dfdtc/KU5P_Core/KU5P_Core.kicad_pcb

## KiCad design KU5P_Core.kicad_pcb (2026-09-22)

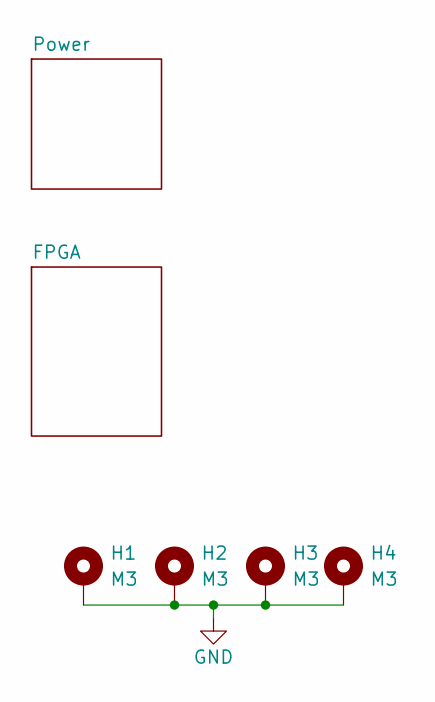
[picture p1: schematic KU5P_Core.kicad_sch]

Parts:
H1, H2, H3, H4: M3; MountingHole_3mm_Pad_TopBottom

Connections:
GND: H1.1 (1_1), H2.1 (1_1), H3.1 (1_1), H4.1 (1_1); also elsewhere on the board

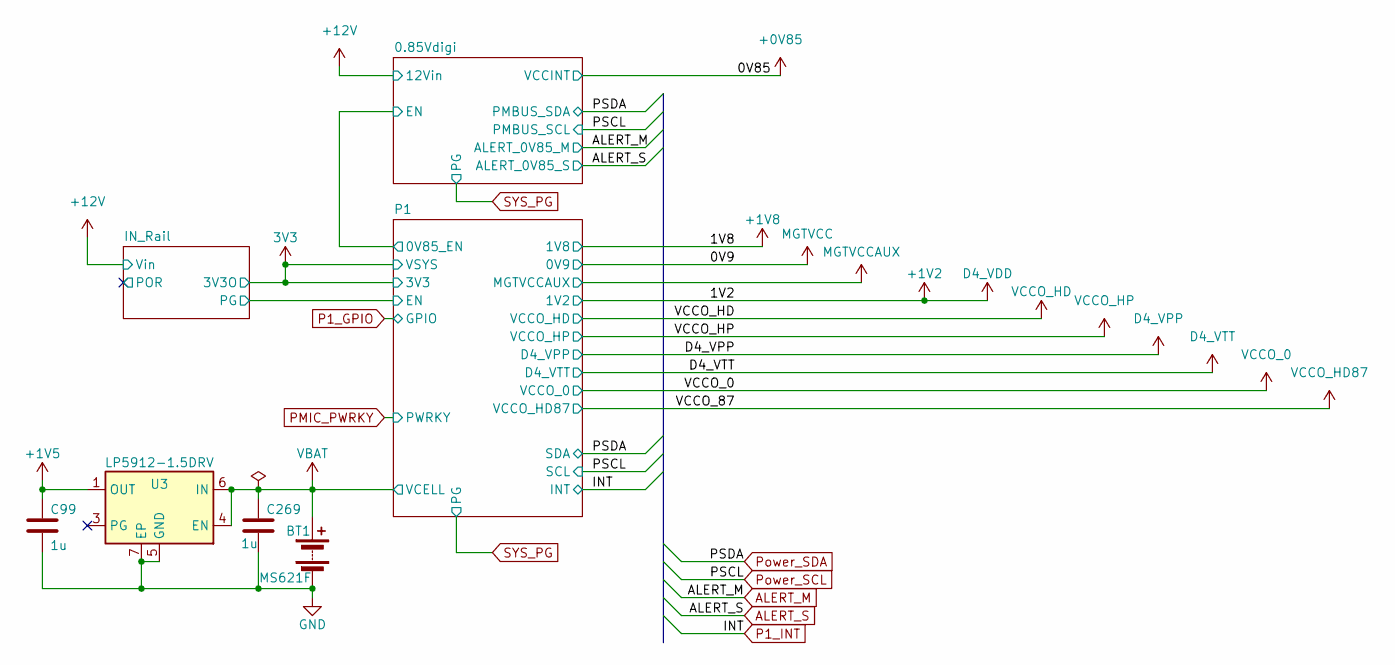
[picture p2: schematic Power.kicad_sch]

Parts:
BT1: MS621F; BatteryHolder_Seiko_MS621F
C99, C269: 1u; C_0402_1005Metric
U3: LP5912-1.5DRV; WSON-6-1EP_2x2mm_P0.65mm_EP1x1.6mm

Connections:
+1V5: C99.1, U3.1 (OUT); also elsewhere on the board
GND: BT1.2 (-), C99.2, C269.2, U3.5 (GND), U3.7 (EP); also elsewhere on the board
VBAT: BT1.1 (+), C269.1, U3.4 (EN), U3.6 (IN); also elsewhere on the board

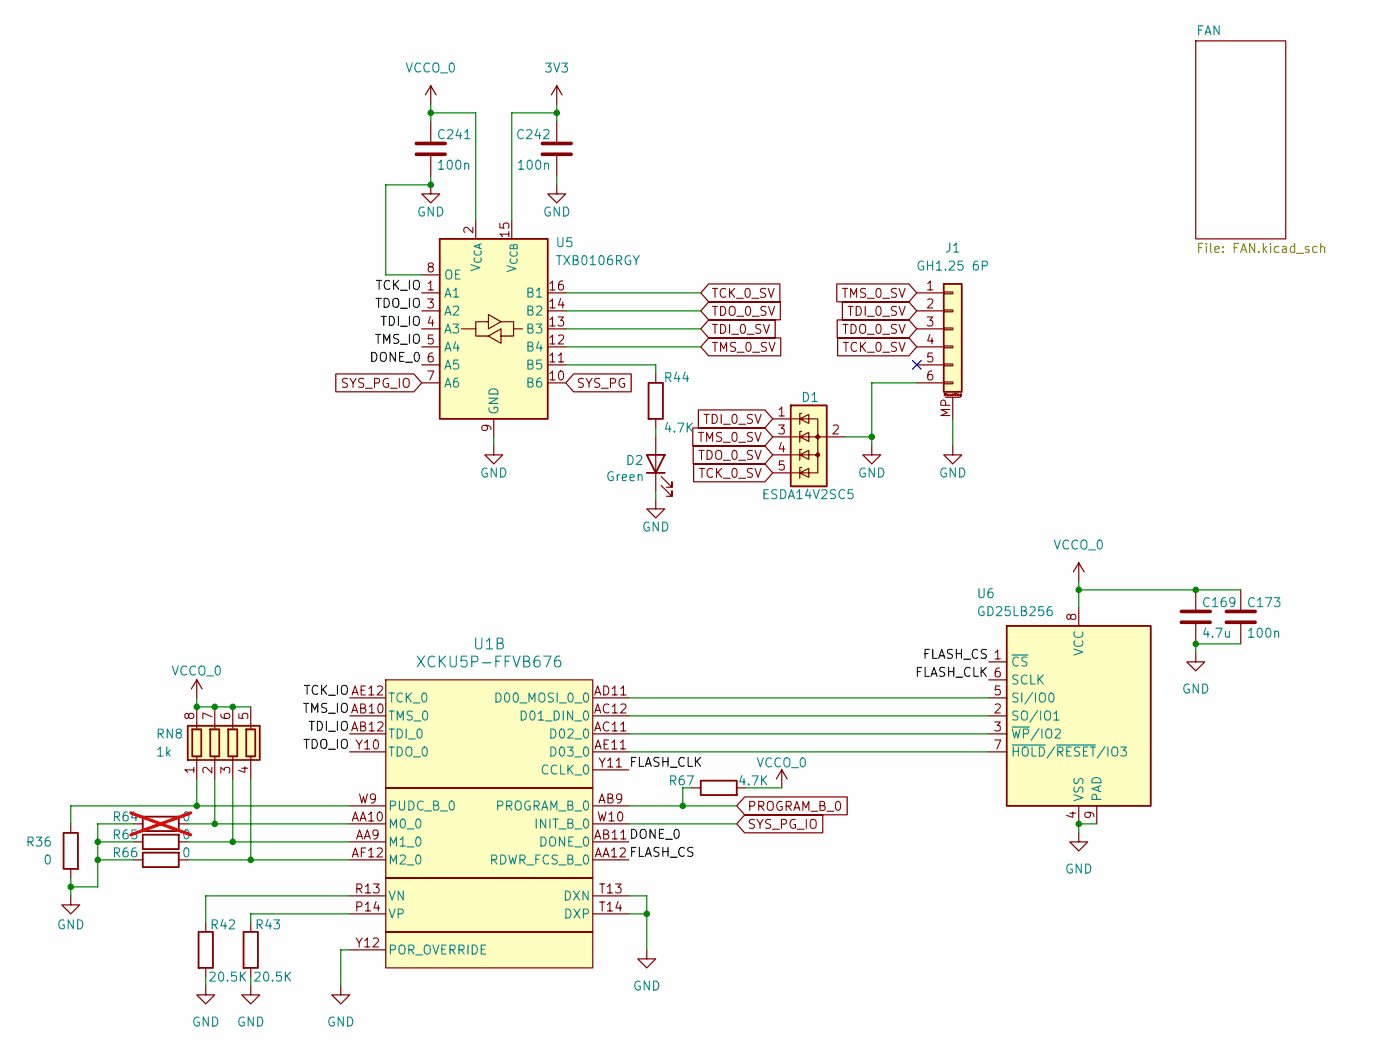
[picture p3: schematic FPGA_SYS.kicad_sch]

Parts:
C169: 4.7u; C_0201_0603Metric
C173, C241, C242: 100n; C_0201_0603Metric
D1: ESDA14V2SC5; SOT-23-5
D2: Green; LED_0603_1608Metric
J1: GH1.25 6P; JST_GH_SM06B-GHS-TB_1x06-1MP_P1.25mm_Horizontal
R36, R65, R66: 0; R_0402_1005Metric
R42, R43: 20.5K; R_0201_0603Metric
R44, R67: 4.7K; R_0201_0603Metric
R64: 0; R_0402_1005Metric; not fitted
RN8: 1k; R_Array_Concave_4x0402
U1: XCKU5P-FFVB676; Xilinx_FFG676
U5: TXB0106RGY; Texas_RGY_R-PVQFN-N16_EP2.05x2.55mm
U6: GD25LB256; WSON-8-1EP_8x6mm_P1.27mm_EP3.4x4.3mm

Connections:
3V3: C242.1, U5.15 (V_{CCB}); also elsewhere on the board
/FPGA/FPGA_SYS/DONE_0: U1.AB11 (DONE_0), U5.6 (A5)
/FPGA/FPGA_SYS/FLASH_CLK: U1.Y11 (CCLK_0), U6.6 (SCLK)
/FPGA/FPGA_SYS/FLASH_CS: U1.AA12 (RDWR_FCS_B_0), U6.1 (~CS)
/FPGA/FPGA_SYS/TCK_IO: U1.AE12 (TCK_0), U5.1 (A1)
/FPGA/FPGA_SYS/TDI_IO: U1.AB12 (TDI_0), U5.4 (A3)
/FPGA/FPGA_SYS/TDO_IO: U1.Y10 (TDO_0), U5.3 (A2)
/FPGA/FPGA_SYS/TMS_IO: U1.AB10 (TMS_0), U5.5 (A4)
GND: C169.2, C173.2, C241.2, C242.2, D1.2 (A), D2.1 (K), J1.6, J1.MP (MountPin), R36.2, R42.2, R43.2, R64.1, R65.1, R66.1, U1.T13 (DXN), U1.T14 (DXP), U1.Y12 (POR_OVERRIDE), U5.8 (OE), U5.9 (GND), U5.17 (GND), U6.4 (VSS), U6.9 (PAD); also elsewhere on the board
unnamed: D2.2 (A), R44.2
unnamed: R36.1, RN8.1 (R1.1), U1.W9 (PUDC_B_0)
unnamed: R64.2, RN8.2 (R2.1), U1.AA10 (M0_0)
unnamed: R65.2, RN8.3 (R3.1), U1.AA9 (M1_0)
unnamed: R66.2, RN8.4 (R4.1), U1.AF12 (M2_0)
unnamed: U1.AD11 (D00_MOSI_0_0), U6.5 (SI/IO0)
unnamed: U1.AC12 (D01_DIN_0), U6.2 (SO/IO1)
unnamed: U1.AC11 (D02_0), U6.3 (~WP/IO2)
unnamed: U1.AE11 (D03_0), U6.7 (~HOLD/~RESET/IO3)
unnamed: R42.1, U1.R13 (VN)
unnamed: R43.1, U1.P14 (VP)
unnamed: R44.1, U5.11 (B5)
PROGRAM_B_0: R67.1, U1.AB9 (PROGRAM_B_0); also elsewhere on the board
SYS_PG: U5.10 (B6); also elsewhere on the board
SYS_PG_IO: U1.W10 (INIT_B_0), U5.7 (A6)
TCK_0_SV: D1.5 (K), J1.4, U5.16 (B1)
TDI_0_SV: D1.1 (K), J1.2, U5.13 (B3)
TDO_0_SV: D1.4 (K), J1.3, U5.14 (B2)
TMS_0_SV: D1.3 (K), J1.1, U5.12 (B4)
VCCO_0: C169.1, C173.1, C241.1, R67.2, RN8.5 (R4.2), RN8.6 (R3.2), RN8.7 (R2.2), RN8.8 (R1.2), U5.2 (V_{CCA}), U6.8 (VCC); also elsewhere on the board

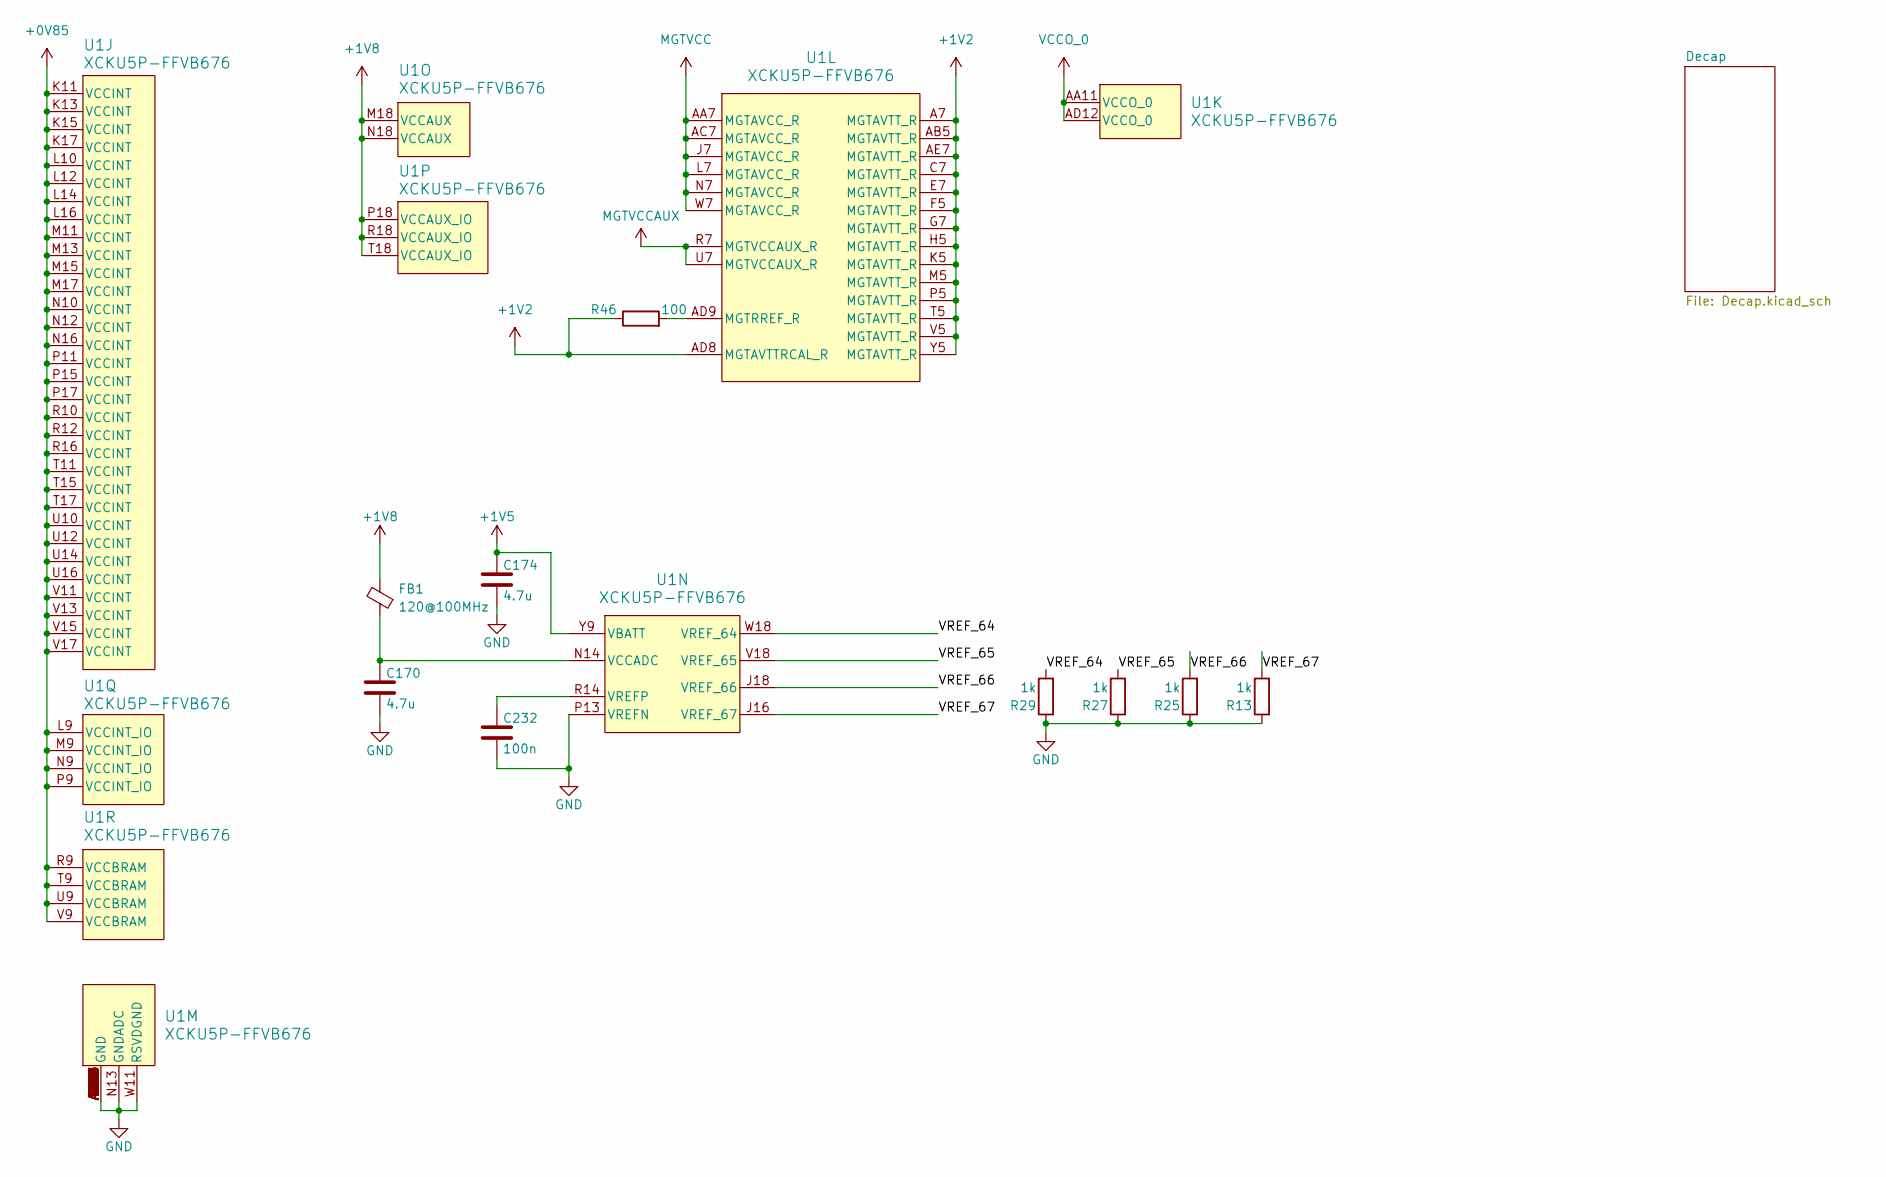
[picture p4: schematic FPGA_Power.kicad_sch]

Parts:
C170, C174: 4.7u; C_0201_0603Metric
C232: 100n; C_0201_0603Metric
FB1: 120@100MHz; C_0402_1005Metric
R13, R25, R27, R29: 1k; R_0201_0603Metric
R46: 100; C_0201_0603Metric
U1: XCKU5P-FFVB676; Xilinx_FFG676

Connections:
+0V85: U1.K11 (VCCINT), U1.K13 (VCCINT), U1.K15 (VCCINT), U1.K17 (VCCINT), U1.L9 (VCCINT_IO), U1.L10 (VCCINT), U1.L12 (VCCINT), U1.L14 (VCCINT), U1.L16 (VCCINT), U1.M9 (VCCINT_IO), U1.M11 (VCCINT), U1.M13 (VCCINT), U1.M15 (VCCINT), U1.M17 (VCCINT), U1.N9 (VCCINT_IO), U1.N10 (VCCINT), U1.N12 (VCCINT), U1.N16 (VCCINT), U1.P9 (VCCINT_IO), U1.P11 (VCCINT), U1.P15 (VCCINT), U1.P17 (VCCINT), U1.R9 (VCCBRAM), U1.R10 (VCCINT), U1.R12 (VCCINT), U1.R16 (VCCINT), U1.T9 (VCCBRAM), U1.T11 (VCCINT), U1.T15 (VCCINT), U1.T17 (VCCINT), U1.U9 (VCCBRAM), U1.U10 (VCCINT), U1.U12 (VCCINT), U1.U14 (VCCINT), U1.U16 (VCCINT), U1.V9 (VCCBRAM), U1.V11 (VCCINT), U1.V13 (VCCINT), U1.V15 (VCCINT), U1.V17 (VCCINT); also elsewhere on the board
+1V5: C174.1, U1.Y9 (VBATT); also elsewhere on the board
+1V8: FB1.2, U1.M18 (VCCAUX), U1.N18 (VCCAUX), U1.P18 (VCCAUX_IO), U1.R18 (VCCAUX_IO), U1.T18 (VCCAUX_IO); also elsewhere on the board
/FPGA/FPGA_Power/VREF_64: R29.2, U1.W18 (VREF_64)
/FPGA/FPGA_Power/VREF_65: R27.2, U1.V18 (VREF_65)
/FPGA/FPGA_Power/VREF_66: R25.2, U1.J18 (VREF_66)
/FPGA/FPGA_Power/VREF_67: R13.2, U1.J16 (VREF_67)
GND: C170.2, C174.2, C232.2, R13.1, R25.1, R27.1, R29.1, U1.A1 (GND), U1.A2 (GND), U1.A5 (GND), U1.A6 (GND), U1.A8 (GND), U1.A11 (GND), U1.A16 (GND), U1.A21 (GND), U1.A26 (GND), U1.AA1 (GND), U1.AA2 (GND), U1.AA3 (GND), U1.AA6 (GND), U1.AA8 (GND), U1.AA16 (GND), U1.AA26 (GND), U1.AB3 (GND), U1.AB4 (GND), U1.AB8 (GND), U1.AB13 (GND), U1.AB23 (GND), U1.AC1 (GND), U1.AC2 (GND), U1.AC3 (GND), U1.AC6 (GND), U1.AC8 (GND), U1.AC9 (GND), U1.AC10 (GND), U1.AC20 (GND), U1.AC25 (GND), U1.AD3 (GND), U1.AD4 (GND), U1.AD5 (GND), U1.AD10 (GND), U1.AD17 (GND), U1.AE1 (GND), U1.AE2 (GND), U1.AE5 (GND), U1.AE6 (GND), U1.AE10 (GND), U1.AE14 (GND), U1.AE19 (GND), U1.AE24 (GND), U1.AF3 (GND), U1.AF4 (GND), U1.AF5 (GND), U1.AF8 (GND), U1.AF9 (GND), U1.AF10 (GND), U1.AF11 (GND), U1.AF16 (GND), U1.AF21 (GND), U1.AF26 (GND), U1.B3 (GND), U1.B4 (GND), U1.B5 (GND), U1.B8 (GND), U1.B13 (GND), U1.B18 (GND), U1.B23 (GND), U1.C1 (GND), U1.C2 (GND), U1.C5 (GND), U1.C6 (GND), U1.C8 (GND), U1.C10 (GND), U1.C15 (GND), U1.C25 (GND), U1.D3 (GND), U1.D4 (GND), U1.D5 (GND), U1.D8 (GND), U1.D12 (GND), U1.D22 (GND), U1.E1 (GND), U1.E2 (GND), U1.E3 (GND), U1.E6 (GND), U1.E8 (GND), U1.E19 (GND), U1.F3 (GND), U1.F4 (GND), U1.F8 (GND), U1.F11 (GND), U1.F16 (GND), U1.F21 (GND), U1.F26 (GND), U1.G1 (GND), U1.G2 (GND), U1.G3 (GND), U1.G6 (GND), U1.G8 (GND), U1.G13 (GND), U1.G23 (GND), U1.H3 (GND), U1.H4 (GND), U1.H8 (GND), U1.H20 (GND), U1.J1 (GND), U1.J2 (GND), U1.J3 (GND), U1.J6 (GND), U1.J8 (GND), U1.J17 (GND), U1.K3 (GND), U1.K4 (GND), U1.K8 (GND), U1.K12 (GND), U1.K14 (GND), U1.K16 (GND), U1.K19 (GND), U1.K24 (GND), U1.L1 (GND), U1.L2 (GND), U1.L3 (GND), U1.L6 (GND), U1.L8 (GND), U1.L11 (GND), U1.L13 (GND), U1.L15 (GND), U1.L17 (GND), U1.L21 (GND), U1.L26 (GND), U1.M3 (GND), U1.M4 (GND), U1.M8 (GND), U1.M10 (GND), U1.M12 (GND), U1.M14 (GND), U1.M16 (GND), U1.M23 (GND), U1.N1 (GND), U1.N2 (GND), U1.N3 (GND), U1.N6 (GND), U1.N8 (GND), U1.N11 (GND), U1.N13 (GNDADC), U1.N15 (GND), U1.N17 (GND), U1.N20 (GND), U1.N25 (GND), U1.P3 (GND), U1.P4 (GND), U1.P8 (GND), U1.P10 (GND), U1.P12 (GND), U1.P13 (VREFN), U1.P16 (GND), U1.R1 (GND), U1.R2 (GND), U1.R3 (GND), U1.R6 (GND), U1.R8 (GND), U1.R11 (GND), U1.R15 (GND), U1.R17 (GND), U1.R19 (GND), U1.R24 (GND), U1.T3 (GND), U1.T4 (GND), U1.T8 (GND), U1.T10 (GND), U1.T12 (GND), U1.T16 (GND), U1.T21 (GND), U1.T26 (GND), U1.U1 (GND), U1.U2 (GND), U1.U3 (GND), U1.U6 (GND), U1.U8 (GND), U1.U11 (GND), U1.U13 (GND), U1.U15 (GND), U1.U17 (GND), U1.U18 (GND), U1.V3 (GND), U1.V4 (GND), U1.V8 (GND), U1.V10 (GND), U1.V12 (GND), U1.V14 (GND), U1.V16 (GND), U1.V20 (GND), U1.V25 (GND), U1.W1 (GND), U1.W2 (GND), U1.W3 (GND), U1.W6 (GND), U1.W8 (GND), U1.W11 (RSVDGND), U1.W17 (GND), U1.W22 (GND), U1.Y3 (GND), U1.Y4 (GND), U1.Y8 (GND), U1.Y19 (GND); also elsewhere on the board
MGTVCC: U1.AA7 (MGTAVCC_R), U1.AC7 (MGTAVCC_R), U1.J7 (MGTAVCC_R), U1.L7 (MGTAVCC_R), U1.N7 (MGTAVCC_R), U1.W7 (MGTAVCC_R); also elsewhere on the board
MGTVCCAUX: U1.R7 (MGTVCCAUX_R), U1.U7 (MGTVCCAUX_R); also elsewhere on the board
unnamed: R46.2, U1.AD9 (MGTRREF_R)
unnamed: C170.1, FB1.1, U1.N14 (VCCADC)
unnamed: C232.1, U1.R14 (VREFP)
VCCO_0: U1.AA11 (VCCO_0), U1.AD12 (VCCO_0); also elsewhere on the board

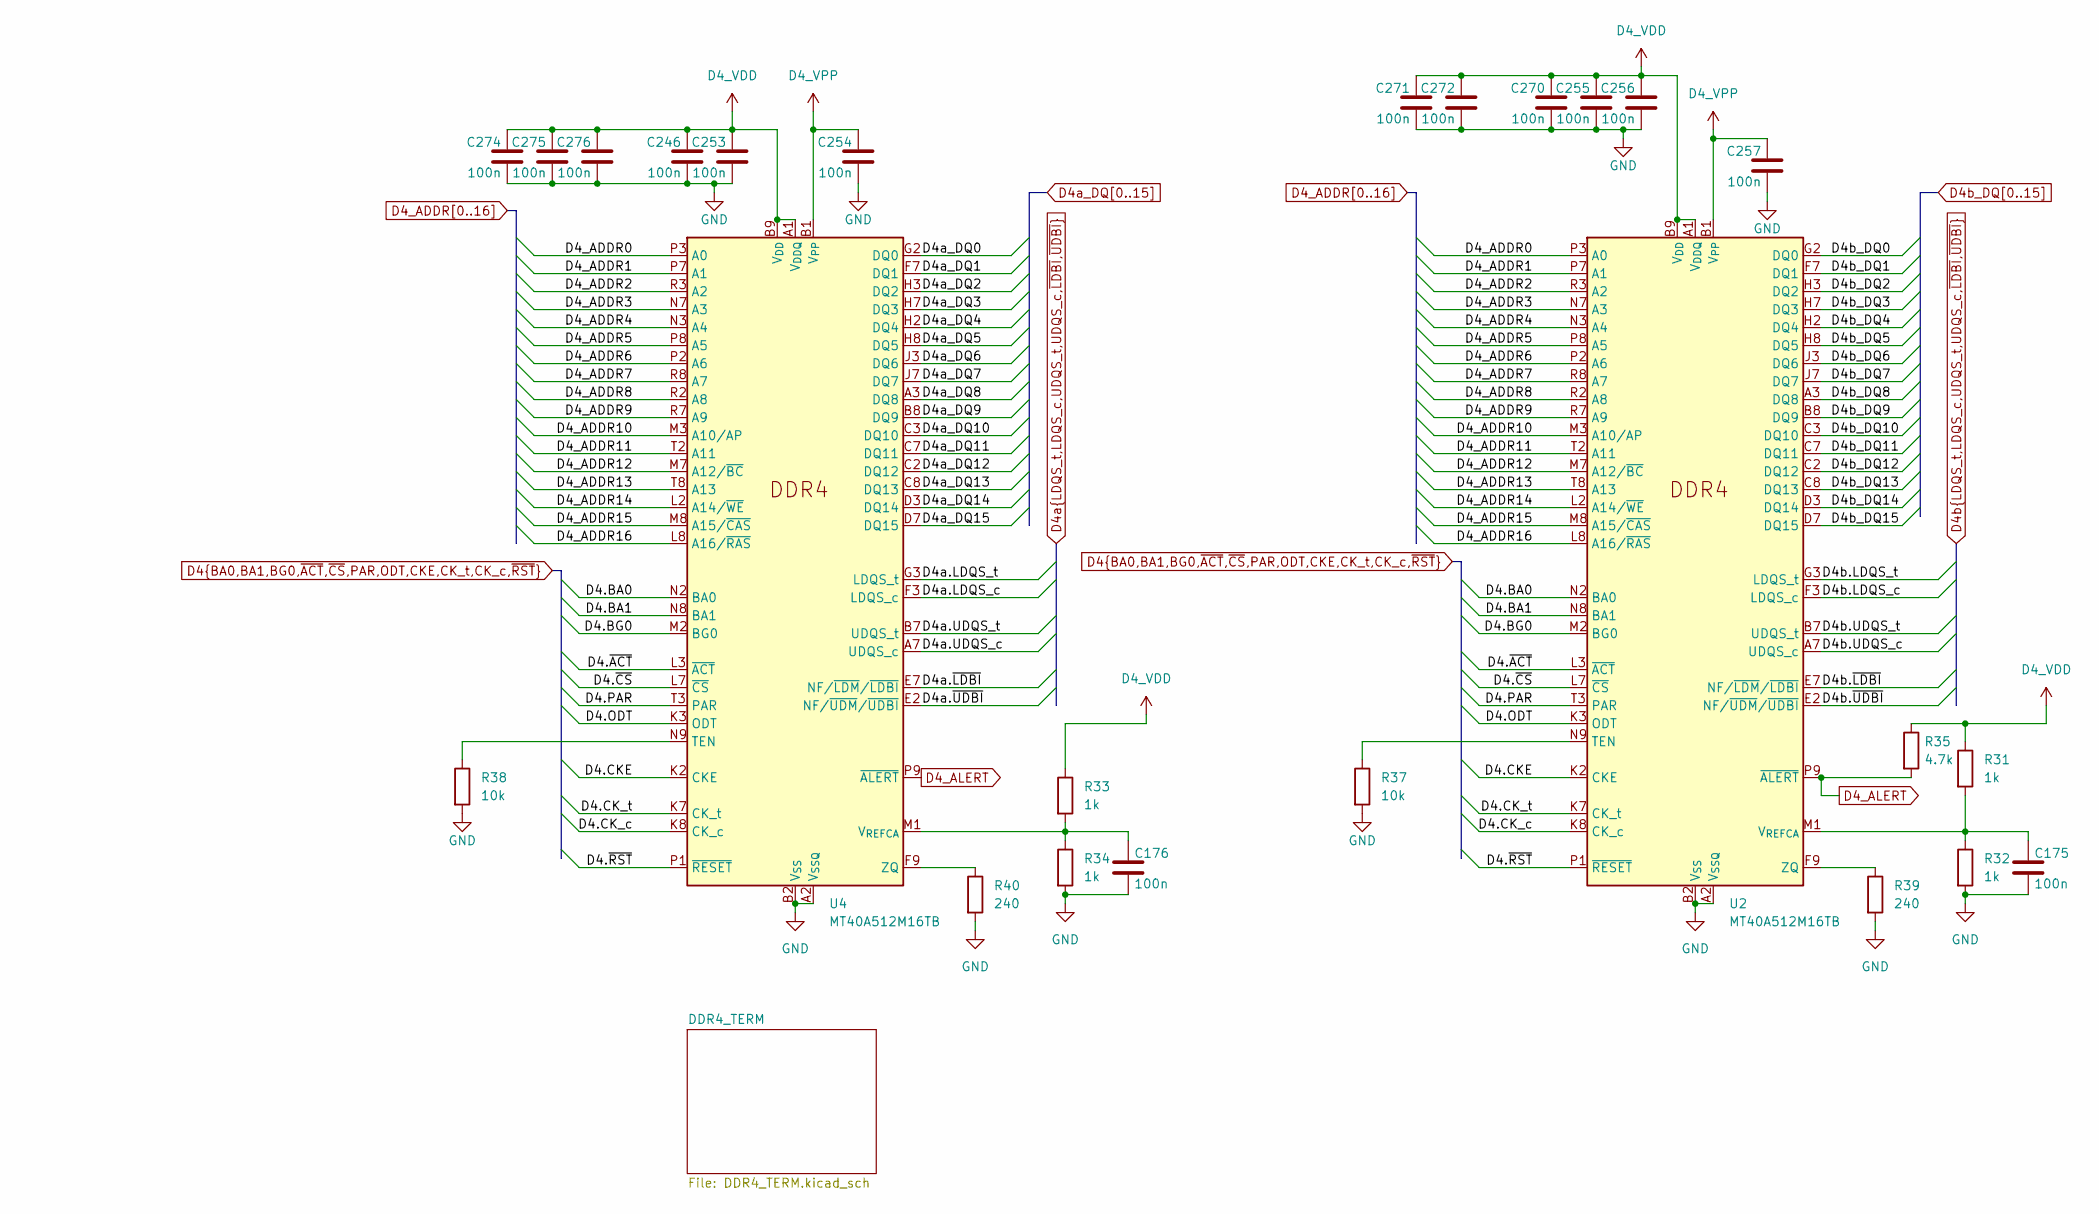
[picture p5: schematic DDR4.kicad_sch]

Parts:
C175, C176, C246, C253, C254, C255, C256, C257, C270, C271, C272, C274, C275, C276: 100n; C_0201_0603Metric
R31, R32, R33, R34: 1k; R_0201_0603Metric
R35: 4.7k; R_0201_0603Metric
R37, R38: 10k; R_0201_0603Metric
R39, R40: 240; R_0201_0603Metric
U2, U4: MT40A512M16TB; FBGA-96_7.5x13mm_Layout9x16_P0.8mm

Connections:
D4.BA0: U2.N2 (BA0), U4.N2 (BA0); also elsewhere on the board
D4.BA1: U2.N8 (BA1), U4.N8 (BA1); also elsewhere on the board
D4.BG0: U2.M2 (BG0), U4.M2 (BG0); also elsewhere on the board
D4.CKE: U2.K2 (CKE), U4.K2 (CKE); also elsewhere on the board
D4.CK_c: U2.K8 (CK_c), U4.K8 (CK_c); also elsewhere on the board
D4.CK_t: U2.K7 (CK_t), U4.K7 (CK_t); also elsewhere on the board
D4.ODT: U2.K3 (ODT), U4.K3 (ODT); also elsewhere on the board
D4.PAR: U2.T3 (PAR), U4.T3 (PAR); also elsewhere on the board
D4.~ACT: U2.L3 (~ACT), U4.L3 (~ACT); also elsewhere on the board
D4.~CS: U2.L7 (~CS), U4.L7 (~CS); also elsewhere on the board
D4.~RST: U2.P1 (~RESET), U4.P1 (~RESET); also elsewhere on the board
D4_ADDR0: U2.P3 (A0), U4.P3 (A0); also elsewhere on the board
D4_ADDR1: U2.P7 (A1), U4.P7 (A1); also elsewhere on the board
D4_ADDR2: U2.R3 (A2), U4.R3 (A2); also elsewhere on the board
D4_ADDR3: U2.N7 (A3), U4.N7 (A3); also elsewhere on the board
D4_ADDR4: U2.N3 (A4), U4.N3 (A4); also elsewhere on the board
D4_ADDR5: U2.P8 (A5), U4.P8 (A5); also elsewhere on the board
D4_ADDR6: U2.P2 (A6), U4.P2 (A6); also elsewhere on the board
D4_ADDR7: U2.R8 (A7), U4.R8 (A7); also elsewhere on the board
D4_ADDR8: U2.R2 (A8), U4.R2 (A8); also elsewhere on the board
D4_ADDR9: U2.R7 (A9), U4.R7 (A9); also elsewhere on the board
D4_ADDR10: U2.M3 (A10/AP), U4.M3 (A10/AP); also elsewhere on the board
D4_ADDR11: U2.T2 (A11), U4.T2 (A11); also elsewhere on the board
D4_ADDR12: U2.M7 (A12/~BC), U4.M7 (A12/~BC); also elsewhere on the board
D4_ADDR13: U2.T8 (A13), U4.T8 (A13); also elsewhere on the board
D4_ADDR14: U2.L2 (A14/~WE), U4.L2 (A14/~WE); also elsewhere on the board
D4_ADDR15: U2.M8 (A15/~CAS), U4.M8 (A15/~CAS); also elsewhere on the board
D4_ADDR16: U2.L8 (A16/~RAS), U4.L8 (A16/~RAS); also elsewhere on the board
D4_ALERT: R35.2, U2.P9 (~ALERT), U4.P9 (~ALERT)
D4_VPP: C254.1, C257.1, U2.B1 (V_{PP}), U2.R9 (V_{PP}), U4.B1 (V_{PP}), U4.R9 (V_{PP}); also elsewhere on the board
D4a.LDQS_c: U4.F3 (LDQS_c); also elsewhere on the board
D4a.LDQS_t: U4.G3 (LDQS_t); also elsewhere on the board
D4a.UDQS_c: U4.A7 (UDQS_c); also elsewhere on the board
D4a.UDQS_t: U4.B7 (UDQS_t); also elsewhere on the board
D4a.~LDBI: U4.E7 (NF/~LDM/~LDBI); also elsewhere on the board
D4a.~UDBI: U4.E2 (NF/~UDM/~UDBI); also elsewhere on the board
D4a_DQ0: U4.G2 (DQ0); also elsewhere on the board
D4a_DQ1: U4.F7 (DQ1); also elsewhere on the board
D4a_DQ2: U4.H3 (DQ2); also elsewhere on the board
D4a_DQ3: U4.H7 (DQ3); also elsewhere on the board
D4a_DQ4: U4.H2 (DQ4); also elsewhere on the board
D4a_DQ5: U4.H8 (DQ5); also elsewhere on the board
D4a_DQ6: U4.J3 (DQ6); also elsewhere on the board
D4a_DQ7: U4.J7 (DQ7); also elsewhere on the board
D4a_DQ8: U4.A3 (DQ8); also elsewhere on the board
D4a_DQ9: U4.B8 (DQ9); also elsewhere on the board
D4a_DQ10: U4.C3 (DQ10); also elsewhere on the board
D4a_DQ11: U4.C7 (DQ11); also elsewhere on the board
D4a_DQ12: U4.C2 (DQ12); also elsewhere on the board
D4a_DQ13: U4.C8 (DQ13); also elsewhere on the board
D4a_DQ14: U4.D3 (DQ14); also elsewhere on the board
D4a_DQ15: U4.D7 (DQ15); also elsewhere on the board
D4b.LDQS_c: U2.F3 (LDQS_c); also elsewhere on the board
D4b.LDQS_t: U2.G3 (LDQS_t); also elsewhere on the board
D4b.UDQS_c: U2.A7 (UDQS_c); also elsewhere on the board
D4b.UDQS_t: U2.B7 (UDQS_t); also elsewhere on the board
D4b.~LDBI: U2.E7 (NF/~LDM/~LDBI); also elsewhere on the board
D4b.~UDBI: U2.E2 (NF/~UDM/~UDBI); also elsewhere on the board
D4b_DQ0: U2.G2 (DQ0); also elsewhere on the board
D4b_DQ1: U2.F7 (DQ1); also elsewhere on the board
D4b_DQ2: U2.H3 (DQ2); also elsewhere on the board
D4b_DQ3: U2.H7 (DQ3); also elsewhere on the board
D4b_DQ4: U2.H2 (DQ4); also elsewhere on the board
D4b_DQ5: U2.H8 (DQ5); also elsewhere on the board
D4b_DQ6: U2.J3 (DQ6); also elsewhere on the board
D4b_DQ7: U2.J7 (DQ7); also elsewhere on the board
D4b_DQ8: U2.A3 (DQ8); also elsewhere on the board
D4b_DQ9: U2.B8 (DQ9); also elsewhere on the board
D4b_DQ10: U2.C3 (DQ10); also elsewhere on the board
D4b_DQ11: U2.C7 (DQ11); also elsewhere on the board
D4b_DQ12: U2.C2 (DQ12); also elsewhere on the board
D4b_DQ13: U2.C8 (DQ13); also elsewhere on the board
D4b_DQ14: U2.D3 (DQ14); also elsewhere on the board
D4b_DQ15: U2.D7 (DQ15); also elsewhere on the board
GND: C175.2, C176.2, C246.2, C253.2, C254.2, C255.2, C256.2, C257.2, C270.2, C271.2, C272.2, C274.2, C275.2, C276.2, R32.2, R34.2, R37.2, R38.2, R39.2, R40.2, U2.A2 (V_{SSQ}), U2.A8 (V_{SSQ}), U2.B2 (V_{SS}), U2.C9 (V_{SSQ}), U2.D2 (V_{SSQ}), U2.D8 (V_{SSQ}), U2.E1 (V_{SS}), U2.E3 (V_{SSQ}), U2.E8 (V_{SSQ}), U2.E9 (V_{SS}), U2.F1 (V_{SSQ}), U2.G8 (V_{SS}), U2.H1 (V_{SSQ}), U2.H9 (V_{SSQ}), U2.K1 (V_{SS}), U2.K9 (V_{SS}), U2.M9 (V_{SS}), U2.N1 (V_{SS}), U2.T1 (V_{SS}), U4.A2 (V_{SSQ}), U4.A8 (V_{SSQ}), U4.B2 (V_{SS}), U4.C9 (V_{SSQ}), U4.D2 (V_{SSQ}), U4.D8 (V_{SSQ}), U4.E1 (V_{SS}), U4.E3 (V_{SSQ}), U4.E8 (V_{SSQ}), U4.E9 (V_{SS}), U4.F1 (V_{SSQ}), U4.G8 (V_{SS}), U4.H1 (V_{SSQ}), U4.H9 (V_{SSQ}), U4.K1 (V_{SS}), U4.K9 (V_{SS}), U4.M9 (V_{SS}), U4.N1 (V_{SS}), U4.T1 (V_{SS}); also elsewhere on the board
unnamed: R37.1, U2.N9 (TEN)
unnamed: C175.1, R31.2, R32.1, U2.M1 (V_{REFCA})
unnamed: R39.1, U2.F9 (ZQ)
unnamed: R38.1, U4.N9 (TEN)
unnamed: C176.1, R33.2, R34.1, U4.M1 (V_{REFCA})
unnamed: R40.1, U4.F9 (ZQ)

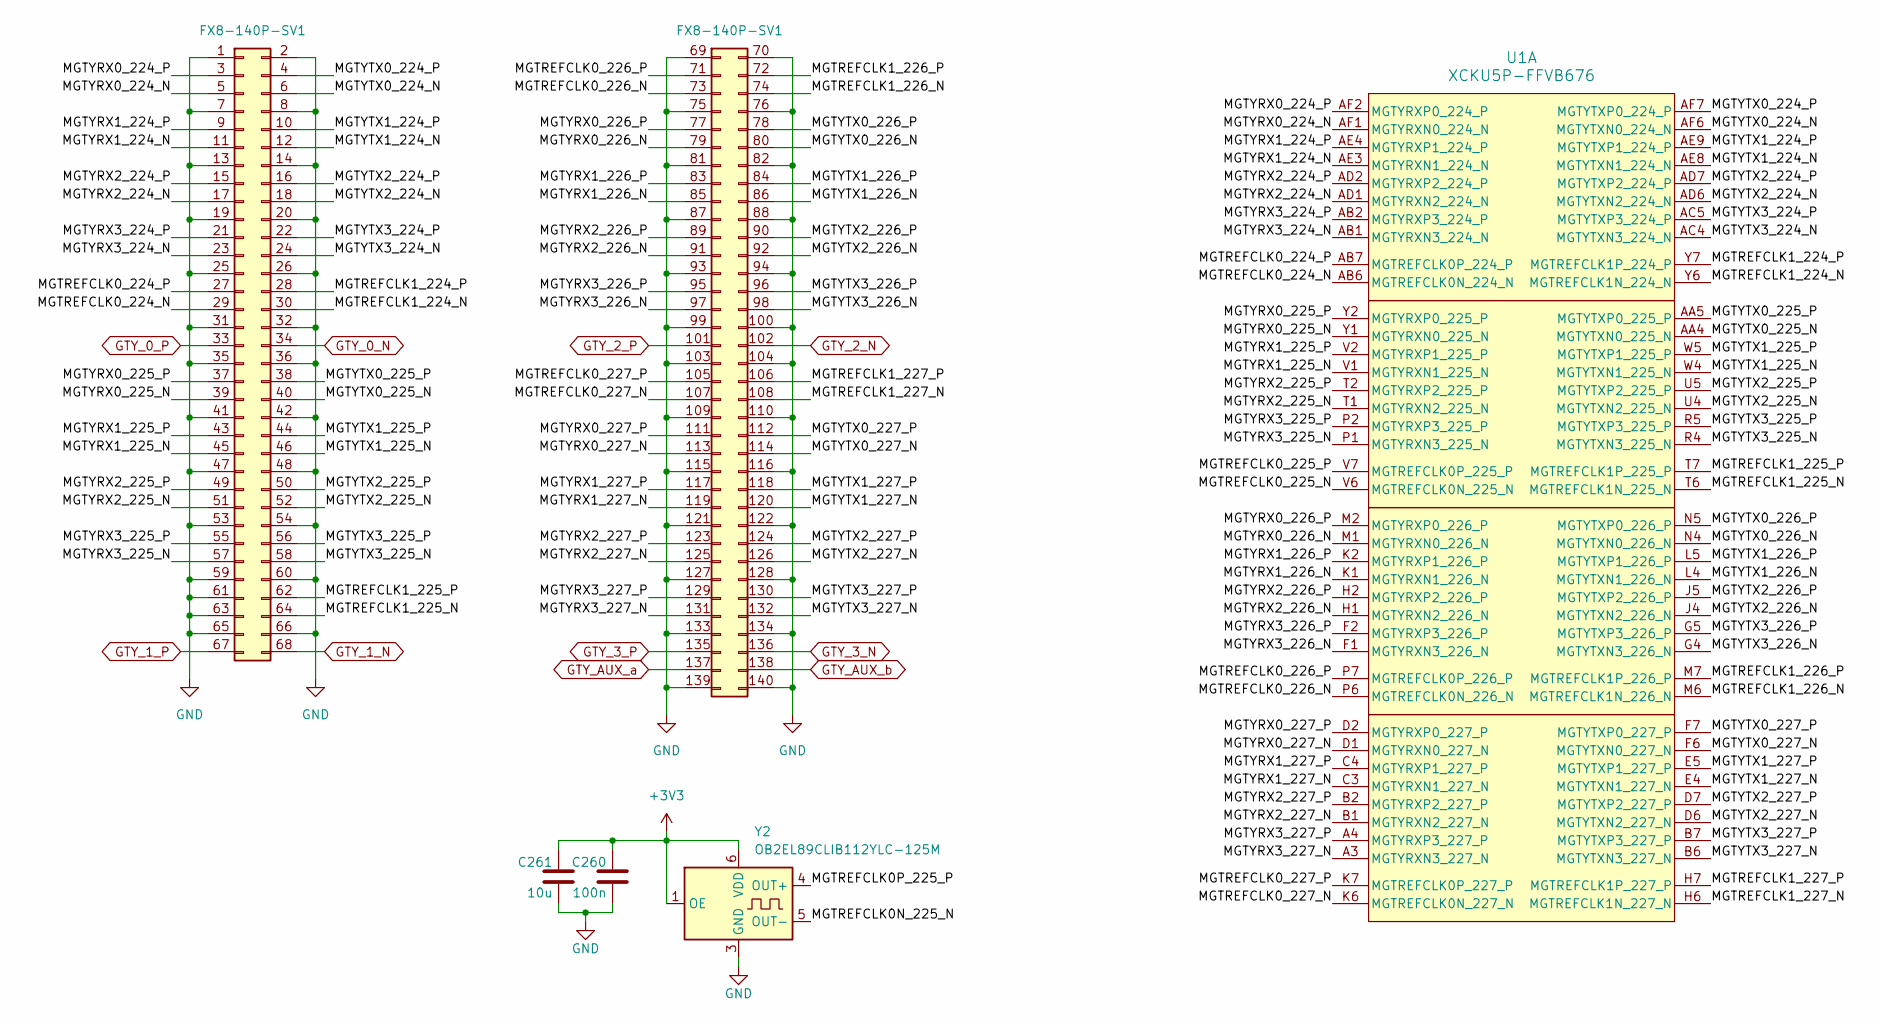
[picture p6: schematic GTY.kicad_sch]

Parts:
C260: 100n; C_0201_0603Metric
C261: 10u; C_0603_1608Metric
J5: FX8-140P-SV1; Hirose_FX8-140P-SV_2x70_P0.6mm
U1: XCKU5P-FFVB676; Xilinx_FFG676
Y2: OB2EL89CLIB112YLC-125M; Oscillator_SMD_SiTime_PQFD-6L_3.2x2.5mm

Connections:
+3V3: C260.1, C261.1, Y2.1 (OE), Y2.6 (VDD); also elsewhere on the board
/FPGA/GTY/MGTREFCLK0N_225_N: Y2.5 (OUT-)
/FPGA/GTY/MGTREFCLK0P_225_P: Y2.4 (OUT+)
/FPGA/GTY/MGTREFCLK0_224_N: J5.29, U1.AB6 (MGTREFCLK0N_224_N)
/FPGA/GTY/MGTREFCLK0_224_P: J5.27, U1.AB7 (MGTREFCLK0P_224_P)
/FPGA/GTY/MGTREFCLK0_225_N: U1.V6 (MGTREFCLK0N_225_N)
/FPGA/GTY/MGTREFCLK0_225_P: U1.V7 (MGTREFCLK0P_225_P)
/FPGA/GTY/MGTREFCLK0_226_N: J5.73, U1.P6 (MGTREFCLK0N_226_N)
/FPGA/GTY/MGTREFCLK0_226_P: J5.71, U1.P7 (MGTREFCLK0P_226_P)
/FPGA/GTY/MGTREFCLK0_227_N: J5.107, U1.K6 (MGTREFCLK0N_227_N)
/FPGA/GTY/MGTREFCLK0_227_P: J5.105, U1.K7 (MGTREFCLK0P_227_P)
/FPGA/GTY/MGTREFCLK1_224_N: J5.30, U1.Y6 (MGTREFCLK1N_224_N)
/FPGA/GTY/MGTREFCLK1_224_P: J5.28, U1.Y7 (MGTREFCLK1P_224_P)
/FPGA/GTY/MGTREFCLK1_225_N: J5.64, U1.T6 (MGTREFCLK1N_225_N)
/FPGA/GTY/MGTREFCLK1_225_P: J5.62, U1.T7 (MGTREFCLK1P_225_P)
/FPGA/GTY/MGTREFCLK1_226_N: J5.74, U1.M6 (MGTREFCLK1N_226_N)
/FPGA/GTY/MGTREFCLK1_226_P: J5.72, U1.M7 (MGTREFCLK1P_226_P)
/FPGA/GTY/MGTREFCLK1_227_N: J5.108, U1.H6 (MGTREFCLK1N_227_N)
/FPGA/GTY/MGTREFCLK1_227_P: J5.106, U1.H7 (MGTREFCLK1P_227_P)
/FPGA/GTY/MGTYRX0_224_N: J5.5, U1.AF1 (MGTYRXN0_224_N)
/FPGA/GTY/MGTYRX0_224_P: J5.3, U1.AF2 (MGTYRXP0_224_P)
/FPGA/GTY/MGTYRX0_225_N: J5.39, U1.Y1 (MGTYRXN0_225_N)
/FPGA/GTY/MGTYRX0_225_P: J5.37, U1.Y2 (MGTYRXP0_225_P)
/FPGA/GTY/MGTYRX0_226_N: J5.79, U1.M1 (MGTYRXN0_226_N)
/FPGA/GTY/MGTYRX0_226_P: J5.77, U1.M2 (MGTYRXP0_226_P)
/FPGA/GTY/MGTYRX0_227_N: J5.113, U1.D1 (MGTYRXN0_227_N)
/FPGA/GTY/MGTYRX0_227_P: J5.111, U1.D2 (MGTYRXP0_227_P)
/FPGA/GTY/MGTYRX1_224_N: J5.11, U1.AE3 (MGTYRXN1_224_N)
/FPGA/GTY/MGTYRX1_224_P: J5.9, U1.AE4 (MGTYRXP1_224_P)
/FPGA/GTY/MGTYRX1_225_N: J5.45, U1.V1 (MGTYRXN1_225_N)
/FPGA/GTY/MGTYRX1_225_P: J5.43, U1.V2 (MGTYRXP1_225_P)
/FPGA/GTY/MGTYRX1_226_N: J5.85, U1.K1 (MGTYRXN1_226_N)
/FPGA/GTY/MGTYRX1_226_P: J5.83, U1.K2 (MGTYRXP1_226_P)
/FPGA/GTY/MGTYRX1_227_N: J5.119, U1.C3 (MGTYRXN1_227_N)
/FPGA/GTY/MGTYRX1_227_P: J5.117, U1.C4 (MGTYRXP1_227_P)
/FPGA/GTY/MGTYRX2_224_N: J5.17, U1.AD1 (MGTYRXN2_224_N)
/FPGA/GTY/MGTYRX2_224_P: J5.15, U1.AD2 (MGTYRXP2_224_P)
/FPGA/GTY/MGTYRX2_225_N: J5.51, U1.T1 (MGTYRXN2_225_N)
/FPGA/GTY/MGTYRX2_225_P: J5.49, U1.T2 (MGTYRXP2_225_P)
/FPGA/GTY/MGTYRX2_226_N: J5.91, U1.H1 (MGTYRXN2_226_N)
/FPGA/GTY/MGTYRX2_226_P: J5.89, U1.H2 (MGTYRXP2_226_P)
/FPGA/GTY/MGTYRX2_227_N: J5.125, U1.B1 (MGTYRXN2_227_N)
/FPGA/GTY/MGTYRX2_227_P: J5.123, U1.B2 (MGTYRXP2_227_P)
/FPGA/GTY/MGTYRX3_224_N: J5.23, U1.AB1 (MGTYRXN3_224_N)
/FPGA/GTY/MGTYRX3_224_P: J5.21, U1.AB2 (MGTYRXP3_224_P)
/FPGA/GTY/MGTYRX3_225_N: J5.57, U1.P1 (MGTYRXN3_225_N)
/FPGA/GTY/MGTYRX3_225_P: J5.55, U1.P2 (MGTYRXP3_225_P)
/FPGA/GTY/MGTYRX3_226_N: J5.97, U1.F1 (MGTYRXN3_226_N)
/FPGA/GTY/MGTYRX3_226_P: J5.95, U1.F2 (MGTYRXP3_226_P)
/FPGA/GTY/MGTYRX3_227_N: J5.131, U1.A3 (MGTYRXN3_227_N)
/FPGA/GTY/MGTYRX3_227_P: J5.129, U1.A4 (MGTYRXP3_227_P)
/FPGA/GTY/MGTYTX0_224_N: J5.6, U1.AF6 (MGTYTXN0_224_N)
/FPGA/GTY/MGTYTX0_224_P: J5.4, U1.AF7 (MGTYTXP0_224_P)
/FPGA/GTY/MGTYTX0_225_N: J5.40, U1.AA4 (MGTYTXN0_225_N)
/FPGA/GTY/MGTYTX0_225_P: J5.38, U1.AA5 (MGTYTXP0_225_P)
/FPGA/GTY/MGTYTX0_226_N: J5.80, U1.N4 (MGTYTXN0_226_N)
/FPGA/GTY/MGTYTX0_226_P: J5.78, U1.N5 (MGTYTXP0_226_P)
/FPGA/GTY/MGTYTX0_227_N: J5.114, U1.F6 (MGTYTXN0_227_N)
/FPGA/GTY/MGTYTX0_227_P: J5.112, U1.F7 (MGTYTXP0_227_P)
/FPGA/GTY/MGTYTX1_224_N: J5.12, U1.AE8 (MGTYTXN1_224_N)
/FPGA/GTY/MGTYTX1_224_P: J5.10, U1.AE9 (MGTYTXP1_224_P)
/FPGA/GTY/MGTYTX1_225_N: J5.46, U1.W4 (MGTYTXN1_225_N)
/FPGA/GTY/MGTYTX1_225_P: J5.44, U1.W5 (MGTYTXP1_225_P)
/FPGA/GTY/MGTYTX1_226_N: J5.86, U1.L4 (MGTYTXN1_226_N)
/FPGA/GTY/MGTYTX1_226_P: J5.84, U1.L5 (MGTYTXP1_226_P)
/FPGA/GTY/MGTYTX1_227_N: J5.120, U1.E4 (MGTYTXN1_227_N)
/FPGA/GTY/MGTYTX1_227_P: J5.118, U1.E5 (MGTYTXP1_227_P)
/FPGA/GTY/MGTYTX2_224_N: J5.18, U1.AD6 (MGTYTXN2_224_N)
/FPGA/GTY/MGTYTX2_224_P: J5.16, U1.AD7 (MGTYTXP2_224_P)
/FPGA/GTY/MGTYTX2_225_N: J5.52, U1.U4 (MGTYTXN2_225_N)
/FPGA/GTY/MGTYTX2_225_P: J5.50, U1.U5 (MGTYTXP2_225_P)
/FPGA/GTY/MGTYTX2_226_N: J5.92, U1.J4 (MGTYTXN2_226_N)
/FPGA/GTY/MGTYTX2_226_P: J5.90, U1.J5 (MGTYTXP2_226_P)
/FPGA/GTY/MGTYTX2_227_N: J5.126, U1.D6 (MGTYTXN2_227_N)
/FPGA/GTY/MGTYTX2_227_P: J5.124, U1.D7 (MGTYTXP2_227_P)
/FPGA/GTY/MGTYTX3_224_N: J5.24, U1.AC4 (MGTYTXN3_224_N)
/FPGA/GTY/MGTYTX3_224_P: J5.22, U1.AC5 (MGTYTXP3_224_P)
/FPGA/GTY/MGTYTX3_225_N: J5.58, U1.R4 (MGTYTXN3_225_N)
/FPGA/GTY/MGTYTX3_225_P: J5.56, U1.R5 (MGTYTXP3_225_P)
/FPGA/GTY/MGTYTX3_226_N: J5.98, U1.G4 (MGTYTXN3_226_N)
/FPGA/GTY/MGTYTX3_226_P: J5.96, U1.G5 (MGTYTXP3_226_P)
/FPGA/GTY/MGTYTX3_227_N: J5.132, U1.B6 (MGTYTXN3_227_N)
/FPGA/GTY/MGTYTX3_227_P: J5.130, U1.B7 (MGTYTXP3_227_P)
GND: C260.2, C261.2, J5.1, J5.2, J5.7, J5.8, J5.13, J5.14, J5.19, J5.20, J5.25, J5.26, J5.31, J5.32, J5.35, J5.36, J5.41, J5.42, J5.47, J5.48, J5.53, J5.54, J5.59, J5.60, J5.61, J5.63, J5.65, J5.66, J5.69, J5.70, J5.75, J5.76, J5.81, J5.82, J5.87, J5.88, J5.93, J5.94, J5.99, J5.100, J5.103, J5.104, J5.109, J5.110, J5.115, J5.116, J5.121, J5.122, J5.127, J5.128, J5.133, J5.134, J5.139, J5.140, Y2.3 (GND); also elsewhere on the board
GTY_0_N: J5.34; also elsewhere on the board
GTY_0_P: J5.33; also elsewhere on the board
GTY_1_N: J5.68; also elsewhere on the board
GTY_1_P: J5.67; also elsewhere on the board
GTY_2_N: J5.102; also elsewhere on the board
GTY_2_P: J5.101; also elsewhere on the board
GTY_3_N: J5.136; also elsewhere on the board
GTY_3_P: J5.135; also elsewhere on the board
GTY_AUX_a: J5.137; also elsewhere on the board
GTY_AUX_b: J5.138; also elsewhere on the board
