dfdtc/KU5P_Core/KU5P_Core.kicad_pcb

## KiCad design KU5P_Core.kicad_pcb (continued)

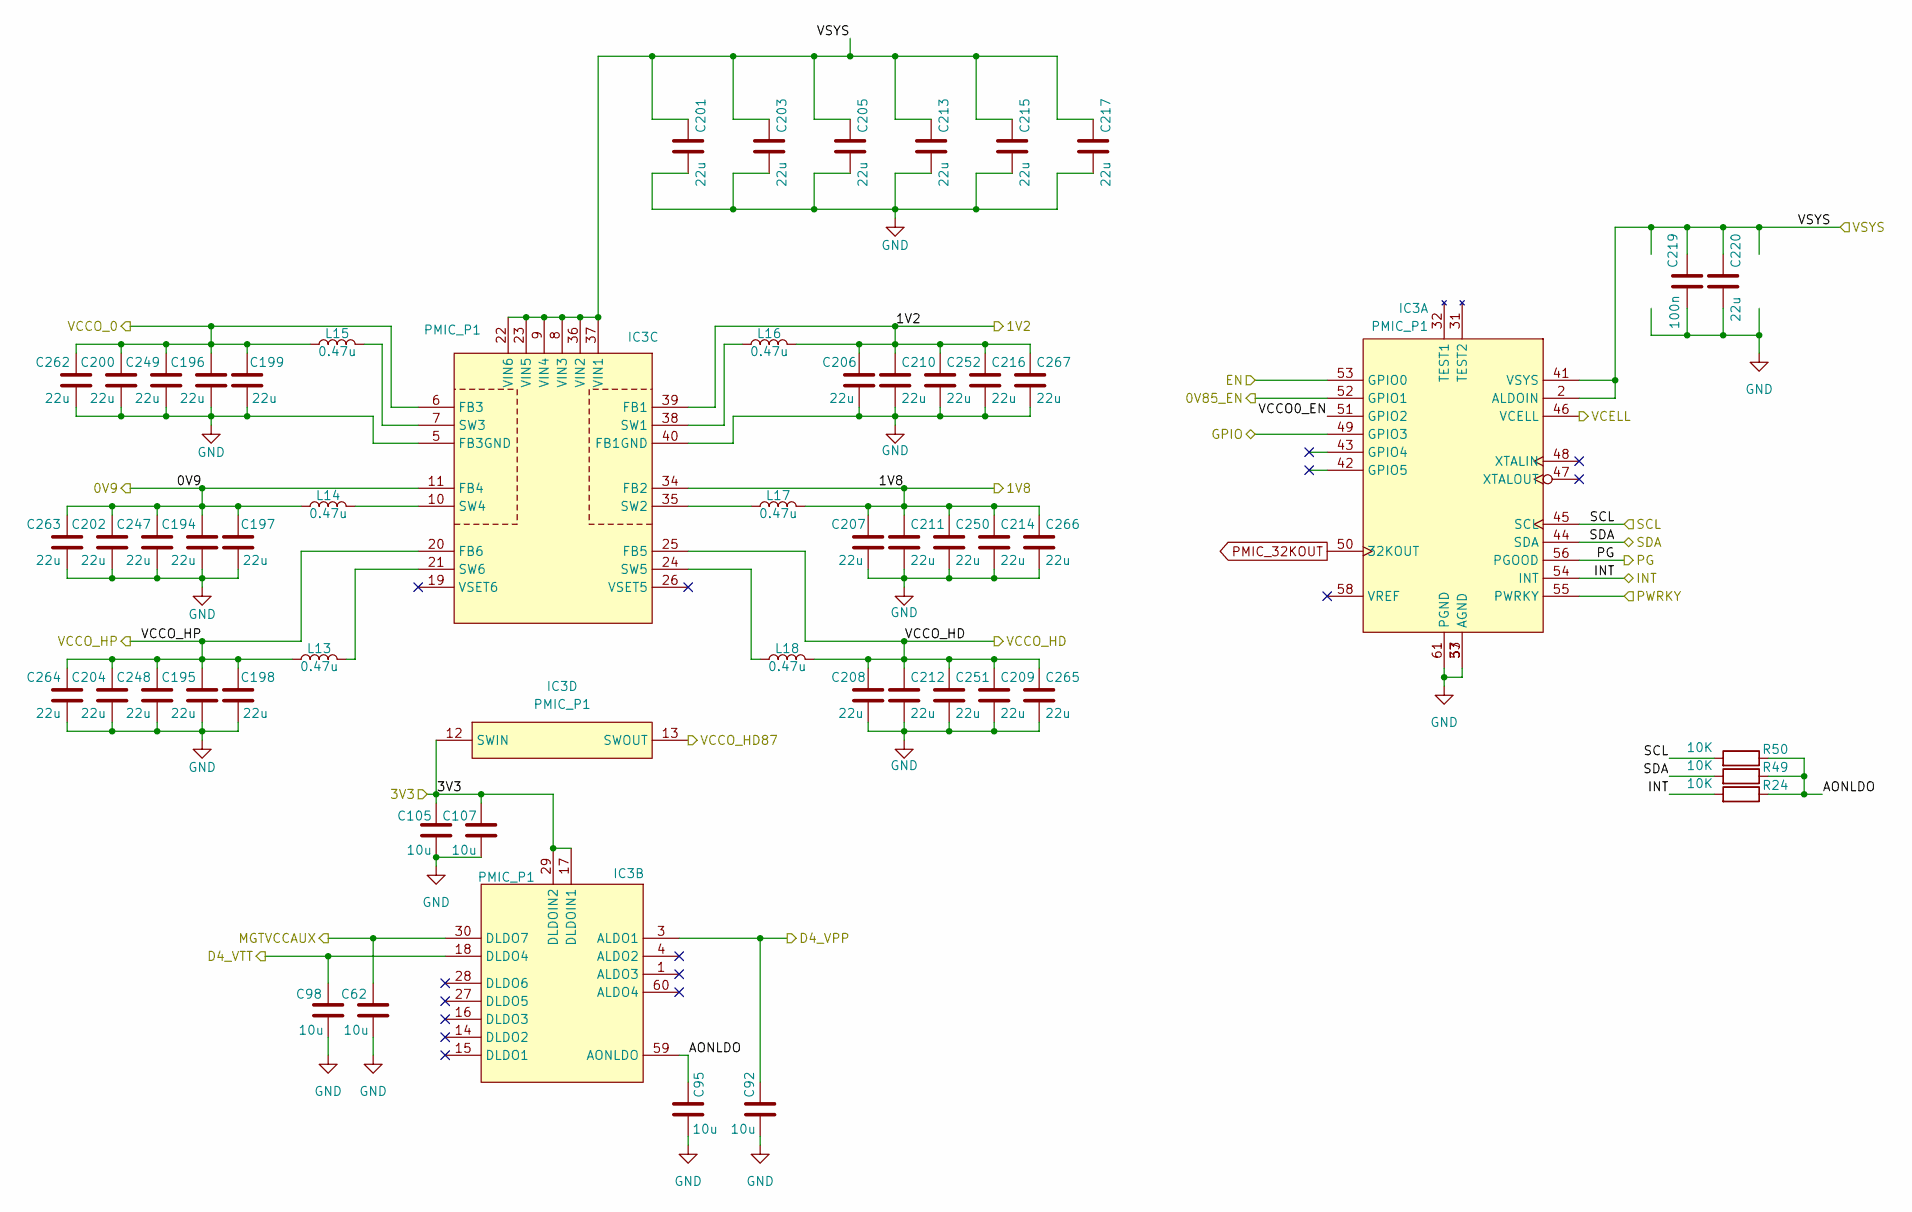
[picture p7: schematic P1.kicad_sch]

Parts:
C62, C92, C95, C98, C105, C107: 10u; C_0402_1005Metric
C194, C195, C196, C197, C198, C199, C200, C202, C204, C206, C207, C208, C209, C210, C211, C212, C214, C216, C247, C248, C249, C250, C251, C252, C262, C263, C264, C265, C266, C267: 22u; C_0402_1005Metric
C201, C203, C205, C213, C215, C217, C220: 22u; C_0603_1608Metric
C219: 100n; C_0402_1005Metric
IC3: PMIC_P1; QFN-60-1EP_7x7mm_P0.4mm_EP5.4x5.4mm
L13, L14, L15, L16, L17, L18: 0.47u; L_Changjiang_FTC252012S
R24, R49, R50: 10K; R_0201_0603Metric

Connections:
3V3: C105.1, C107.1, C201.1, C203.1, C205.1, C213.1, C215.1, C217.1, C219.1, C220.1, IC3.2 (ALDOIN), IC3.8 (VIN3), IC3.9 (VIN4), IC3.12 (SWIN), IC3.17 (DLDOIN1), IC3.22 (VIN6), IC3.23 (VIN5), IC3.29 (DLDOIN2), IC3.36 (VIN2), IC3.37 (VIN1), IC3.41 (VSYS); also elsewhere on the board
+1V8: C207.1, C211.1, C214.1, C250.1, C266.1, IC3.34 (FB2), L17.1; also elsewhere on the board
/Power/0.85Vdigi/EN: IC3.52 (GPIO1); also elsewhere on the board
/Power/IN_Rail/PG: IC3.53 (GPIO0); also elsewhere on the board
/Power/P1/AONLDO: C95.1, IC3.59 (AONLDO), R24.1, R49.1, R50.1
/Power/P1/VCCO0_EN: IC3.51 (GPIO2)
D4_VPP: C92.1, IC3.3 (ALDO1); also elsewhere on the board
D4_VTT: C98.1, IC3.18 (DLDO4); also elsewhere on the board
GND: C62.2, C92.2, C95.2, C98.2, C105.2, C107.2, C194.2, C195.2, C196.2, C197.2, C198.2, C199.2, C200.2, C201.2, C202.2, C203.2, C204.2, C205.2, C206.2, C207.2, C208.2, C209.2, C210.2, C211.2, C212.2, C213.2, C214.2, C215.2, C216.2, C217.2, C219.2, C220.2, C247.2, C248.2, C249.2, C250.2, C251.2, C252.2, C262.2, C263.2, C264.2, C265.2, C266.2, C267.2, IC3.5 (FB3GND), IC3.33 (AGND), IC3.40 (FB1GND), IC3.57 (AGND), IC3.61 (PGND); also elsewhere on the board
MGTVCC: C194.1, C197.1, C202.1, C247.1, C263.1, IC3.11 (FB4), L14.1; also elsewhere on the board
MGTVCCAUX: C62.1, IC3.30 (DLDO7); also elsewhere on the board
unnamed: IC3.38 (SW1), L16.2
unnamed: IC3.35 (SW2), L17.2
unnamed: IC3.7 (SW3), L15.2
unnamed: IC3.10 (SW4), L14.2
unnamed: IC3.24 (SW5), L18.2
unnamed: IC3.21 (SW6), L13.2
P1_GPIO: IC3.49 (GPIO3); also elsewhere on the board
P1_INT: IC3.54 (INT), R24.2; also elsewhere on the board
PMIC_32KOUT: IC3.50 (32KOUT); also elsewhere on the board
PMIC_PWRKY: IC3.55 (PWRKY); also elsewhere on the board
Power_SCL: IC3.45 (SCL), R50.2; also elsewhere on the board
Power_SDA: IC3.44 (SDA), R49.2; also elsewhere on the board
SYS_PG: IC3.56 (PGOOD); also elsewhere on the board
VBAT: IC3.46 (VCELL); also elsewhere on the board
VCCO_0: C196.1, C199.1, C200.1, C249.1, C262.1, IC3.6 (FB3), L15.1; also elsewhere on the board
VCCO_HD: C208.1, C209.1, C212.1, C251.1, C265.1, IC3.25 (FB5), L18.1; also elsewhere on the board
VCCO_HD87: IC3.13 (SWOUT); also elsewhere on the board
VCCO_HP: C195.1, C198.1, C204.1, C248.1, C264.1, IC3.20 (FB6), L13.1; also elsewhere on the board

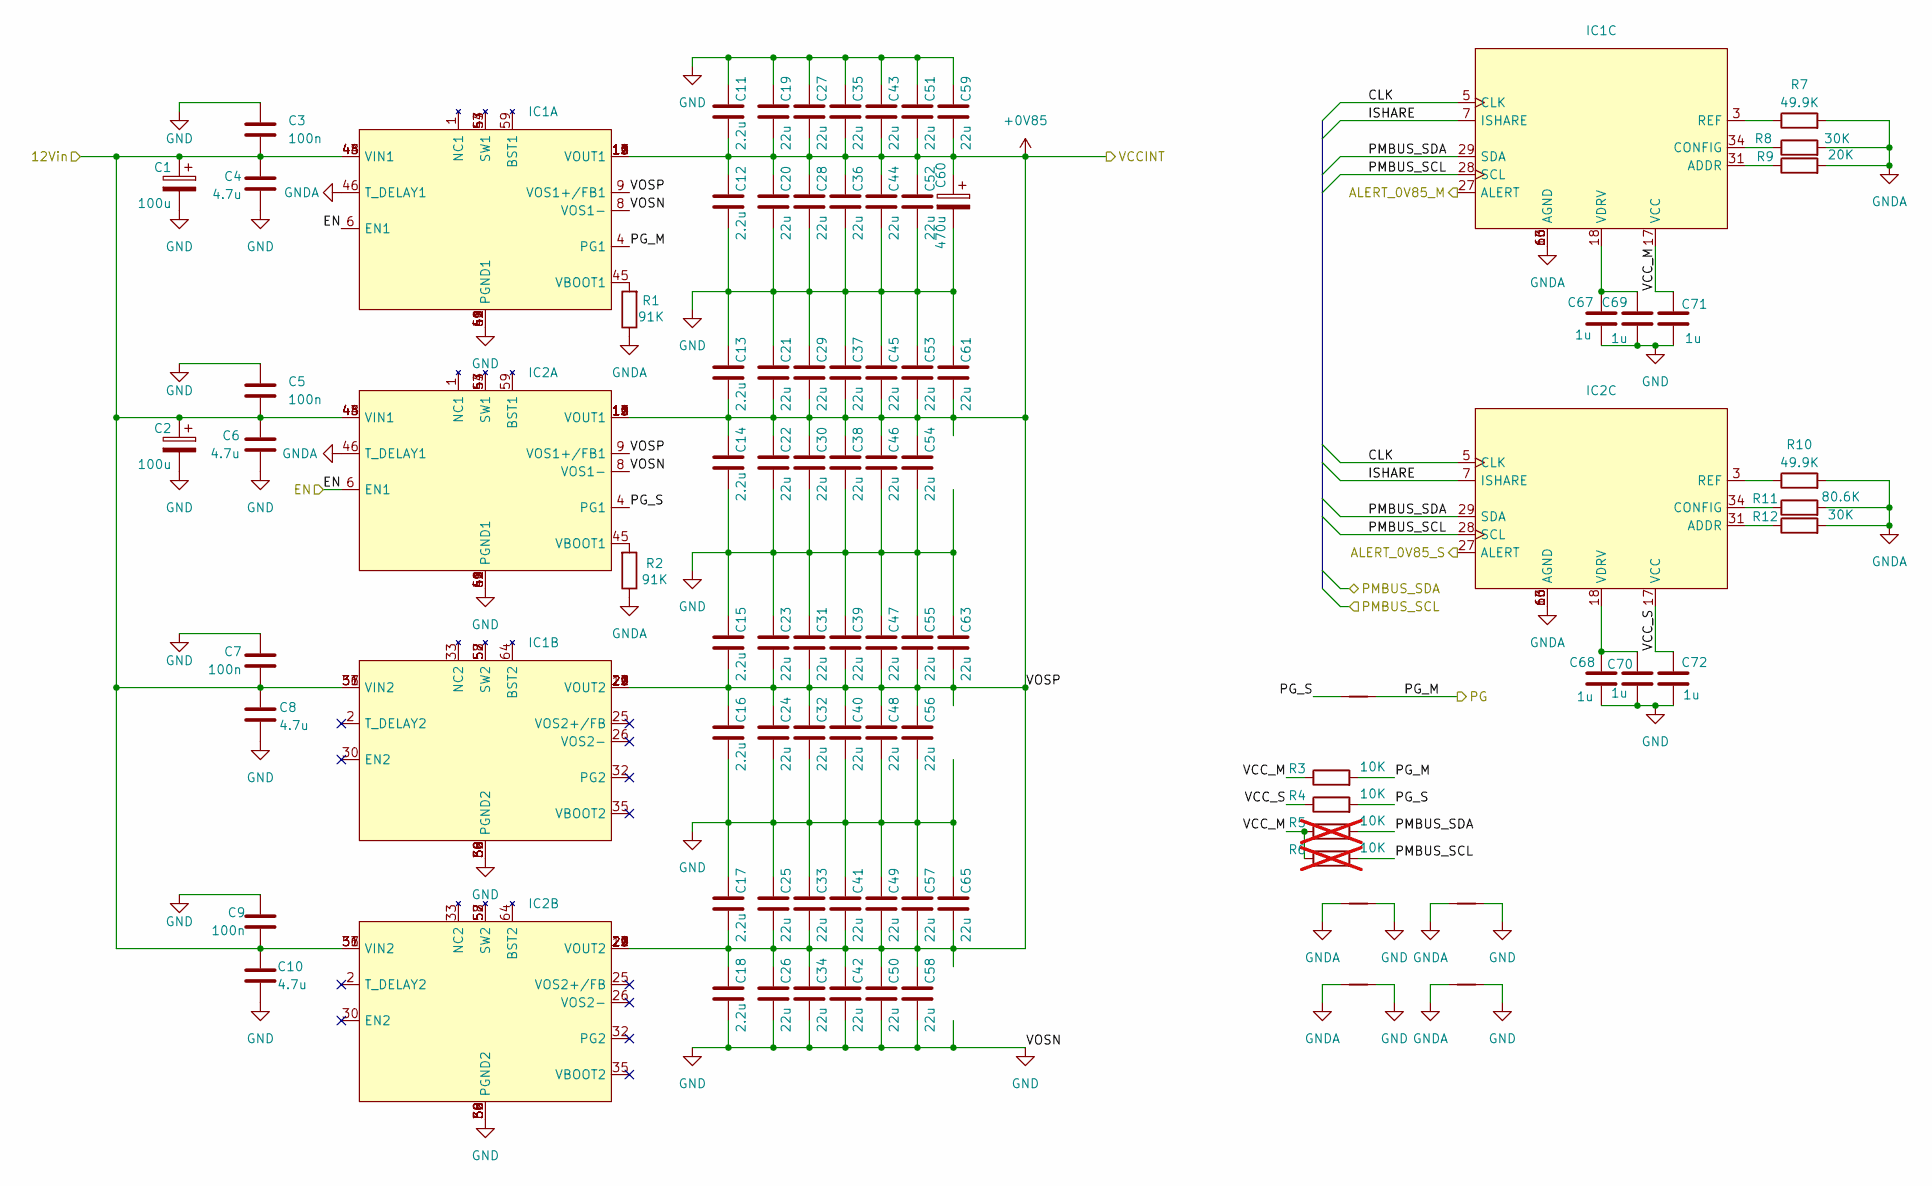
[picture p8: schematic VCCINT.kicad_sch]

Parts:
C1, C2: 100u; CP_EIA-7343-20_Kemet-V
C3, C5, C7, C9: 100n; C_0603_1608Metric
C4, C6, C8, C10: 4.7u; C_0603_1608Metric
C11, C12, C13, C14, C15, C16, C17, C18: 2.2u; C_0805_2012Metric
C19, C20, C21, C23, C27, C28, C36, C37, C45, C47, C55, C56, C58, C61: 22u; C_0603_1608Metric
C22, C24, C25, C26, C29, C30, C31, C32, C33, C34, C35, C38, C39, C40, C41, C42, C43, C44, C46, C48, C49, C50, C51, C52, C53, C54, C57, C59, C63, C65: 22u; C_0805_2012Metric
C60: 470u; CP_EIA-7343-20_Kemet-V
C67, C68, C69, C70, C71, C72: 1u; C_0402_1005Metric
IC1, IC2: NDE12D15R-S
NT1, NT2, NT12, NT13, NT14: NetTie_2; NetTie-2_SMD_Pad0.5mm
R1, R2: 91K; R_0201_0603Metric
R3, R4: 10K; R_0201_0603Metric
R5, R6: 10K; R_0201_0603Metric; not fitted
R7, R10: 49.9K; R_0201_0603Metric
R8, R12: 30K; R_0201_0603Metric
R9: 20K; R_0201_0603Metric
R11: 80.6K; R_0201_0603Metric

Connections:
+0V85: C11.2, C12.1, C13.2, C14.1, C15.2, C16.1, C17.2, C18.1, C19.2, C20.1, C21.2, C22.1, C23.2, C24.1, C25.2, C26.1, C27.2, C28.1, C29.2, C30.1, C31.2, C32.1, C33.2, C34.1, C35.2, C36.1, C37.2, C38.1, C39.2, C40.1, C41.2, C42.1, C43.2, C44.1, C45.2, C46.1, C47.2, C48.1, C49.2, C50.1, C51.2, C52.1, C53.2, C54.1, C55.2, C56.1, C57.2, C58.1, C59.2, C60.1, C61.2, C63.2, C65.2, IC1.9 (VOS1+/FB1), IC1.10 (VOUT1), IC1.11 (VOUT1), IC1.12 (VOUT1), IC1.13 (VOUT1), IC1.14 (VOUT1), IC1.15 (VOUT1), IC1.19 (VOUT2), IC1.20 (VOUT2), IC1.21 (VOUT2), IC1.22 (VOUT2), IC1.23 (VOUT2), IC1.24 (VOUT2), IC2.9 (VOS1+/FB1), IC2.10 (VOUT1), IC2.11 (VOUT1), IC2.12 (VOUT1), IC2.13 (VOUT1), IC2.14 (VOUT1), IC2.15 (VOUT1), IC2.19 (VOUT2), IC2.20 (VOUT2), IC2.21 (VOUT2), IC2.22 (VOUT2), IC2.23 (VOUT2), IC2.24 (VOUT2); also elsewhere on the board
+12V: C1.1, C2.1, C3.2, C4.1, C5.2, C6.1, C7.2, C8.1, C9.2, C10.1, IC1.36 (VIN2), IC1.37 (VIN2), IC1.43 (VIN1), IC1.44 (VIN1), IC1.48 (VIN1), IC1.51 (VIN2), IC2.36 (VIN2), IC2.37 (VIN2), IC2.43 (VIN1), IC2.44 (VIN1), IC2.48 (VIN1), IC2.51 (VIN2); also elsewhere on the board
/Power/0.85Vdigi/CLK: IC1.5 (CLK), IC2.5 (CLK)
/Power/0.85Vdigi/EN: IC1.6 (EN1), IC2.6 (EN1); also elsewhere on the board
/Power/0.85Vdigi/ISHARE: IC1.7 (ISHARE), IC2.7 (ISHARE)
/Power/0.85Vdigi/PG_S: IC2.4 (PG1), NT1.1, R4.2
/Power/0.85Vdigi/VCC_M: C71.1, IC1.17 (VCC), R3.1, R5.1, R6.1
/Power/0.85Vdigi/VCC_S: C72.1, IC2.17 (VCC), R4.1
ALERT_M: IC1.27 (ALERT); also elsewhere on the board
ALERT_S: IC2.27 (ALERT); also elsewhere on the board
GND: C1.2, C2.2, C3.1, C4.2, C5.1, C6.2, C7.1, C8.2, C9.1, C10.2, C11.1, C12.2, C13.1, C14.2, C15.1, C16.2, C17.1, C18.2, C19.1, C20.2, C21.1, C22.2, C23.1, C24.2, C25.1, C26.2, C27.1, C28.2, C29.1, C30.2, C31.1, C32.2, C33.1, C34.2, C35.1, C36.2, C37.1, C38.2, C39.1, C40.2, C41.1, C42.2, C43.1, C44.2, C45.1, C46.2, C47.1, C48.2, C49.1, C50.2, C51.1, C52.2, C53.1, C54.2, C55.1, C56.2, C57.1, C58.2, C59.1, C60.2, C61.1, C63.1, C65.1, C67.1, C68.2, C69.2, C70.2, C71.2, C72.2, IC1.8 (VOS1-), IC1.38 (PGND2), IC1.39 (PGND2), IC1.40 (PGND1), IC1.41 (PGND1), IC1.42 (PGND1), IC1.49 (PGND1), IC1.50 (PGND2), IC1.55 (PGND1), IC1.56 (PGND2), IC1.61 (PGND1), IC1.62 (PGND2), IC2.8 (VOS1-), IC2.38 (PGND2), IC2.39 (PGND2), IC2.40 (PGND1), IC2.41 (PGND1), IC2.42 (PGND1), IC2.49 (PGND1), IC2.50 (PGND2), IC2.55 (PGND1), IC2.56 (PGND2), IC2.61 (PGND1), IC2.62 (PGND2), NT2.2, NT12.2, NT13.2, NT14.2; also elsewhere on the board
GNDA: IC1.16 (AGND), IC1.46 (T_DELAY1), IC1.60 (AGND), IC1.63 (AGND), IC2.16 (AGND), IC2.46 (T_DELAY1), IC2.60 (AGND), IC2.63 (AGND), NT2.1, NT12.1, NT13.1, NT14.1, R1.1, R2.1, R7.2, R8.2, R9.2, R10.2, R11.2, R12.2
unnamed: IC1.31 (ADDR), R9.1
unnamed: IC1.34 (CONFIG), R8.1
unnamed: IC1.3 (REF), R7.1
unnamed: C67.2, C69.1, IC1.18 (VDRV)
unnamed: IC1.45 (VBOOT1), R1.2
unnamed: IC2.31 (ADDR), R12.1
unnamed: IC2.34 (CONFIG), R11.1
unnamed: IC2.3 (REF), R10.1
unnamed: C68.1, C70.1, IC2.18 (VDRV)
unnamed: IC2.45 (VBOOT1), R2.2
Power_SCL: IC1.28 (SCL), IC2.28 (SCL), R6.2; also elsewhere on the board
Power_SDA: IC1.29 (SDA), IC2.29 (SDA), R5.2; also elsewhere on the board
SYS_PG: IC1.4 (PG1), NT1.2, R3.2; also elsewhere on the board

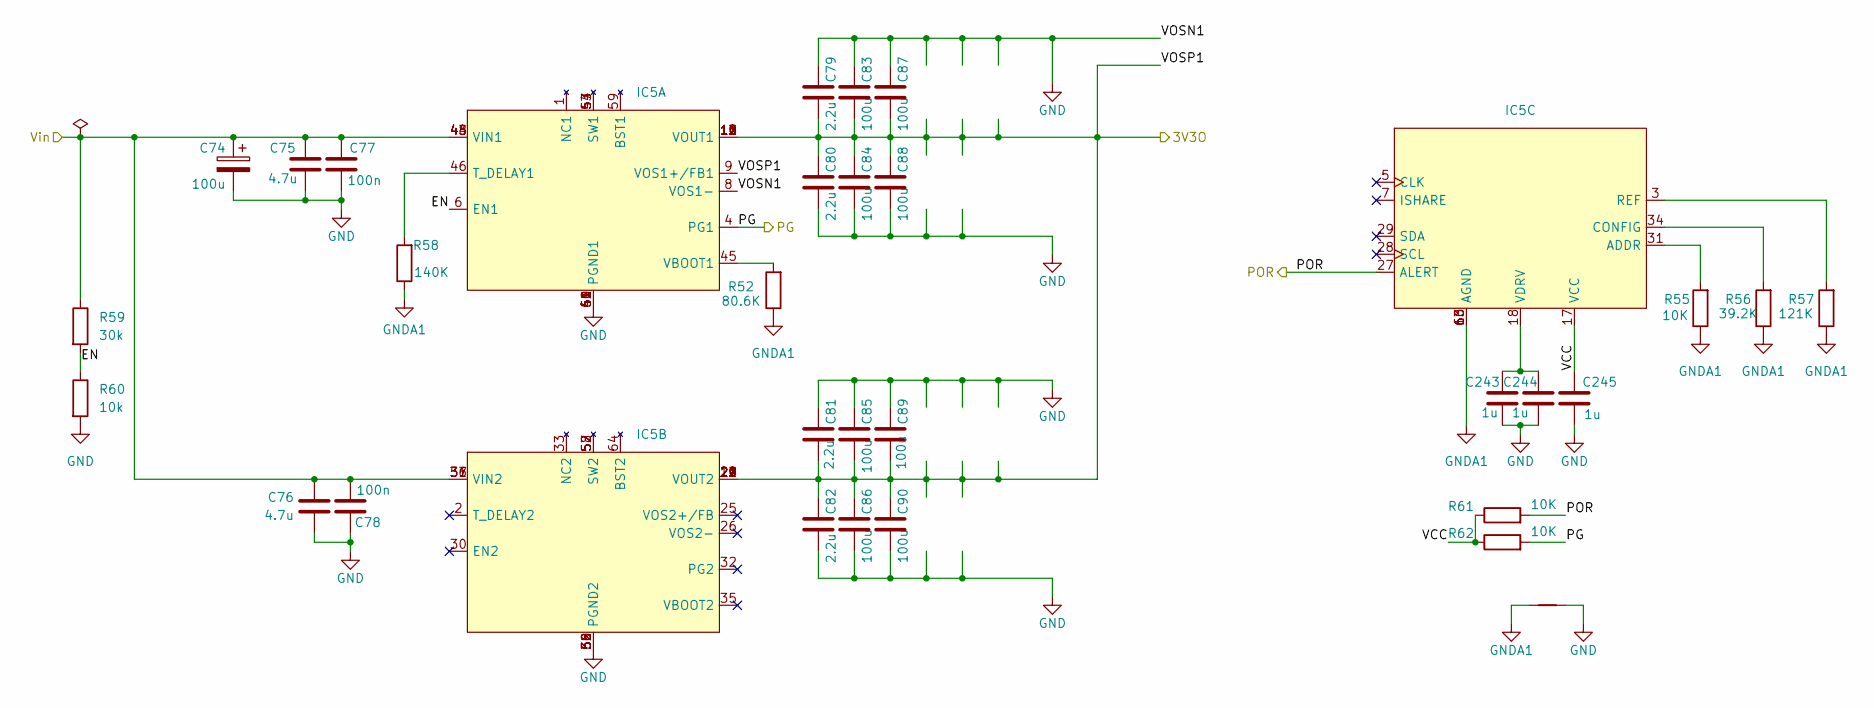
[picture p9: schematic 5V_Rail.kicad_sch]

Parts:
C74: 100u; CP_EIA-7343-20_Kemet-V
C75, C76: 4.7u; C_0603_1608Metric
C77, C78: 100n; C_0603_1608Metric
C79, C80, C81, C82: 2.2u; C_0805_2012Metric
C83, C84, C85, C86, C87, C88, C89, C90: 100u; C_1206_3216Metric
C243, C244, C245: 1u; C_0402_1005Metric
IC5: NDE12D15R-S
NT21: NetTie_2; NetTie-2_SMD_Pad0.5mm
R52: 80.6K; R_0201_0603Metric
R55, R61, R62: 10K; R_0201_0603Metric
R56: 39.2K; R_0201_0603Metric
R57: 121K; R_0201_0603Metric
R58: 140K; R_0201_0603Metric
R59: 30k; R_0201_0603Metric
R60: 10k; R_0201_0603Metric

Connections:
3V3: C79.2, C80.1, C81.2, C82.1, C83.2, C84.1, C85.2, C86.1, C87.2, C88.1, C89.2, C90.1, IC5.9 (VOS1+/FB1), IC5.10 (VOUT1), IC5.11 (VOUT1), IC5.12 (VOUT1), IC5.13 (VOUT1), IC5.14 (VOUT1), IC5.15 (VOUT1), IC5.19 (VOUT2), IC5.20 (VOUT2), IC5.21 (VOUT2), IC5.22 (VOUT2), IC5.23 (VOUT2), IC5.24 (VOUT2); also elsewhere on the board
+12V: C74.1, C75.1, C76.1, C77.1, C78.2, IC5.36 (VIN2), IC5.37 (VIN2), IC5.43 (VIN1), IC5.44 (VIN1), IC5.48 (VIN1), IC5.51 (VIN2), R59.1; also elsewhere on the board
/Power/IN_Rail/EN: IC5.6 (EN1), R59.2, R60.1
/Power/IN_Rail/PG: IC5.4 (PG1), R62.2; also elsewhere on the board
/Power/IN_Rail/POR: IC5.27 (ALERT), R61.2
/Power/IN_Rail/VCC: C245.1, IC5.17 (VCC), R61.1, R62.1
GND: C74.2, C75.2, C76.2, C77.2, C78.1, C79.1, C80.2, C81.1, C82.2, C83.1, C84.2, C85.1, C86.2, C87.1, C88.2, C89.1, C90.2, C243.2, C244.2, C245.2, IC5.8 (VOS1-), IC5.38 (PGND2), IC5.39 (PGND2), IC5.40 (PGND1), IC5.41 (PGND1), IC5.42 (PGND1), IC5.49 (PGND1), IC5.50 (PGND2), IC5.55 (PGND1), IC5.56 (PGND2), IC5.61 (PGND1), IC5.62 (PGND2), NT21.2, R60.2; also elsewhere on the board
GNDA1: IC5.16 (AGND), IC5.60 (AGND), IC5.63 (AGND), NT21.1, R52.1, R55.1, R56.1, R57.1, R58.1
unnamed: IC5.31 (ADDR), R55.2
unnamed: IC5.34 (CONFIG), R56.2
unnamed: IC5.3 (REF), R57.2
unnamed: C243.1, C244.1, IC5.18 (VDRV)
unnamed: IC5.46 (T_DELAY1), R58.2
unnamed: IC5.45 (VBOOT1), R52.2

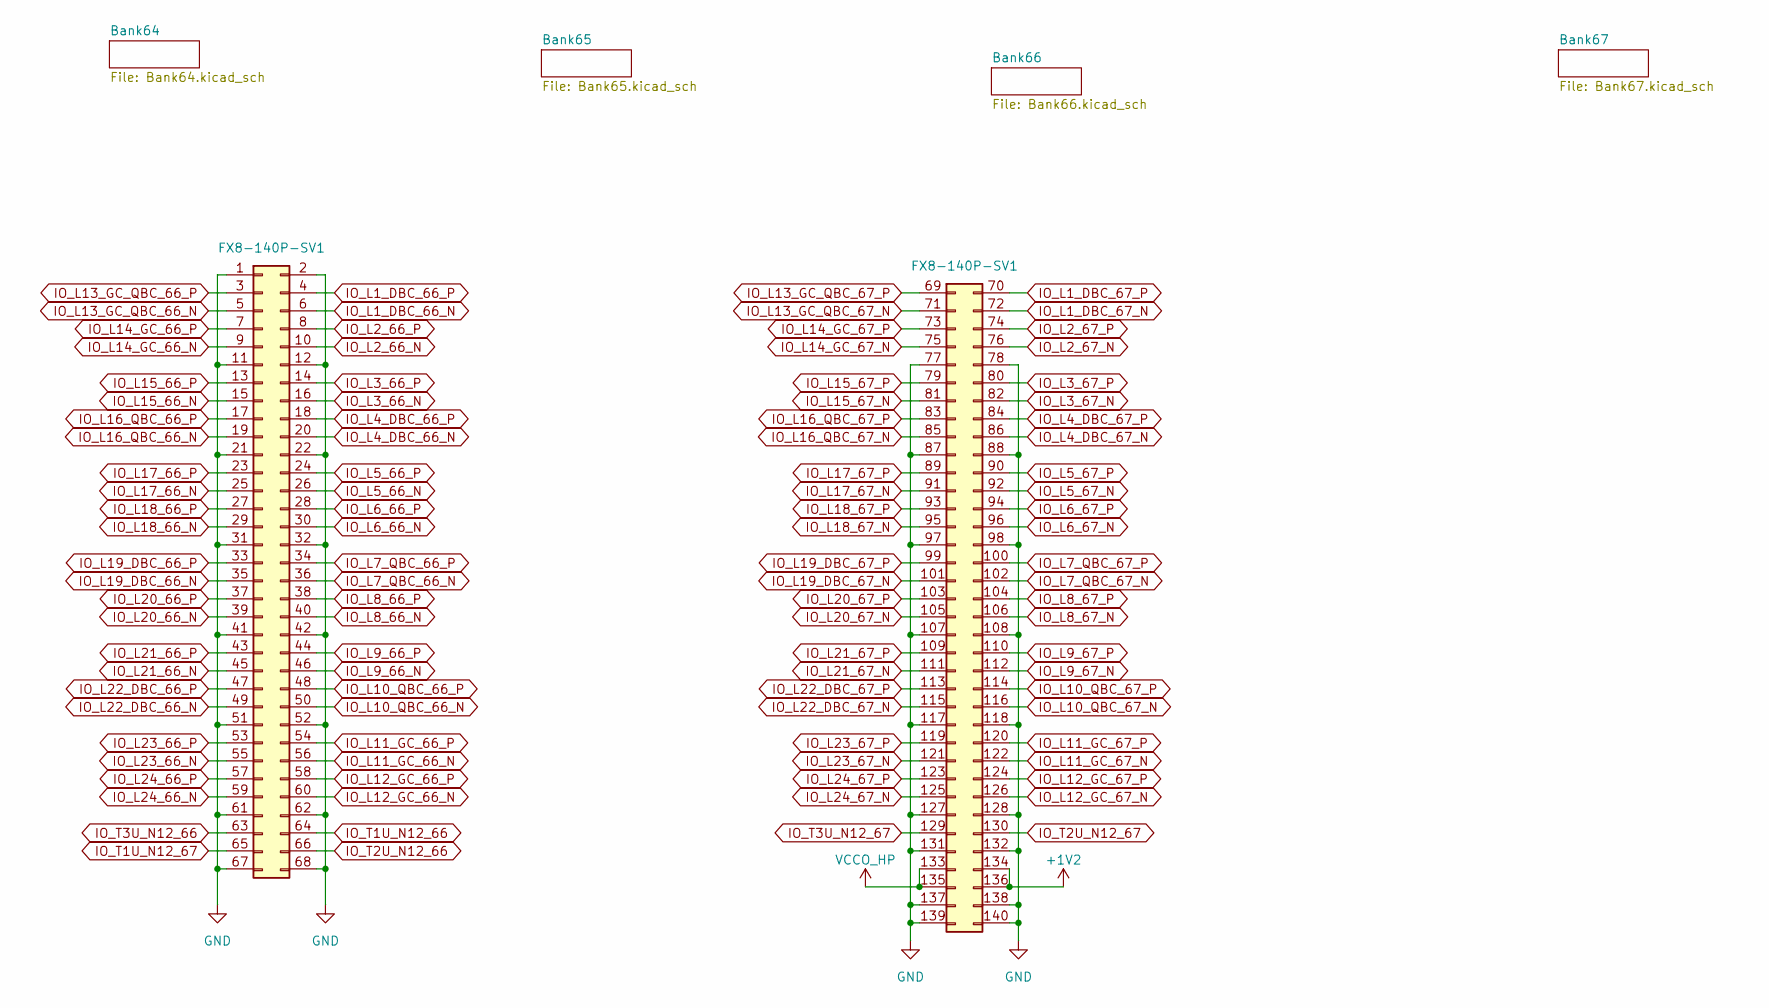
[picture p10: schematic HP_BANK.kicad_sch]

Parts:
J7: FX8-140P-SV1; Hirose_FX8-140P-SV_2x70_P0.6mm

Connections:
GND: J7.1, J7.2, J7.11, J7.12, J7.21, J7.22, J7.31, J7.32, J7.41, J7.42, J7.51, J7.52, J7.61, J7.62, J7.67, J7.68, J7.77, J7.78, J7.87, J7.88, J7.97, J7.98, J7.107, J7.108, J7.117, J7.118, J7.127, J7.128, J7.131, J7.132, J7.137, J7.138, J7.139, J7.140; also elsewhere on the board
IO_L1N_T0L_N1_DBC_66_N: J7.6; also elsewhere on the board
IO_L1N_T0L_N1_DBC_67_N: J7.72; also elsewhere on the board
IO_L1P_T0L_N0_DBC_66_P: J7.4; also elsewhere on the board
IO_L1P_T0L_N0_DBC_67_P: J7.70; also elsewhere on the board
IO_L2N_T0L_N3_66_N: J7.10; also elsewhere on the board
IO_L2N_T0L_N3_67_N: J7.76; also elsewhere on the board
IO_L2P_T0L_N2_66_P: J7.8; also elsewhere on the board
IO_L2P_T0L_N2_67_P: J7.74; also elsewhere on the board
IO_L3N_T0L_N5_AD15N_66_N: J7.16; also elsewhere on the board
IO_L3N_T0L_N5_AD15N_67_N: J7.82; also elsewhere on the board
IO_L3P_T0L_N4_AD15P_66_P: J7.14; also elsewhere on the board
IO_L3P_T0L_N4_AD15P_67_P: J7.80; also elsewhere on the board
IO_L4N_T0U_N7_DBC_AD7N_66_N: J7.20; also elsewhere on the board
IO_L4N_T0U_N7_DBC_AD7N_67_N: J7.86; also elsewhere on the board
IO_L4P_T0U_N6_DBC_AD7P_66_P: J7.18; also elsewhere on the board
IO_L4P_T0U_N6_DBC_AD7P_67_P: J7.84; also elsewhere on the board
IO_L5N_T0U_N9_AD14N_66_N: J7.26; also elsewhere on the board
IO_L5N_T0U_N9_AD14N_67_N: J7.92; also elsewhere on the board
IO_L5P_T0U_N8_AD14P_66_P: J7.24; also elsewhere on the board
IO_L5P_T0U_N8_AD14P_67_P: J7.90; also elsewhere on the board
IO_L6N_T0U_N11_AD6N_66_N: J7.30; also elsewhere on the board
IO_L6N_T0U_N11_AD6N_67_N: J7.96; also elsewhere on the board
IO_L6P_T0U_N10_AD6P_66_P: J7.28; also elsewhere on the board
IO_L6P_T0U_N10_AD6P_67_P: J7.94; also elsewhere on the board
IO_L7N_T1L_N1_QBC_AD13N_66_N: J7.36; also elsewhere on the board
IO_L7N_T1L_N1_QBC_AD13N_67_N: J7.102; also elsewhere on the board
IO_L7P_T1L_N0_QBC_AD13P_66_P: J7.34; also elsewhere on the board
IO_L7P_T1L_N0_QBC_AD13P_67_P: J7.100; also elsewhere on the board
IO_L8N_T1L_N3_AD5N_66_N: J7.40; also elsewhere on the board
IO_L8N_T1L_N3_AD5N_67_N: J7.106; also elsewhere on the board
IO_L8P_T1L_N2_AD5P_66_P: J7.38; also elsewhere on the board
IO_L8P_T1L_N2_AD5P_67_P: J7.104; also elsewhere on the board
IO_L9N_T1L_N5_AD12N_66_N: J7.46; also elsewhere on the board
IO_L9N_T1L_N5_AD12N_67_N: J7.112; also elsewhere on the board
IO_L9P_T1L_N4_AD12P_66_P: J7.44; also elsewhere on the board
IO_L9P_T1L_N4_AD12P_67_P: J7.110; also elsewhere on the board
IO_L10N_T1U_N7_QBC_AD4N_66_N: J7.50; also elsewhere on the board
IO_L10N_T1U_N7_QBC_AD4N_67_N: J7.116; also elsewhere on the board
IO_L10P_T1U_N6_QBC_AD4P_66_P: J7.48; also elsewhere on the board
IO_L10P_T1U_N6_QBC_AD4P_67_P: J7.114; also elsewhere on the board
IO_L11N_T1U_N9_GC_66_N: J7.56; also elsewhere on the board
IO_L11N_T1U_N9_GC_67_N: J7.122; also elsewhere on the board
IO_L11P_T1U_N8_GC_66_P: J7.54; also elsewhere on the board
IO_L11P_T1U_N8_GC_67_P: J7.120; also elsewhere on the board
IO_L12N_T1U_N11_GC_66_N: J7.60; also elsewhere on the board
IO_L12N_T1U_N11_GC_67_N: J7.126; also elsewhere on the board
IO_L12P_T1U_N10_GC_66_P: J7.58; also elsewhere on the board
IO_L12P_T1U_N10_GC_67_P: J7.124; also elsewhere on the board
IO_L13N_T2L_N1_GC_QBC_66_N: J7.5; also elsewhere on the board
IO_L13N_T2L_N1_GC_QBC_67_N: J7.71; also elsewhere on the board
IO_L13P_T2L_N0_GC_QBC_66_P: J7.3; also elsewhere on the board
IO_L13P_T2L_N0_GC_QBC_67_P: J7.69; also elsewhere on the board
IO_L14N_T2L_N3_GC_66_N: J7.9; also elsewhere on the board
IO_L14N_T2L_N3_GC_67_N: J7.75; also elsewhere on the board
IO_L14P_T2L_N2_GC_66_P: J7.7; also elsewhere on the board
IO_L14P_T2L_N2_GC_67_P: J7.73; also elsewhere on the board
IO_L15N_T2L_N5_AD11N_66_N: J7.15; also elsewhere on the board
IO_L15N_T2L_N5_AD11N_67_N: J7.81; also elsewhere on the board
IO_L15P_T2L_N4_AD11P_66_P: J7.13; also elsewhere on the board
IO_L15P_T2L_N4_AD11P_67_P: J7.79; also elsewhere on the board
IO_L16N_T2U_N7_QBC_AD3N_66_N: J7.19; also elsewhere on the board
IO_L16N_T2U_N7_QBC_AD3N_67_N: J7.85; also elsewhere on the board
IO_L16P_T2U_N6_QBC_AD3P_66_P: J7.17; also elsewhere on the board
IO_L16P_T2U_N6_QBC_AD3P_67_P: J7.83; also elsewhere on the board
IO_L17N_T2U_N9_AD10N_66_N: J7.25; also elsewhere on the board
IO_L17N_T2U_N9_AD10N_67_N: J7.91; also elsewhere on the board
IO_L17P_T2U_N8_AD10P_66_P: J7.23; also elsewhere on the board
IO_L17P_T2U_N8_AD10P_67_P: J7.89; also elsewhere on the board
IO_L18N_T2U_N11_AD2N_66_N: J7.29; also elsewhere on the board
IO_L18N_T2U_N11_AD2N_67_N: J7.95; also elsewhere on the board
IO_L18P_T2U_N10_AD2P_66_P: J7.27; also elsewhere on the board
IO_L18P_T2U_N10_AD2P_67_P: J7.93; also elsewhere on the board
IO_L19N_T3L_N1_DBC_AD9N_66_N: J7.35; also elsewhere on the board
IO_L19N_T3L_N1_DBC_AD9N_67_N: J7.101; also elsewhere on the board
IO_L19P_T3L_N0_DBC_AD9P_66_P: J7.33; also elsewhere on the board
IO_L19P_T3L_N0_DBC_AD9P_67_P: J7.99; also elsewhere on the board
IO_L20N_T3L_N3_AD1N_66_N: J7.39; also elsewhere on the board
IO_L20N_T3L_N3_AD1N_67_N: J7.105; also elsewhere on the board
IO_L20P_T3L_N2_AD1P_66_P: J7.37; also elsewhere on the board
IO_L20P_T3L_N2_AD1P_67_P: J7.103; also elsewhere on the board
IO_L21N_T3L_N5_AD8N_66_N: J7.45; also elsewhere on the board
IO_L21N_T3L_N5_AD8N_67_N: J7.111; also elsewhere on the board
IO_L21P_T3L_N4_AD8P_66_P: J7.43; also elsewhere on the board
IO_L21P_T3L_N4_AD8P_67_P: J7.109; also elsewhere on the board
IO_L22N_T3U_N7_DBC_AD0N_66_N: J7.49; also elsewhere on the board
IO_L22N_T3U_N7_DBC_AD0N_67_N: J7.115; also elsewhere on the board
IO_L22P_T3U_N6_DBC_AD0P_66_P: J7.47; also elsewhere on the board
IO_L22P_T3U_N6_DBC_AD0P_67_P: J7.113; also elsewhere on the board
IO_L23N_T3U_N9_66_N: J7.55; also elsewhere on the board
IO_L23N_T3U_N9_67_N: J7.121; also elsewhere on the board
IO_L23P_T3U_N8_66_P: J7.53; also elsewhere on the board
IO_L23P_T3U_N8_67_P: J7.119; also elsewhere on the board
IO_L24N_T3U_N11_66_N: J7.59; also elsewhere on the board
IO_L24N_T3U_N11_67_N: J7.125; also elsewhere on the board
IO_L24P_T3U_N10_66_P: J7.57; also elsewhere on the board
IO_L24P_T3U_N10_67_P: J7.123; also elsewhere on the board
IO_T1U_N12_66: J7.64; also elsewhere on the board
IO_T1U_N12_67: J7.65; also elsewhere on the board
IO_T2U_N12_66: J7.66; also elsewhere on the board
IO_T2U_N12_67: J7.130; also elsewhere on the board
IO_T3U_N12_66: J7.63; also elsewhere on the board
IO_T3U_N12_67: J7.129; also elsewhere on the board
VCCO_HP: J7.133, J7.135; also elsewhere on the board

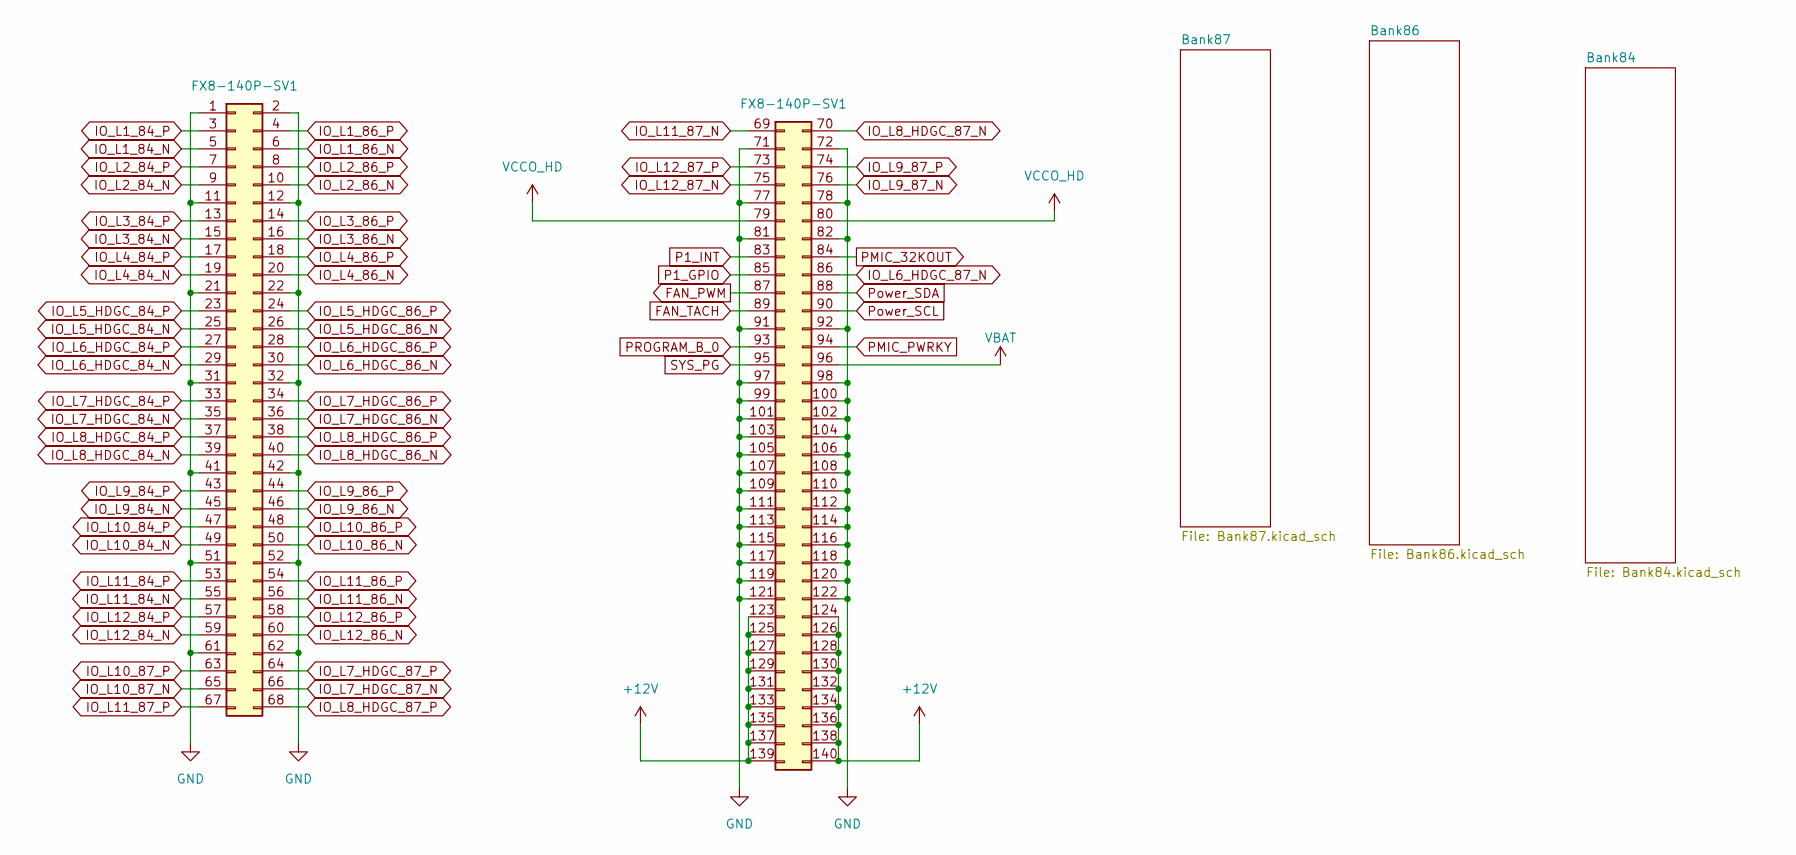
[picture p11: schematic HD_BANK.kicad_sch]

Parts:
J6: FX8-140P-SV1; Hirose_FX8-140P-SV_2x70_P0.6mm

Connections:
+12V: J6.123, J6.124, J6.125, J6.126, J6.127, J6.128, J6.129, J6.130, J6.131, J6.132, J6.133, J6.134, J6.135, J6.136, J6.137, J6.138, J6.139, J6.140; also elsewhere on the board
FAN_PWM: J6.87; also elsewhere on the board
FAN_TACH: J6.89; also elsewhere on the board
GND: J6.1, J6.2, J6.11, J6.12, J6.21, J6.22, J6.31, J6.32, J6.41, J6.42, J6.51, J6.52, J6.61, J6.62, J6.71, J6.72, J6.77, J6.78, J6.81, J6.82, J6.91, J6.92, J6.97, J6.98, J6.99, J6.100, J6.101, J6.102, J6.103, J6.104, J6.105, J6.106, J6.107, J6.108, J6.109, J6.110, J6.111, J6.112, J6.113, J6.114, J6.115, J6.116, J6.117, J6.118, J6.119, J6.120, J6.121, J6.122; also elsewhere on the board
IO_L1N_AD11N_84_N: J6.5; also elsewhere on the board
IO_L1N_AD11N_86_N: J6.6; also elsewhere on the board
IO_L1P_AD11P_84_P: J6.3; also elsewhere on the board
IO_L1P_AD11P_86_P: J6.4; also elsewhere on the board
IO_L2N_AD10N_84_N: J6.9; also elsewhere on the board
IO_L2N_AD10N_86_N: J6.10; also elsewhere on the board
IO_L2P_AD10P_84_P: J6.7; also elsewhere on the board
IO_L2P_AD10P_86_P: J6.8; also elsewhere on the board
IO_L3N_AD9N_84_N: J6.15; also elsewhere on the board
IO_L3N_AD9N_86_N: J6.16; also elsewhere on the board
IO_L3P_AD9P_84_P: J6.13; also elsewhere on the board
IO_L3P_AD9P_86_P: J6.14; also elsewhere on the board
IO_L4N_AD8N_84_N: J6.19; also elsewhere on the board
IO_L4N_AD8N_86_N: J6.20; also elsewhere on the board
IO_L4P_AD8P_84_P: J6.17; also elsewhere on the board
IO_L4P_AD8P_86_P: J6.18; also elsewhere on the board
IO_L5N_HDGC_AD7N_84_N: J6.25; also elsewhere on the board
IO_L5N_HDGC_AD7N_86_N: J6.26; also elsewhere on the board
IO_L5P_HDGC_AD7P_84_P: J6.23; also elsewhere on the board
IO_L5P_HDGC_AD7P_86_P: J6.24; also elsewhere on the board
IO_L6N_HDGC_87_N: J6.86; also elsewhere on the board
IO_L6N_HDGC_AD6N_84_N: J6.29; also elsewhere on the board
IO_L6N_HDGC_AD6N_86_N: J6.30; also elsewhere on the board
IO_L6P_HDGC_AD6P_84_P: J6.27; also elsewhere on the board
IO_L6P_HDGC_AD6P_86_P: J6.28; also elsewhere on the board
IO_L7N_HDGC_87_N: J6.66; also elsewhere on the board
IO_L7N_HDGC_AD5N_84_N: J6.35; also elsewhere on the board
IO_L7N_HDGC_AD5N_86_N: J6.36; also elsewhere on the board
IO_L7P_HDGC_87_P: J6.64; also elsewhere on the board
IO_L7P_HDGC_AD5P_84_P: J6.33; also elsewhere on the board
IO_L7P_HDGC_AD5P_86_P: J6.34; also elsewhere on the board
IO_L8N_HDGC_87_N: J6.70; also elsewhere on the board
IO_L8N_HDGC_AD4N_84_N: J6.39; also elsewhere on the board
IO_L8N_HDGC_AD4N_86_N: J6.40; also elsewhere on the board
IO_L8P_HDGC_87_P: J6.68; also elsewhere on the board
IO_L8P_HDGC_AD4P_84_P: J6.37; also elsewhere on the board
IO_L8P_HDGC_AD4P_86_P: J6.38; also elsewhere on the board
IO_L9N_AD3N_84_N: J6.45; also elsewhere on the board
IO_L9N_AD3N_86_N: J6.46; also elsewhere on the board
IO_L9N_AD11N_87_N: J6.76; also elsewhere on the board
IO_L9P_AD3P_84_P: J6.43; also elsewhere on the board
IO_L9P_AD3P_86_P: J6.44; also elsewhere on the board
IO_L9P_AD11P_87_P: J6.74; also elsewhere on the board
IO_L10N_AD2N_84_N: J6.49; also elsewhere on the board
IO_L10N_AD2N_86_N: J6.50; also elsewhere on the board
IO_L10N_AD10N_87_N: J6.65; also elsewhere on the board
IO_L10P_AD2P_84_P: J6.47; also elsewhere on the board
IO_L10P_AD2P_86_P: J6.48; also elsewhere on the board
IO_L10P_AD10P_87_P: J6.63; also elsewhere on the board
IO_L11N_AD1N_84_N: J6.55; also elsewhere on the board
IO_L11N_AD1N_86_N: J6.56; also elsewhere on the board
IO_L11N_AD9N_87_N: J6.69; also elsewhere on the board
IO_L11P_AD1P_84_P: J6.53; also elsewhere on the board
IO_L11P_AD1P_86_P: J6.54; also elsewhere on the board
IO_L11P_AD9P_87_P: J6.67; also elsewhere on the board
IO_L12N_AD0N_84_N: J6.59; also elsewhere on the board
IO_L12N_AD0N_86_N: J6.60; also elsewhere on the board
IO_L12N_AD8N_87_N: J6.75; also elsewhere on the board
IO_L12P_AD0P_84_P: J6.57; also elsewhere on the board
IO_L12P_AD0P_86_P: J6.58; also elsewhere on the board
IO_L12P_AD8P_87_P: J6.73; also elsewhere on the board
P1_GPIO: J6.85; also elsewhere on the board
P1_INT: J6.83; also elsewhere on the board
PMIC_32KOUT: J6.84; also elsewhere on the board
PMIC_PWRKY: J6.94; also elsewhere on the board
PROGRAM_B_0: J6.93; also elsewhere on the board
Power_SCL: J6.90; also elsewhere on the board
Power_SDA: J6.88; also elsewhere on the board
SYS_PG: J6.95; also elsewhere on the board
VBAT: J6.96; also elsewhere on the board
VCCO_HD: J6.79, J6.80; also elsewhere on the board

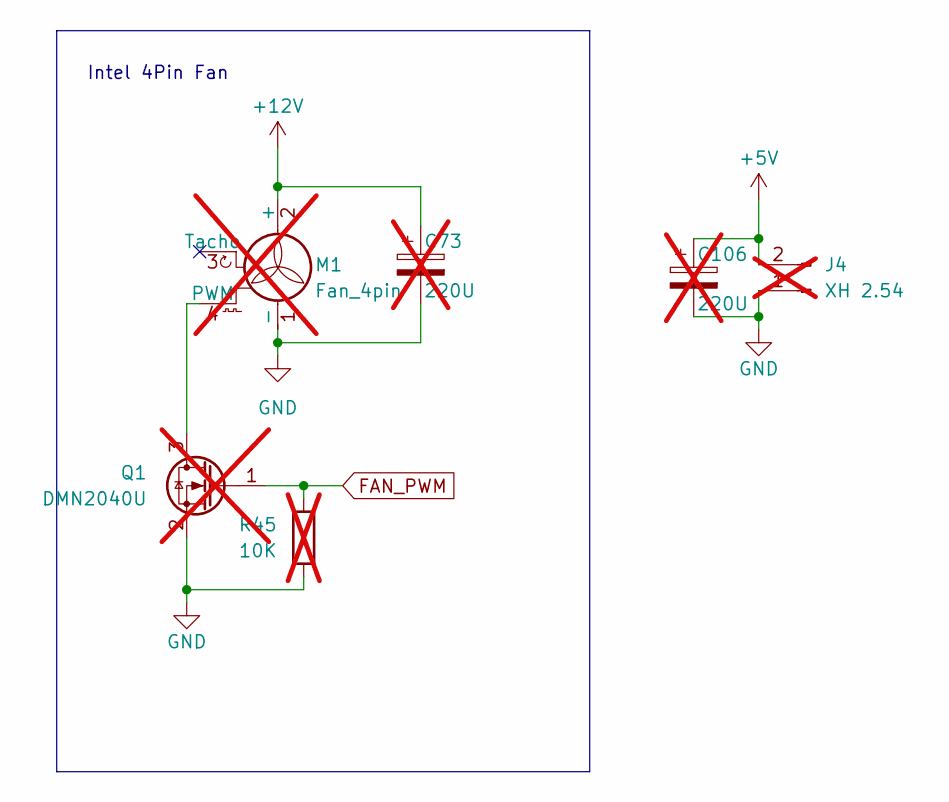
[picture p12: schematic FAN.kicad_sch]

Parts:
C73, C106: 220U; CP_EIA-7343-31_Kemet-D; not fitted
J4: XH 2.54; JST_XA_B02B-XASK-1_1x02_P2.50mm_Vertical; not fitted
M1: Fan_4pin; FanPinHeader_1x04_P2.54mm_Vertical; not fitted
Q1: DMN2040U; SOT-23; not fitted
R45: 10K; R_0201_0603Metric; not fitted

Connections:
unnamed: C73.1, M1.2 (+)
unnamed: C106.1, J4.2
unnamed: C73.2, C106.2, J4.1, M1.1 (-), Q1.2 (S), R45.2
unnamed: M1.4 (PWM), Q1.3 (D)
unnamed: Q1.1 (G), R45.1

Notes on the sheet:
Intel 4Pin Fan
