dfdtc/KU5P_Core/KU5P_Core.kicad_pcb

## KiCad design KU5P_Core.kicad_pcb (continued)

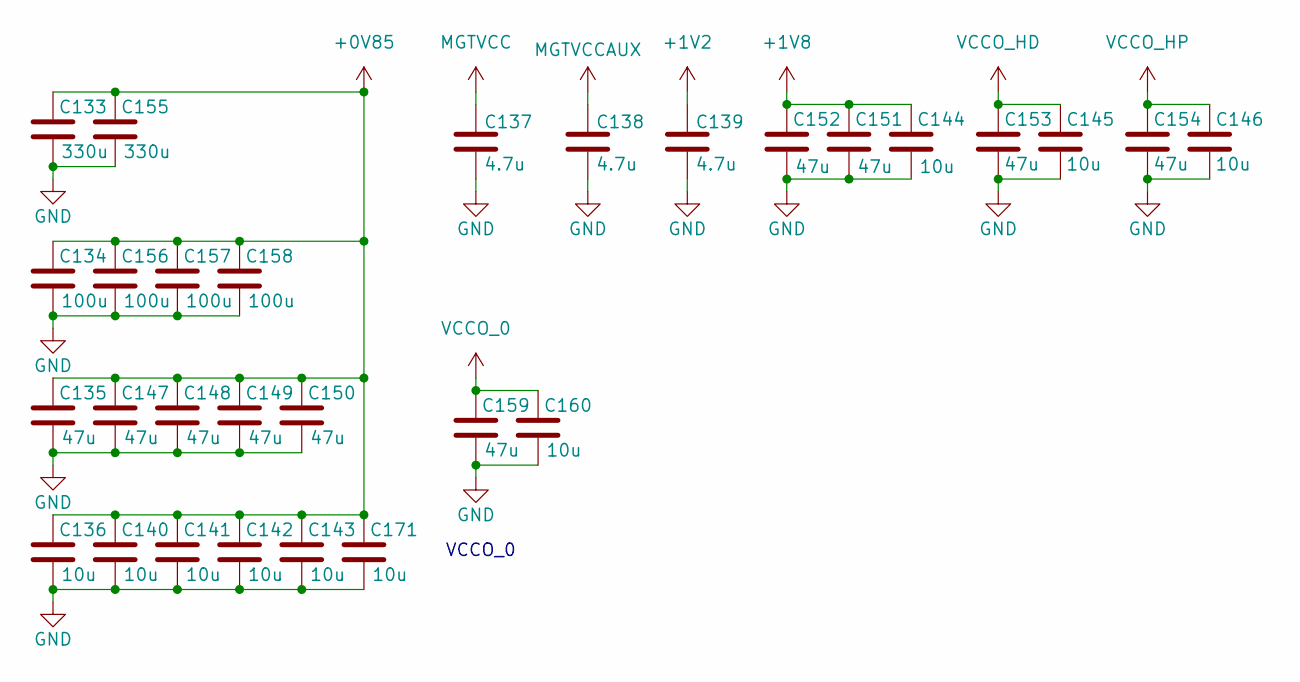
[picture p13: schematic Decap.kicad_sch]

Parts:
C133, C155: 330u; C_1210_3225Metric
C134, C156, C157, C158: 100u; C_0805_2012Metric
C135, C147, C148, C149, C150, C151, C152, C153, C154, C159: 47u; C_0603_1608Metric
C136, C140, C141, C142, C143, C144, C145, C146, C160, C171: 10u; C_0402_1005Metric
C137, C138, C139: 4.7u; C_0201_0603Metric

Connections:
+0V85: C133.1, C134.1, C135.1, C136.1, C140.1, C141.1, C142.1, C143.1, C147.1, C148.1, C149.1, C150.1, C155.1, C156.1, C157.1, C158.1, C171.1; also elsewhere on the board
+1V8: C144.1, C151.1, C152.1; also elsewhere on the board
GND: C133.2, C134.2, C135.2, C136.2, C137.2, C138.2, C139.2, C140.2, C141.2, C142.2, C143.2, C144.2, C145.2, C146.2, C147.2, C148.2, C149.2, C150.2, C151.2, C152.2, C153.2, C154.2, C155.2, C156.2, C157.2, C158.2, C159.2, C160.2, C171.2; also elsewhere on the board
MGTVCC: C137.1; also elsewhere on the board
MGTVCCAUX: C138.1; also elsewhere on the board
VCCO_0: C159.1, C160.1; also elsewhere on the board
VCCO_HD: C145.1, C153.1; also elsewhere on the board
VCCO_HP: C146.1, C154.1; also elsewhere on the board

Notes on the sheet:
VCCO_0

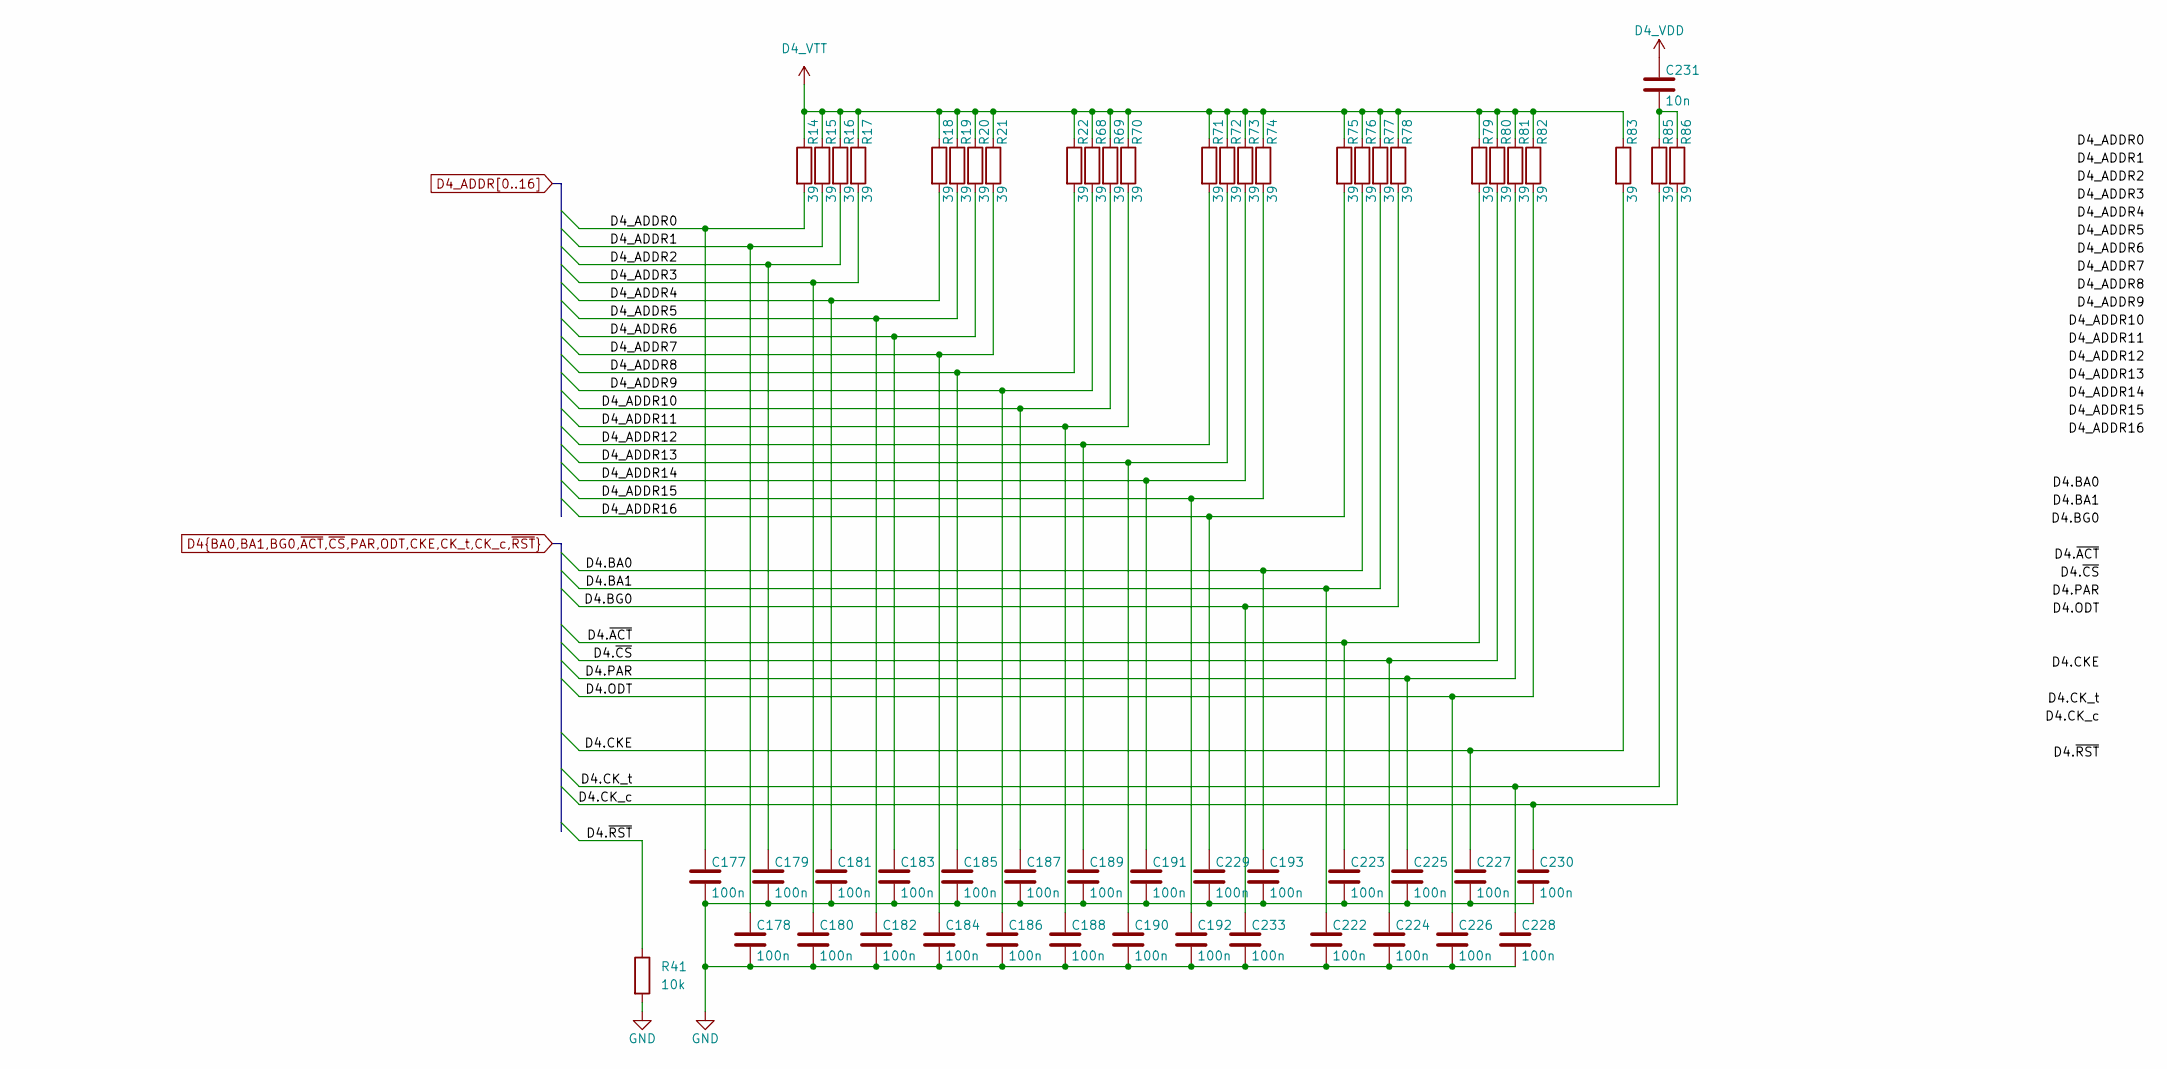
[picture p14: schematic DDR4_TERM.kicad_sch]

Parts:
C177, C178, C179, C180, C181, C182, C183, C184, C185, C186, C187, C188, C189, C190, C191, C192, C193, C222, C223, C224, C225, C226, C227, C228, C229, C230, C233: 100n; C_0201_0603Metric
C231: 10n; C_0201_0603Metric
R14, R15, R16, R17, R18, R19, R20, R21, R22, R68, R69, R70, R71, R72, R73, R74, R75, R76, R77, R78, R79, R80, R81, R82, R83, R85, R86: 39; R_0201_0603Metric
R41: 10k; R_0201_0603Metric

Connections:
D4.BA0: C193.1, R76.2; also elsewhere on the board
D4.BA1: C222.1, R77.2; also elsewhere on the board
D4.BG0: C233.1, R78.2; also elsewhere on the board
D4.CKE: C227.1, R83.2; also elsewhere on the board
D4.CK_c: C230.1, R86.2; also elsewhere on the board
D4.CK_t: C228.1, R85.2; also elsewhere on the board
D4.ODT: C226.1, R82.2; also elsewhere on the board
D4.PAR: C225.1, R81.2; also elsewhere on the board
D4.~ACT: C223.1, R79.2; also elsewhere on the board
D4.~CS: C224.1, R80.2; also elsewhere on the board
D4.~RST: R41.1; also elsewhere on the board
D4_ADDR0: C177.1, R14.2; also elsewhere on the board
D4_ADDR1: C178.1, R15.2; also elsewhere on the board
D4_ADDR2: C179.1, R16.2; also elsewhere on the board
D4_ADDR3: C180.1, R17.2; also elsewhere on the board
D4_ADDR4: C181.1, R18.2; also elsewhere on the board
D4_ADDR5: C182.1, R19.2; also elsewhere on the board
D4_ADDR6: C183.1, R20.2; also elsewhere on the board
D4_ADDR7: C184.1, R21.2; also elsewhere on the board
D4_ADDR8: C185.1, R22.2; also elsewhere on the board
D4_ADDR9: C186.1, R68.2; also elsewhere on the board
D4_ADDR10: C187.1, R69.2; also elsewhere on the board
D4_ADDR11: C188.1, R70.2; also elsewhere on the board
D4_ADDR12: C189.1, R71.2; also elsewhere on the board
D4_ADDR13: C190.1, R72.2; also elsewhere on the board
D4_ADDR14: C191.1, R73.2; also elsewhere on the board
D4_ADDR15: C192.1, R74.2; also elsewhere on the board
D4_ADDR16: C229.1, R75.2; also elsewhere on the board
D4_VTT: R14.1, R15.1, R16.1, R17.1, R18.1, R19.1, R20.1, R21.1, R22.1, R68.1, R69.1, R70.1, R71.1, R72.1, R73.1, R74.1, R75.1, R76.1, R77.1, R78.1, R79.1, R80.1, R81.1, R82.1, R83.1; also elsewhere on the board
GND: C177.2, C178.2, C179.2, C180.2, C181.2, C182.2, C183.2, C184.2, C185.2, C186.2, C187.2, C188.2, C189.2, C190.2, C191.2, C192.2, C193.2, C222.2, C223.2, C224.2, C225.2, C226.2, C227.2, C228.2, C229.2, C230.2, C233.2, R41.2; also elsewhere on the board
unnamed: C231.2, R85.1, R86.1

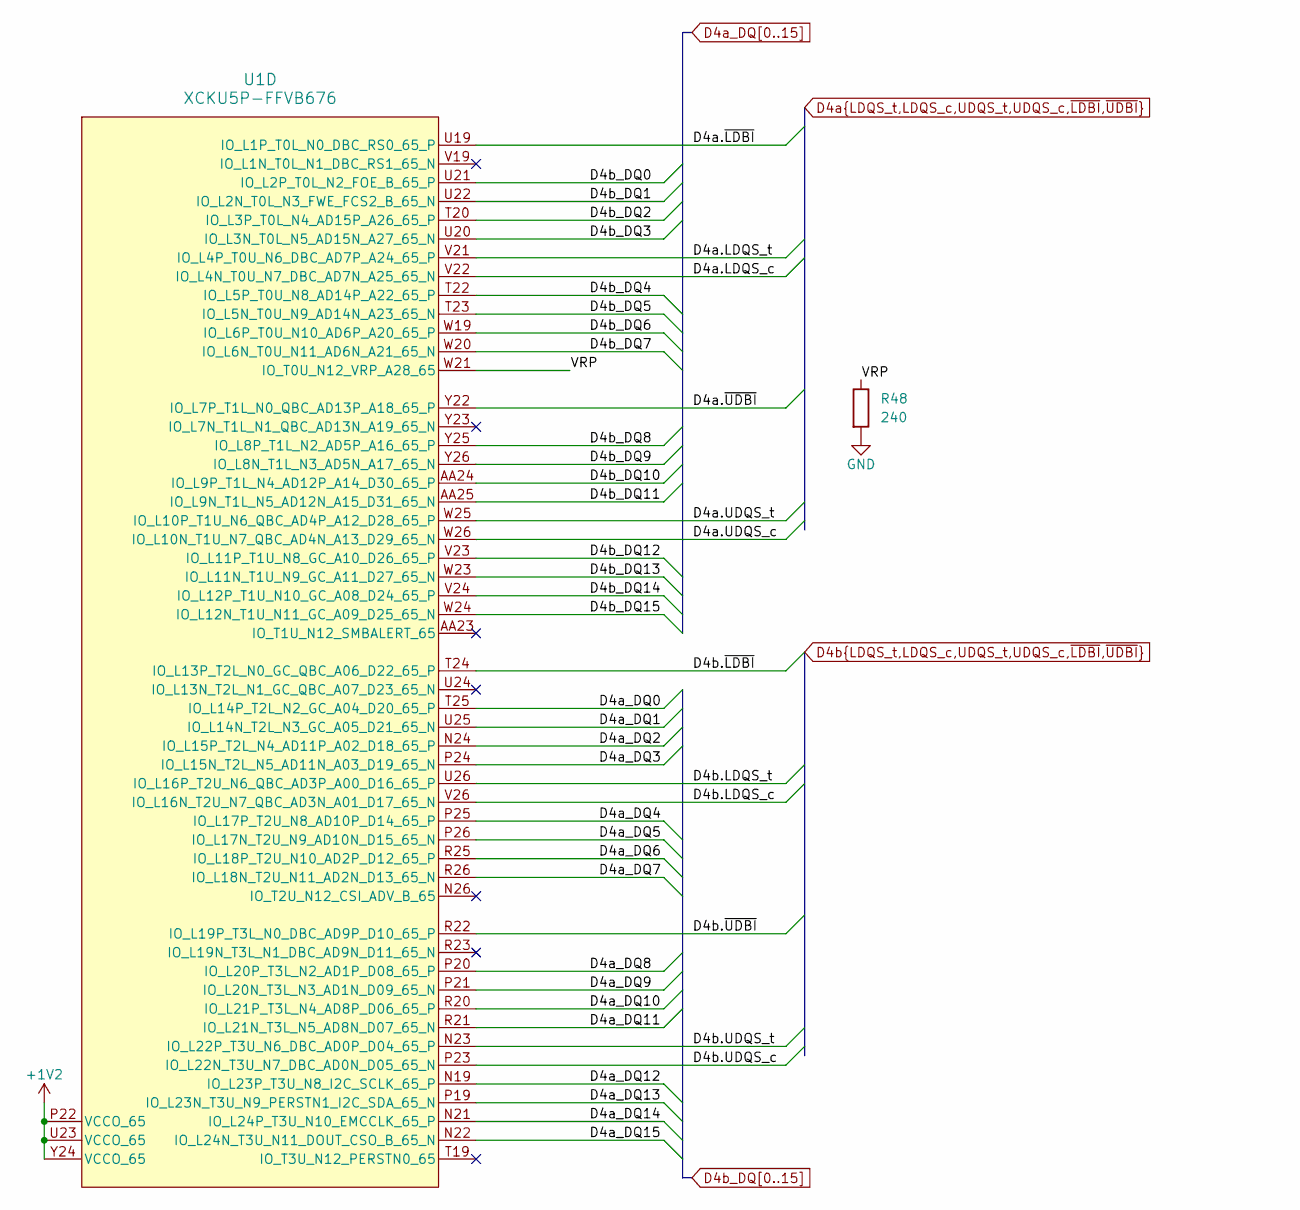
[picture p15: schematic Bank65.kicad_sch]

Parts:
R48: 240; R_0201_0603Metric
U1: XCKU5P-FFVB676; Xilinx_FFG676

Connections:
/FPGA/IO/HP_BANK/Bank65/VRP: R48.1, U1.W21 (IO_T0U_N12_VRP_A28_65)
D4a.LDQS_c: U1.V22 (IO_L4N_T0U_N7_DBC_AD7N_A25_65_N); also elsewhere on the board
D4a.LDQS_t: U1.V21 (IO_L4P_T0U_N6_DBC_AD7P_A24_65_P); also elsewhere on the board
D4a.UDQS_c: U1.W26 (IO_L10N_T1U_N7_QBC_AD4N_A13_D29_65_N); also elsewhere on the board
D4a.UDQS_t: U1.W25 (IO_L10P_T1U_N6_QBC_AD4P_A12_D28_65_P); also elsewhere on the board
D4a.~LDBI: U1.U19 (IO_L1P_T0L_N0_DBC_RS0_65_P); also elsewhere on the board
D4a.~UDBI: U1.Y22 (IO_L7P_T1L_N0_QBC_AD13P_A18_65_P); also elsewhere on the board
D4a_DQ0: U1.T25 (IO_L14P_T2L_N2_GC_A04_D20_65_P); also elsewhere on the board
D4a_DQ1: U1.U25 (IO_L14N_T2L_N3_GC_A05_D21_65_N); also elsewhere on the board
D4a_DQ2: U1.N24 (IO_L15P_T2L_N4_AD11P_A02_D18_65_P); also elsewhere on the board
D4a_DQ3: U1.P24 (IO_L15N_T2L_N5_AD11N_A03_D19_65_N); also elsewhere on the board
D4a_DQ4: U1.P25 (IO_L17P_T2U_N8_AD10P_D14_65_P); also elsewhere on the board
D4a_DQ5: U1.P26 (IO_L17N_T2U_N9_AD10N_D15_65_N); also elsewhere on the board
D4a_DQ6: U1.R25 (IO_L18P_T2U_N10_AD2P_D12_65_P); also elsewhere on the board
D4a_DQ7: U1.R26 (IO_L18N_T2U_N11_AD2N_D13_65_N); also elsewhere on the board
D4a_DQ8: U1.P20 (IO_L20P_T3L_N2_AD1P_D08_65_P); also elsewhere on the board
D4a_DQ9: U1.P21 (IO_L20N_T3L_N3_AD1N_D09_65_N); also elsewhere on the board
D4a_DQ10: U1.R20 (IO_L21P_T3L_N4_AD8P_D06_65_P); also elsewhere on the board
D4a_DQ11: U1.R21 (IO_L21N_T3L_N5_AD8N_D07_65_N); also elsewhere on the board
D4a_DQ12: U1.N19 (IO_L23P_T3U_N8_I2C_SCLK_65_P); also elsewhere on the board
D4a_DQ13: U1.P19 (IO_L23N_T3U_N9_PERSTN1_I2C_SDA_65_N); also elsewhere on the board
D4a_DQ14: U1.N21 (IO_L24P_T3U_N10_EMCCLK_65_P); also elsewhere on the board
D4a_DQ15: U1.N22 (IO_L24N_T3U_N11_DOUT_CSO_B_65_N); also elsewhere on the board
D4b.LDQS_c: U1.V26 (IO_L16N_T2U_N7_QBC_AD3N_A01_D17_65_N); also elsewhere on the board
D4b.LDQS_t: U1.U26 (IO_L16P_T2U_N6_QBC_AD3P_A00_D16_65_P); also elsewhere on the board
D4b.UDQS_c: U1.P23 (IO_L22N_T3U_N7_DBC_AD0N_D05_65_N); also elsewhere on the board
D4b.UDQS_t: U1.N23 (IO_L22P_T3U_N6_DBC_AD0P_D04_65_P); also elsewhere on the board
D4b.~LDBI: U1.T24 (IO_L13P_T2L_N0_GC_QBC_A06_D22_65_P); also elsewhere on the board
D4b.~UDBI: U1.R22 (IO_L19P_T3L_N0_DBC_AD9P_D10_65_P); also elsewhere on the board
D4b_DQ0: U1.U21 (IO_L2P_T0L_N2_FOE_B_65_P); also elsewhere on the board
D4b_DQ1: U1.U22 (IO_L2N_T0L_N3_FWE_FCS2_B_65_N); also elsewhere on the board
D4b_DQ2: U1.T20 (IO_L3P_T0L_N4_AD15P_A26_65_P); also elsewhere on the board
D4b_DQ3: U1.U20 (IO_L3N_T0L_N5_AD15N_A27_65_N); also elsewhere on the board
D4b_DQ4: U1.T22 (IO_L5P_T0U_N8_AD14P_A22_65_P); also elsewhere on the board
D4b_DQ5: U1.T23 (IO_L5N_T0U_N9_AD14N_A23_65_N); also elsewhere on the board
D4b_DQ6: U1.W19 (IO_L6P_T0U_N10_AD6P_A20_65_P); also elsewhere on the board
D4b_DQ7: U1.W20 (IO_L6N_T0U_N11_AD6N_A21_65_N); also elsewhere on the board
D4b_DQ8: U1.Y25 (IO_L8P_T1L_N2_AD5P_A16_65_P); also elsewhere on the board
D4b_DQ9: U1.Y26 (IO_L8N_T1L_N3_AD5N_A17_65_N); also elsewhere on the board
D4b_DQ10: U1.AA24 (IO_L9P_T1L_N4_AD12P_A14_D30_65_P); also elsewhere on the board
D4b_DQ11: U1.AA25 (IO_L9N_T1L_N5_AD12N_A15_D31_65_N); also elsewhere on the board
D4b_DQ12: U1.V23 (IO_L11P_T1U_N8_GC_A10_D26_65_P); also elsewhere on the board
D4b_DQ13: U1.W23 (IO_L11N_T1U_N9_GC_A11_D27_65_N); also elsewhere on the board
D4b_DQ14: U1.V24 (IO_L12P_T1U_N10_GC_A08_D24_65_P); also elsewhere on the board
D4b_DQ15: U1.W24 (IO_L12N_T1U_N11_GC_A09_D25_65_N); also elsewhere on the board
GND: R48.2; also elsewhere on the board

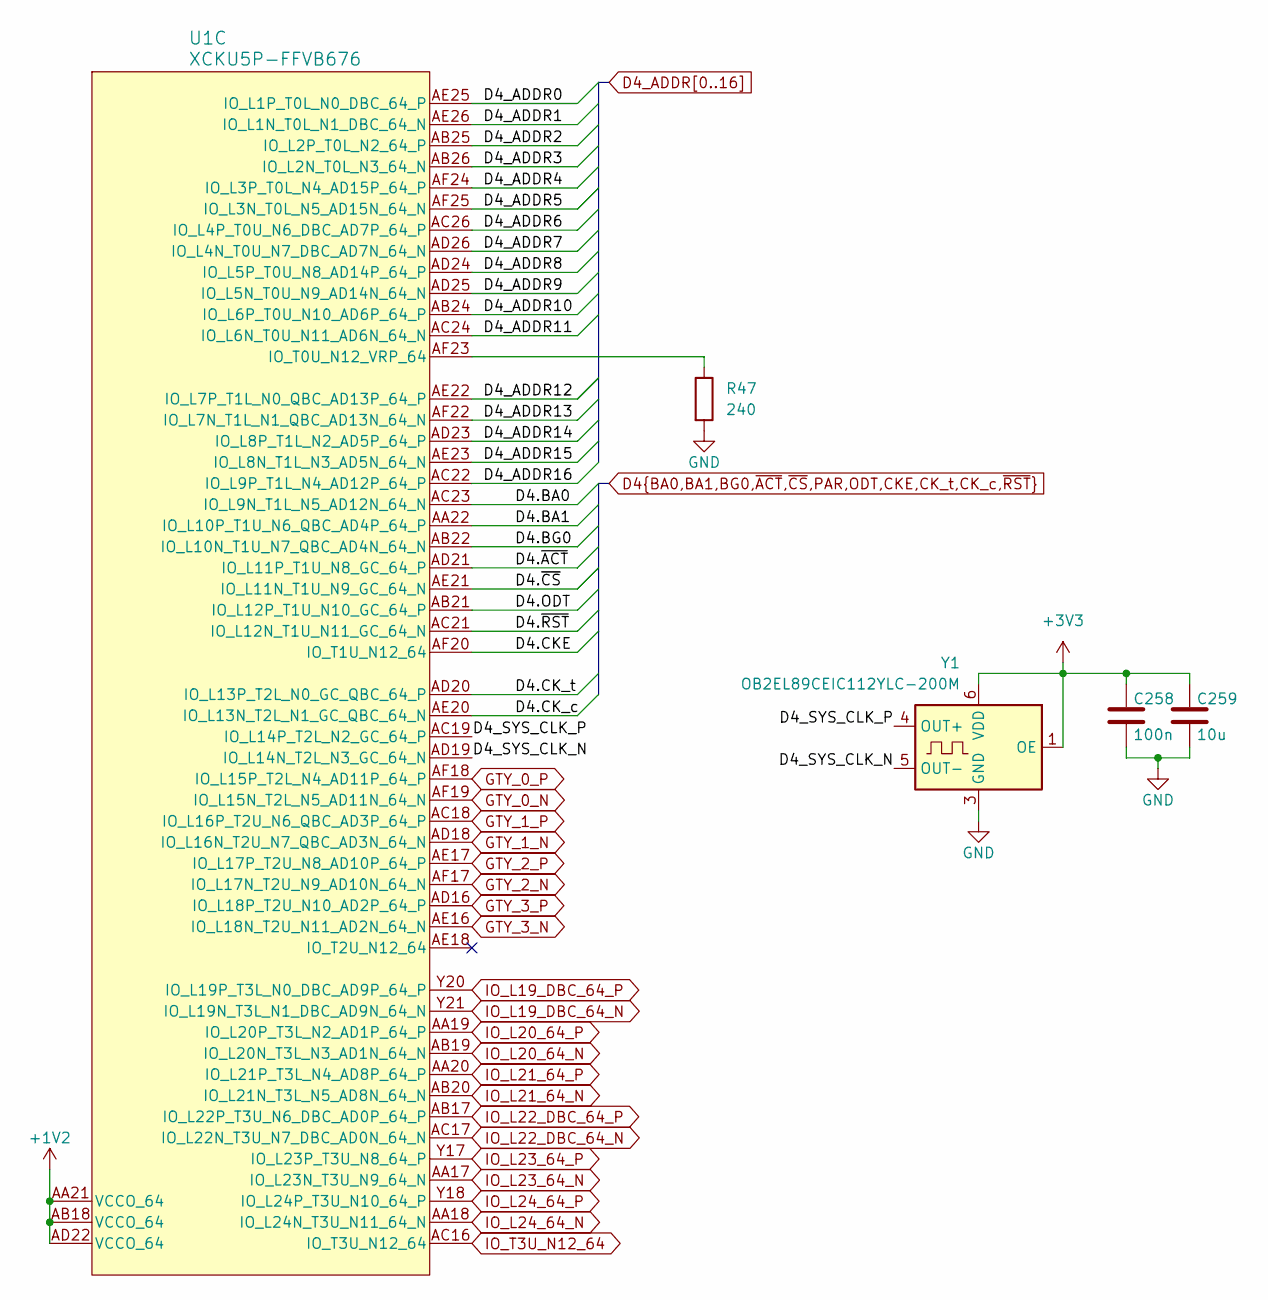
[picture p16: schematic Bank64.kicad_sch]

Parts:
C258: 100n; C_0201_0603Metric
C259: 10u; C_0603_1608Metric
R47: 240; R_0201_0603Metric
U1: XCKU5P-FFVB676; Xilinx_FFG676
Y1: OB2EL89CEIC112YLC-200M; Oscillator_SMD_SiTime_PQFD-6L_3.2x2.5mm

Connections:
+3V3: C258.1, C259.1, Y1.1 (OE), Y1.6 (VDD); also elsewhere on the board
/FPGA/IO/HP_BANK/Bank64/D4_SYS_CLK_N: U1.AD19 (IO_L14N_T2L_N3_GC_64_N), Y1.5 (OUT-)
/FPGA/IO/HP_BANK/Bank64/D4_SYS_CLK_P: U1.AC19 (IO_L14P_T2L_N2_GC_64_P), Y1.4 (OUT+)
D4.BA0: U1.AC23 (IO_L9N_T1L_N5_AD12N_64_N); also elsewhere on the board
D4.BA1: U1.AA22 (IO_L10P_T1U_N6_QBC_AD4P_64_P); also elsewhere on the board
D4.BG0: U1.AB22 (IO_L10N_T1U_N7_QBC_AD4N_64_N); also elsewhere on the board
D4.CKE: U1.AF20 (IO_T1U_N12_64); also elsewhere on the board
D4.CK_c: U1.AE20 (IO_L13N_T2L_N1_GC_QBC_64_N); also elsewhere on the board
D4.CK_t: U1.AD20 (IO_L13P_T2L_N0_GC_QBC_64_P); also elsewhere on the board
D4.ODT: U1.AB21 (IO_L12P_T1U_N10_GC_64_P); also elsewhere on the board
D4.~ACT: U1.AD21 (IO_L11P_T1U_N8_GC_64_P); also elsewhere on the board
D4.~CS: U1.AE21 (IO_L11N_T1U_N9_GC_64_N); also elsewhere on the board
D4.~RST: U1.AC21 (IO_L12N_T1U_N11_GC_64_N); also elsewhere on the board
D4_ADDR0: U1.AE25 (IO_L1P_T0L_N0_DBC_64_P); also elsewhere on the board
D4_ADDR1: U1.AE26 (IO_L1N_T0L_N1_DBC_64_N); also elsewhere on the board
D4_ADDR2: U1.AB25 (IO_L2P_T0L_N2_64_P); also elsewhere on the board
D4_ADDR3: U1.AB26 (IO_L2N_T0L_N3_64_N); also elsewhere on the board
D4_ADDR4: U1.AF24 (IO_L3P_T0L_N4_AD15P_64_P); also elsewhere on the board
D4_ADDR5: U1.AF25 (IO_L3N_T0L_N5_AD15N_64_N); also elsewhere on the board
D4_ADDR6: U1.AC26 (IO_L4P_T0U_N6_DBC_AD7P_64_P); also elsewhere on the board
D4_ADDR7: U1.AD26 (IO_L4N_T0U_N7_DBC_AD7N_64_N); also elsewhere on the board
D4_ADDR8: U1.AD24 (IO_L5P_T0U_N8_AD14P_64_P); also elsewhere on the board
D4_ADDR9: U1.AD25 (IO_L5N_T0U_N9_AD14N_64_N); also elsewhere on the board
D4_ADDR10: U1.AB24 (IO_L6P_T0U_N10_AD6P_64_P); also elsewhere on the board
D4_ADDR11: U1.AC24 (IO_L6N_T0U_N11_AD6N_64_N); also elsewhere on the board
D4_ADDR12: U1.AE22 (IO_L7P_T1L_N0_QBC_AD13P_64_P); also elsewhere on the board
D4_ADDR13: U1.AF22 (IO_L7N_T1L_N1_QBC_AD13N_64_N); also elsewhere on the board
D4_ADDR14: U1.AD23 (IO_L8P_T1L_N2_AD5P_64_P); also elsewhere on the board
D4_ADDR15: U1.AE23 (IO_L8N_T1L_N3_AD5N_64_N); also elsewhere on the board
D4_ADDR16: U1.AC22 (IO_L9P_T1L_N4_AD12P_64_P); also elsewhere on the board
GND: C258.2, C259.2, R47.2, Y1.3 (GND); also elsewhere on the board
GTY_0_N: U1.AF19 (IO_L15N_T2L_N5_AD11N_64_N); also elsewhere on the board
GTY_0_P: U1.AF18 (IO_L15P_T2L_N4_AD11P_64_P); also elsewhere on the board
GTY_1_N: U1.AD18 (IO_L16N_T2U_N7_QBC_AD3N_64_N); also elsewhere on the board
GTY_1_P: U1.AC18 (IO_L16P_T2U_N6_QBC_AD3P_64_P); also elsewhere on the board
GTY_2_N: U1.AF17 (IO_L17N_T2U_N9_AD10N_64_N); also elsewhere on the board
GTY_2_P: U1.AE17 (IO_L17P_T2U_N8_AD10P_64_P); also elsewhere on the board
GTY_3_N: U1.AE16 (IO_L18N_T2U_N11_AD2N_64_N); also elsewhere on the board
GTY_3_P: U1.AD16 (IO_L18P_T2U_N10_AD2P_64_P); also elsewhere on the board
IO_L19N_T3L_N1_DBC_AD9N_64_N: U1.Y21 (IO_L19N_T3L_N1_DBC_AD9N_64_N)
IO_L19P_T3L_N0_DBC_AD9P_64_P: U1.Y20 (IO_L19P_T3L_N0_DBC_AD9P_64_P)
IO_L20N_T3L_N3_AD1N_64_N: U1.AB19 (IO_L20N_T3L_N3_AD1N_64_N)
IO_L20P_T3L_N2_AD1P_64_P: U1.AA19 (IO_L20P_T3L_N2_AD1P_64_P)
IO_L21N_T3L_N5_AD8N_64_N: U1.AB20 (IO_L21N_T3L_N5_AD8N_64_N)
IO_L21P_T3L_N4_AD8P_64_P: U1.AA20 (IO_L21P_T3L_N4_AD8P_64_P)
IO_L22N_T3U_N7_DBC_AD0N_64_N: U1.AC17 (IO_L22N_T3U_N7_DBC_AD0N_64_N)
IO_L22P_T3U_N6_DBC_AD0P_64_P: U1.AB17 (IO_L22P_T3U_N6_DBC_AD0P_64_P)
IO_L23N_T3U_N9_64_N: U1.AA17 (IO_L23N_T3U_N9_64_N)
IO_L23P_T3U_N8_64_P: U1.Y17 (IO_L23P_T3U_N8_64_P)
IO_L24N_T3U_N11_64_N: U1.AA18 (IO_L24N_T3U_N11_64_N)
IO_L24P_T3U_N10_64_P: U1.Y18 (IO_L24P_T3U_N10_64_P)
IO_T3U_N12_64: U1.AC16 (IO_T3U_N12_64)
unnamed: R47.1, U1.AF23 (IO_T0U_N12_VRP_64)

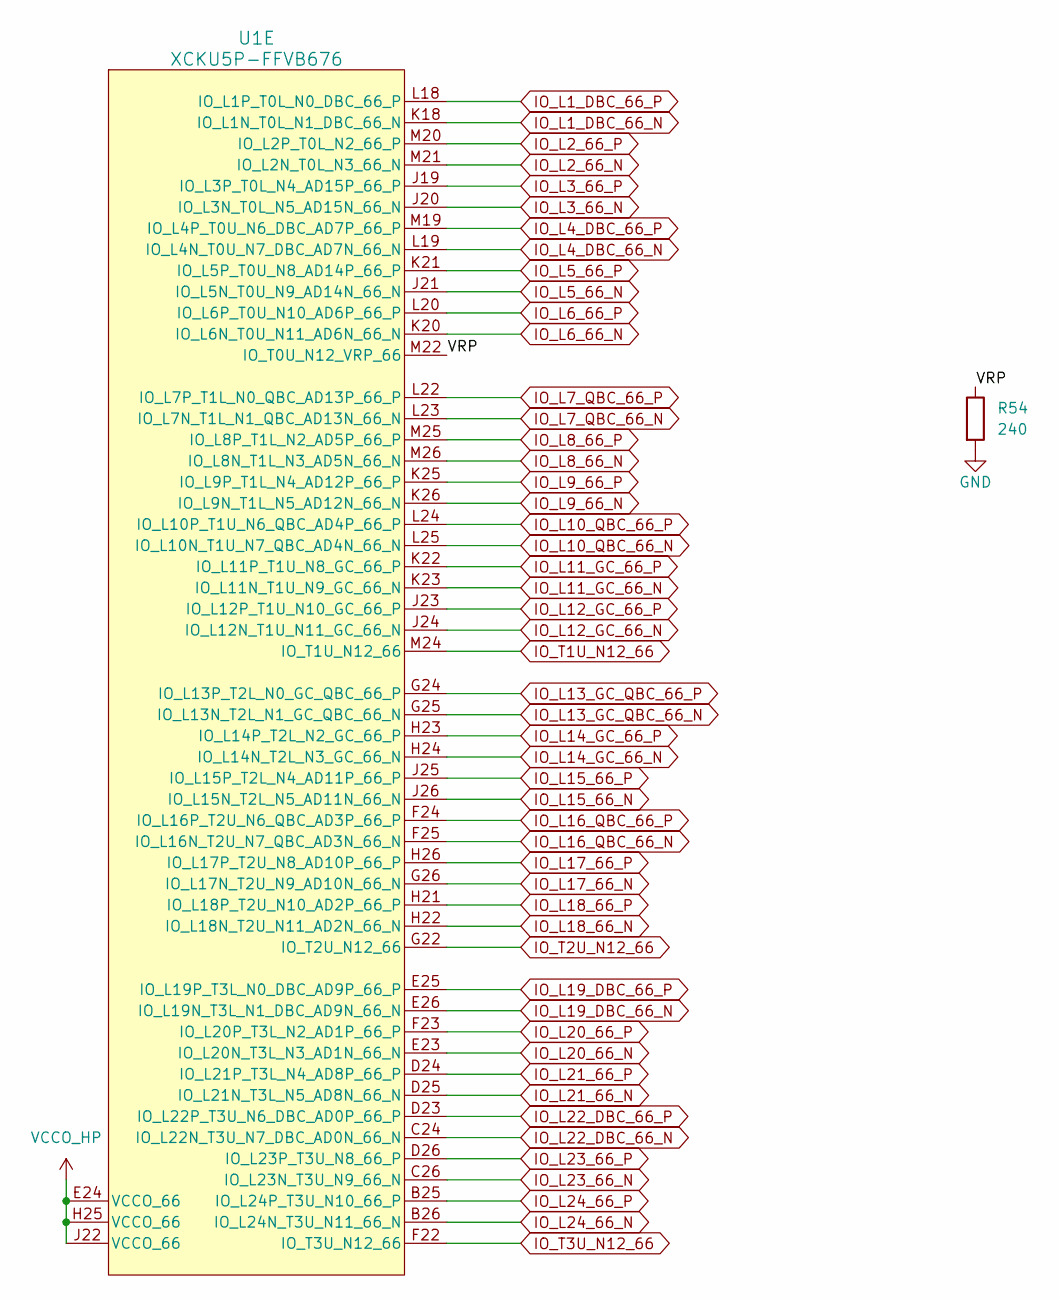
[picture p17: schematic Bank66.kicad_sch]

Parts:
R54: 240; R_0201_0603Metric
U1: XCKU5P-FFVB676; Xilinx_FFG676

Connections:
/FPGA/IO/HP_BANK/Bank66/VRP: R54.1, U1.M22 (IO_T0U_N12_VRP_66)
GND: R54.2; also elsewhere on the board
IO_L1N_T0L_N1_DBC_66_N: U1.K18 (IO_L1N_T0L_N1_DBC_66_N); also elsewhere on the board
IO_L1P_T0L_N0_DBC_66_P: U1.L18 (IO_L1P_T0L_N0_DBC_66_P); also elsewhere on the board
IO_L2N_T0L_N3_66_N: U1.M21 (IO_L2N_T0L_N3_66_N); also elsewhere on the board
IO_L2P_T0L_N2_66_P: U1.M20 (IO_L2P_T0L_N2_66_P); also elsewhere on the board
IO_L3N_T0L_N5_AD15N_66_N: U1.J20 (IO_L3N_T0L_N5_AD15N_66_N); also elsewhere on the board
IO_L3P_T0L_N4_AD15P_66_P: U1.J19 (IO_L3P_T0L_N4_AD15P_66_P); also elsewhere on the board
IO_L4N_T0U_N7_DBC_AD7N_66_N: U1.L19 (IO_L4N_T0U_N7_DBC_AD7N_66_N); also elsewhere on the board
IO_L4P_T0U_N6_DBC_AD7P_66_P: U1.M19 (IO_L4P_T0U_N6_DBC_AD7P_66_P); also elsewhere on the board
IO_L5N_T0U_N9_AD14N_66_N: U1.J21 (IO_L5N_T0U_N9_AD14N_66_N); also elsewhere on the board
IO_L5P_T0U_N8_AD14P_66_P: U1.K21 (IO_L5P_T0U_N8_AD14P_66_P); also elsewhere on the board
IO_L6N_T0U_N11_AD6N_66_N: U1.K20 (IO_L6N_T0U_N11_AD6N_66_N); also elsewhere on the board
IO_L6P_T0U_N10_AD6P_66_P: U1.L20 (IO_L6P_T0U_N10_AD6P_66_P); also elsewhere on the board
IO_L7N_T1L_N1_QBC_AD13N_66_N: U1.L23 (IO_L7N_T1L_N1_QBC_AD13N_66_N); also elsewhere on the board
IO_L7P_T1L_N0_QBC_AD13P_66_P: U1.L22 (IO_L7P_T1L_N0_QBC_AD13P_66_P); also elsewhere on the board
IO_L8N_T1L_N3_AD5N_66_N: U1.M26 (IO_L8N_T1L_N3_AD5N_66_N); also elsewhere on the board
IO_L8P_T1L_N2_AD5P_66_P: U1.M25 (IO_L8P_T1L_N2_AD5P_66_P); also elsewhere on the board
IO_L9N_T1L_N5_AD12N_66_N: U1.K26 (IO_L9N_T1L_N5_AD12N_66_N); also elsewhere on the board
IO_L9P_T1L_N4_AD12P_66_P: U1.K25 (IO_L9P_T1L_N4_AD12P_66_P); also elsewhere on the board
IO_L10N_T1U_N7_QBC_AD4N_66_N: U1.L25 (IO_L10N_T1U_N7_QBC_AD4N_66_N); also elsewhere on the board
IO_L10P_T1U_N6_QBC_AD4P_66_P: U1.L24 (IO_L10P_T1U_N6_QBC_AD4P_66_P); also elsewhere on the board
IO_L11N_T1U_N9_GC_66_N: U1.K23 (IO_L11N_T1U_N9_GC_66_N); also elsewhere on the board
IO_L11P_T1U_N8_GC_66_P: U1.K22 (IO_L11P_T1U_N8_GC_66_P); also elsewhere on the board
IO_L12N_T1U_N11_GC_66_N: U1.J24 (IO_L12N_T1U_N11_GC_66_N); also elsewhere on the board
IO_L12P_T1U_N10_GC_66_P: U1.J23 (IO_L12P_T1U_N10_GC_66_P); also elsewhere on the board
IO_L13N_T2L_N1_GC_QBC_66_N: U1.G25 (IO_L13N_T2L_N1_GC_QBC_66_N); also elsewhere on the board
IO_L13P_T2L_N0_GC_QBC_66_P: U1.G24 (IO_L13P_T2L_N0_GC_QBC_66_P); also elsewhere on the board
IO_L14N_T2L_N3_GC_66_N: U1.H24 (IO_L14N_T2L_N3_GC_66_N); also elsewhere on the board
IO_L14P_T2L_N2_GC_66_P: U1.H23 (IO_L14P_T2L_N2_GC_66_P); also elsewhere on the board
IO_L15N_T2L_N5_AD11N_66_N: U1.J26 (IO_L15N_T2L_N5_AD11N_66_N); also elsewhere on the board
IO_L15P_T2L_N4_AD11P_66_P: U1.J25 (IO_L15P_T2L_N4_AD11P_66_P); also elsewhere on the board
IO_L16N_T2U_N7_QBC_AD3N_66_N: U1.F25 (IO_L16N_T2U_N7_QBC_AD3N_66_N); also elsewhere on the board
IO_L16P_T2U_N6_QBC_AD3P_66_P: U1.F24 (IO_L16P_T2U_N6_QBC_AD3P_66_P); also elsewhere on the board
IO_L17N_T2U_N9_AD10N_66_N: U1.G26 (IO_L17N_T2U_N9_AD10N_66_N); also elsewhere on the board
IO_L17P_T2U_N8_AD10P_66_P: U1.H26 (IO_L17P_T2U_N8_AD10P_66_P); also elsewhere on the board
IO_L18N_T2U_N11_AD2N_66_N: U1.H22 (IO_L18N_T2U_N11_AD2N_66_N); also elsewhere on the board
IO_L18P_T2U_N10_AD2P_66_P: U1.H21 (IO_L18P_T2U_N10_AD2P_66_P); also elsewhere on the board
IO_L19N_T3L_N1_DBC_AD9N_66_N: U1.E26 (IO_L19N_T3L_N1_DBC_AD9N_66_N); also elsewhere on the board
IO_L19P_T3L_N0_DBC_AD9P_66_P: U1.E25 (IO_L19P_T3L_N0_DBC_AD9P_66_P); also elsewhere on the board
IO_L20N_T3L_N3_AD1N_66_N: U1.E23 (IO_L20N_T3L_N3_AD1N_66_N); also elsewhere on the board
IO_L20P_T3L_N2_AD1P_66_P: U1.F23 (IO_L20P_T3L_N2_AD1P_66_P); also elsewhere on the board
IO_L21N_T3L_N5_AD8N_66_N: U1.D25 (IO_L21N_T3L_N5_AD8N_66_N); also elsewhere on the board
IO_L21P_T3L_N4_AD8P_66_P: U1.D24 (IO_L21P_T3L_N4_AD8P_66_P); also elsewhere on the board
IO_L22N_T3U_N7_DBC_AD0N_66_N: U1.C24 (IO_L22N_T3U_N7_DBC_AD0N_66_N); also elsewhere on the board
IO_L22P_T3U_N6_DBC_AD0P_66_P: U1.D23 (IO_L22P_T3U_N6_DBC_AD0P_66_P); also elsewhere on the board
IO_L23N_T3U_N9_66_N: U1.C26 (IO_L23N_T3U_N9_66_N); also elsewhere on the board
IO_L23P_T3U_N8_66_P: U1.D26 (IO_L23P_T3U_N8_66_P); also elsewhere on the board
IO_L24N_T3U_N11_66_N: U1.B26 (IO_L24N_T3U_N11_66_N); also elsewhere on the board
IO_L24P_T3U_N10_66_P: U1.B25 (IO_L24P_T3U_N10_66_P); also elsewhere on the board
IO_T1U_N12_66: U1.M24 (IO_T1U_N12_66); also elsewhere on the board
IO_T2U_N12_66: U1.G22 (IO_T2U_N12_66); also elsewhere on the board
IO_T3U_N12_66: U1.F22 (IO_T3U_N12_66); also elsewhere on the board
VCCO_HP: U1.E24 (VCCO_66), U1.H25 (VCCO_66), U1.J22 (VCCO_66); also elsewhere on the board

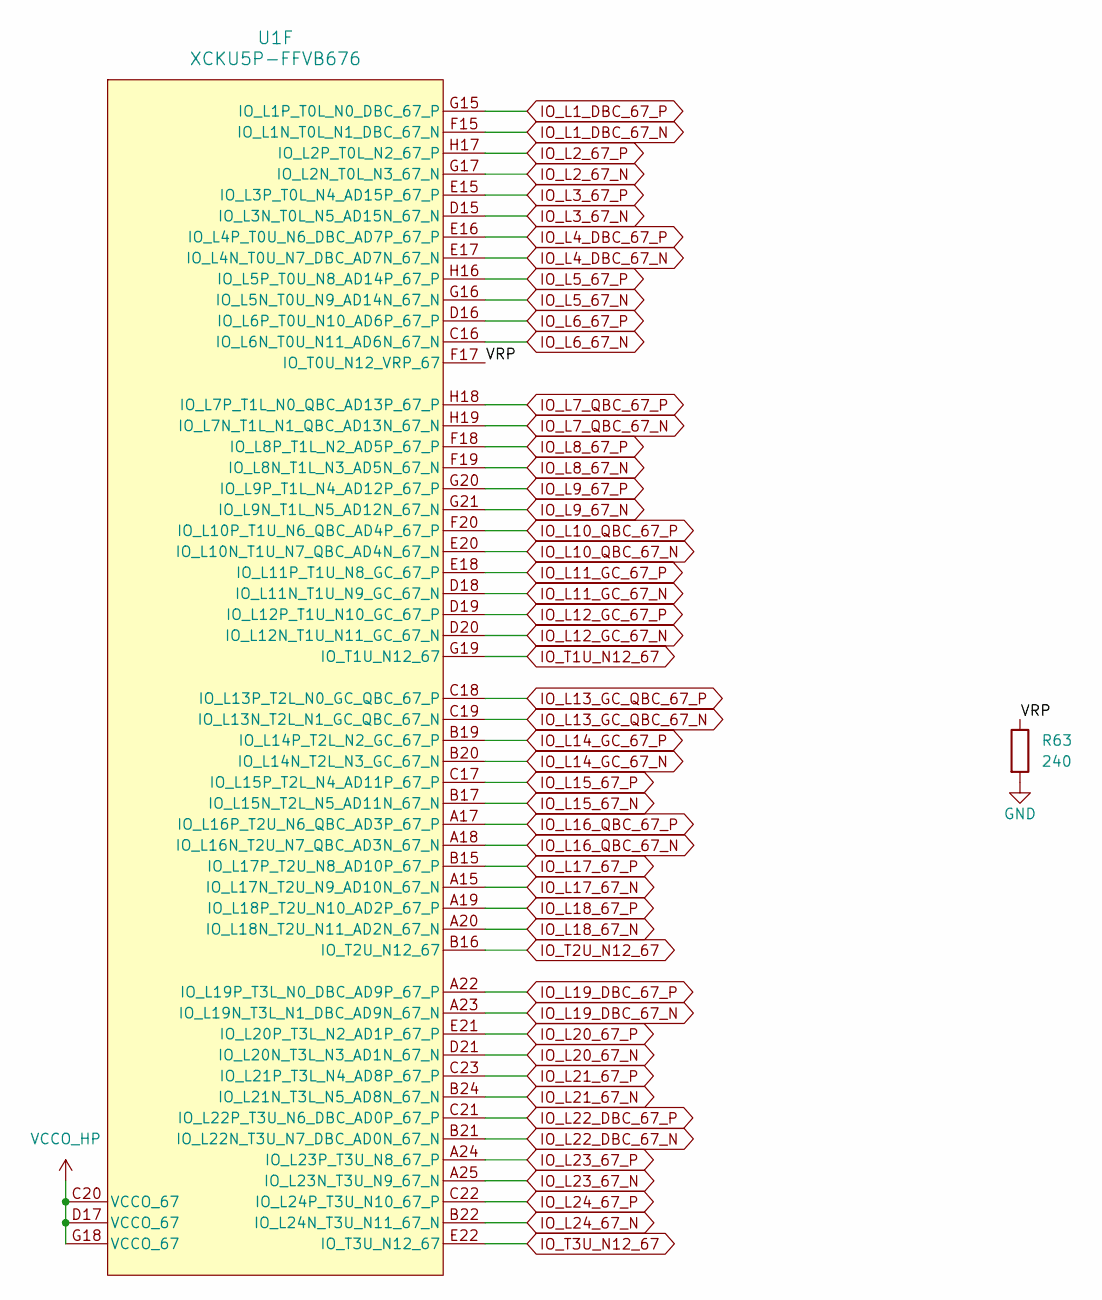
[picture p18: schematic Bank67.kicad_sch]

Parts:
R63: 240; R_0201_0603Metric
U1: XCKU5P-FFVB676; Xilinx_FFG676

Connections:
/FPGA/IO/HP_BANK/Bank67/VRP: R63.1, U1.F17 (IO_T0U_N12_VRP_67)
GND: R63.2; also elsewhere on the board
IO_L1N_T0L_N1_DBC_67_N: U1.F15 (IO_L1N_T0L_N1_DBC_67_N); also elsewhere on the board
IO_L1P_T0L_N0_DBC_67_P: U1.G15 (IO_L1P_T0L_N0_DBC_67_P); also elsewhere on the board
IO_L2N_T0L_N3_67_N: U1.G17 (IO_L2N_T0L_N3_67_N); also elsewhere on the board
IO_L2P_T0L_N2_67_P: U1.H17 (IO_L2P_T0L_N2_67_P); also elsewhere on the board
IO_L3N_T0L_N5_AD15N_67_N: U1.D15 (IO_L3N_T0L_N5_AD15N_67_N); also elsewhere on the board
IO_L3P_T0L_N4_AD15P_67_P: U1.E15 (IO_L3P_T0L_N4_AD15P_67_P); also elsewhere on the board
IO_L4N_T0U_N7_DBC_AD7N_67_N: U1.E17 (IO_L4N_T0U_N7_DBC_AD7N_67_N); also elsewhere on the board
IO_L4P_T0U_N6_DBC_AD7P_67_P: U1.E16 (IO_L4P_T0U_N6_DBC_AD7P_67_P); also elsewhere on the board
IO_L5N_T0U_N9_AD14N_67_N: U1.G16 (IO_L5N_T0U_N9_AD14N_67_N); also elsewhere on the board
IO_L5P_T0U_N8_AD14P_67_P: U1.H16 (IO_L5P_T0U_N8_AD14P_67_P); also elsewhere on the board
IO_L6N_T0U_N11_AD6N_67_N: U1.C16 (IO_L6N_T0U_N11_AD6N_67_N); also elsewhere on the board
IO_L6P_T0U_N10_AD6P_67_P: U1.D16 (IO_L6P_T0U_N10_AD6P_67_P); also elsewhere on the board
IO_L7N_T1L_N1_QBC_AD13N_67_N: U1.H19 (IO_L7N_T1L_N1_QBC_AD13N_67_N); also elsewhere on the board
IO_L7P_T1L_N0_QBC_AD13P_67_P: U1.H18 (IO_L7P_T1L_N0_QBC_AD13P_67_P); also elsewhere on the board
IO_L8N_T1L_N3_AD5N_67_N: U1.F19 (IO_L8N_T1L_N3_AD5N_67_N); also elsewhere on the board
IO_L8P_T1L_N2_AD5P_67_P: U1.F18 (IO_L8P_T1L_N2_AD5P_67_P); also elsewhere on the board
IO_L9N_T1L_N5_AD12N_67_N: U1.G21 (IO_L9N_T1L_N5_AD12N_67_N); also elsewhere on the board
IO_L9P_T1L_N4_AD12P_67_P: U1.G20 (IO_L9P_T1L_N4_AD12P_67_P); also elsewhere on the board
IO_L10N_T1U_N7_QBC_AD4N_67_N: U1.E20 (IO_L10N_T1U_N7_QBC_AD4N_67_N); also elsewhere on the board
IO_L10P_T1U_N6_QBC_AD4P_67_P: U1.F20 (IO_L10P_T1U_N6_QBC_AD4P_67_P); also elsewhere on the board
IO_L11N_T1U_N9_GC_67_N: U1.D18 (IO_L11N_T1U_N9_GC_67_N); also elsewhere on the board
IO_L11P_T1U_N8_GC_67_P: U1.E18 (IO_L11P_T1U_N8_GC_67_P); also elsewhere on the board
IO_L12N_T1U_N11_GC_67_N: U1.D20 (IO_L12N_T1U_N11_GC_67_N); also elsewhere on the board
IO_L12P_T1U_N10_GC_67_P: U1.D19 (IO_L12P_T1U_N10_GC_67_P); also elsewhere on the board
IO_L13N_T2L_N1_GC_QBC_67_N: U1.C19 (IO_L13N_T2L_N1_GC_QBC_67_N); also elsewhere on the board
IO_L13P_T2L_N0_GC_QBC_67_P: U1.C18 (IO_L13P_T2L_N0_GC_QBC_67_P); also elsewhere on the board
IO_L14N_T2L_N3_GC_67_N: U1.B20 (IO_L14N_T2L_N3_GC_67_N); also elsewhere on the board
IO_L14P_T2L_N2_GC_67_P: U1.B19 (IO_L14P_T2L_N2_GC_67_P); also elsewhere on the board
IO_L15N_T2L_N5_AD11N_67_N: U1.B17 (IO_L15N_T2L_N5_AD11N_67_N); also elsewhere on the board
IO_L15P_T2L_N4_AD11P_67_P: U1.C17 (IO_L15P_T2L_N4_AD11P_67_P); also elsewhere on the board
IO_L16N_T2U_N7_QBC_AD3N_67_N: U1.A18 (IO_L16N_T2U_N7_QBC_AD3N_67_N); also elsewhere on the board
IO_L16P_T2U_N6_QBC_AD3P_67_P: U1.A17 (IO_L16P_T2U_N6_QBC_AD3P_67_P); also elsewhere on the board
IO_L17N_T2U_N9_AD10N_67_N: U1.A15 (IO_L17N_T2U_N9_AD10N_67_N); also elsewhere on the board
IO_L17P_T2U_N8_AD10P_67_P: U1.B15 (IO_L17P_T2U_N8_AD10P_67_P); also elsewhere on the board
IO_L18N_T2U_N11_AD2N_67_N: U1.A20 (IO_L18N_T2U_N11_AD2N_67_N); also elsewhere on the board
IO_L18P_T2U_N10_AD2P_67_P: U1.A19 (IO_L18P_T2U_N10_AD2P_67_P); also elsewhere on the board
IO_L19N_T3L_N1_DBC_AD9N_67_N: U1.A23 (IO_L19N_T3L_N1_DBC_AD9N_67_N); also elsewhere on the board
IO_L19P_T3L_N0_DBC_AD9P_67_P: U1.A22 (IO_L19P_T3L_N0_DBC_AD9P_67_P); also elsewhere on the board
IO_L20N_T3L_N3_AD1N_67_N: U1.D21 (IO_L20N_T3L_N3_AD1N_67_N); also elsewhere on the board
IO_L20P_T3L_N2_AD1P_67_P: U1.E21 (IO_L20P_T3L_N2_AD1P_67_P); also elsewhere on the board
IO_L21N_T3L_N5_AD8N_67_N: U1.B24 (IO_L21N_T3L_N5_AD8N_67_N); also elsewhere on the board
IO_L21P_T3L_N4_AD8P_67_P: U1.C23 (IO_L21P_T3L_N4_AD8P_67_P); also elsewhere on the board
IO_L22N_T3U_N7_DBC_AD0N_67_N: U1.B21 (IO_L22N_T3U_N7_DBC_AD0N_67_N); also elsewhere on the board
IO_L22P_T3U_N6_DBC_AD0P_67_P: U1.C21 (IO_L22P_T3U_N6_DBC_AD0P_67_P); also elsewhere on the board
IO_L23N_T3U_N9_67_N: U1.A25 (IO_L23N_T3U_N9_67_N); also elsewhere on the board
IO_L23P_T3U_N8_67_P: U1.A24 (IO_L23P_T3U_N8_67_P); also elsewhere on the board
IO_L24N_T3U_N11_67_N: U1.B22 (IO_L24N_T3U_N11_67_N); also elsewhere on the board
IO_L24P_T3U_N10_67_P: U1.C22 (IO_L24P_T3U_N10_67_P); also elsewhere on the board
IO_T1U_N12_67: U1.G19 (IO_T1U_N12_67); also elsewhere on the board
IO_T2U_N12_67: U1.B16 (IO_T2U_N12_67); also elsewhere on the board
IO_T3U_N12_67: U1.E22 (IO_T3U_N12_67); also elsewhere on the board
VCCO_HP: U1.C20 (VCCO_67), U1.D17 (VCCO_67), U1.G18 (VCCO_67); also elsewhere on the board
