dfdtc/KU5P_Core/KU5P_Core.kicad_pcb

## KiCad design KU5P_Core.kicad_pcb (continued)

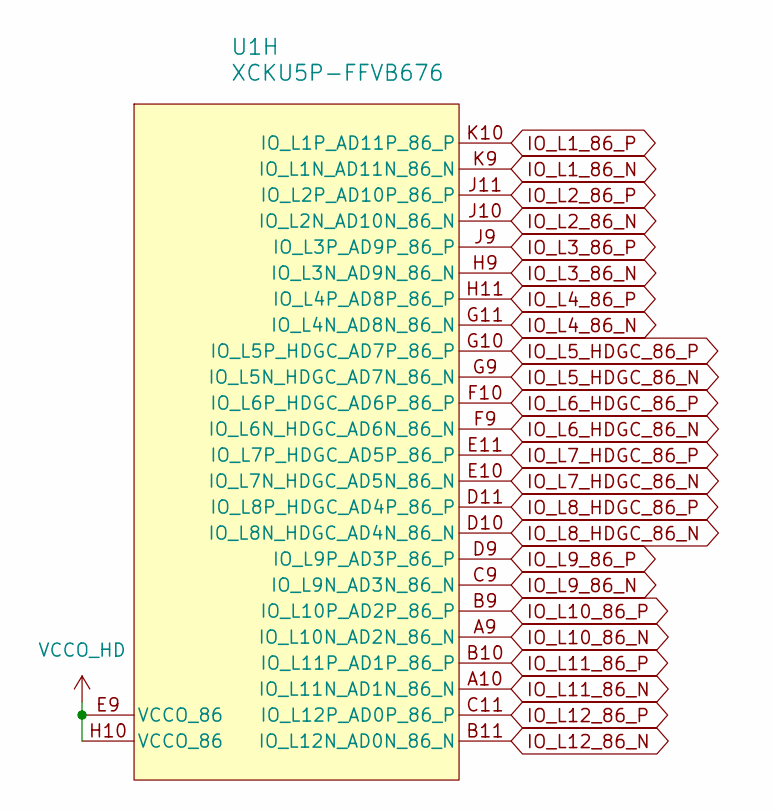
[picture p19: schematic Bank86.kicad_sch]

Parts:
U1: XCKU5P-FFVB676; Xilinx_FFG676

Connections:
IO_L1N_AD11N_86_N: U1.K9 (IO_L1N_AD11N_86_N); also elsewhere on the board
IO_L1P_AD11P_86_P: U1.K10 (IO_L1P_AD11P_86_P); also elsewhere on the board
IO_L2N_AD10N_86_N: U1.J10 (IO_L2N_AD10N_86_N); also elsewhere on the board
IO_L2P_AD10P_86_P: U1.J11 (IO_L2P_AD10P_86_P); also elsewhere on the board
IO_L3N_AD9N_86_N: U1.H9 (IO_L3N_AD9N_86_N); also elsewhere on the board
IO_L3P_AD9P_86_P: U1.J9 (IO_L3P_AD9P_86_P); also elsewhere on the board
IO_L4N_AD8N_86_N: U1.G11 (IO_L4N_AD8N_86_N); also elsewhere on the board
IO_L4P_AD8P_86_P: U1.H11 (IO_L4P_AD8P_86_P); also elsewhere on the board
IO_L5N_HDGC_AD7N_86_N: U1.G9 (IO_L5N_HDGC_AD7N_86_N); also elsewhere on the board
IO_L5P_HDGC_AD7P_86_P: U1.G10 (IO_L5P_HDGC_AD7P_86_P); also elsewhere on the board
IO_L6N_HDGC_AD6N_86_N: U1.F9 (IO_L6N_HDGC_AD6N_86_N); also elsewhere on the board
IO_L6P_HDGC_AD6P_86_P: U1.F10 (IO_L6P_HDGC_AD6P_86_P); also elsewhere on the board
IO_L7N_HDGC_AD5N_86_N: U1.E10 (IO_L7N_HDGC_AD5N_86_N); also elsewhere on the board
IO_L7P_HDGC_AD5P_86_P: U1.E11 (IO_L7P_HDGC_AD5P_86_P); also elsewhere on the board
IO_L8N_HDGC_AD4N_86_N: U1.D10 (IO_L8N_HDGC_AD4N_86_N); also elsewhere on the board
IO_L8P_HDGC_AD4P_86_P: U1.D11 (IO_L8P_HDGC_AD4P_86_P); also elsewhere on the board
IO_L9N_AD3N_86_N: U1.C9 (IO_L9N_AD3N_86_N); also elsewhere on the board
IO_L9P_AD3P_86_P: U1.D9 (IO_L9P_AD3P_86_P); also elsewhere on the board
IO_L10N_AD2N_86_N: U1.A9 (IO_L10N_AD2N_86_N); also elsewhere on the board
IO_L10P_AD2P_86_P: U1.B9 (IO_L10P_AD2P_86_P); also elsewhere on the board
IO_L11N_AD1N_86_N: U1.A10 (IO_L11N_AD1N_86_N); also elsewhere on the board
IO_L11P_AD1P_86_P: U1.B10 (IO_L11P_AD1P_86_P); also elsewhere on the board
IO_L12N_AD0N_86_N: U1.B11 (IO_L12N_AD0N_86_N); also elsewhere on the board
IO_L12P_AD0P_86_P: U1.C11 (IO_L12P_AD0P_86_P); also elsewhere on the board
VCCO_HD: U1.E9 (VCCO_86), U1.H10 (VCCO_86); also elsewhere on the board

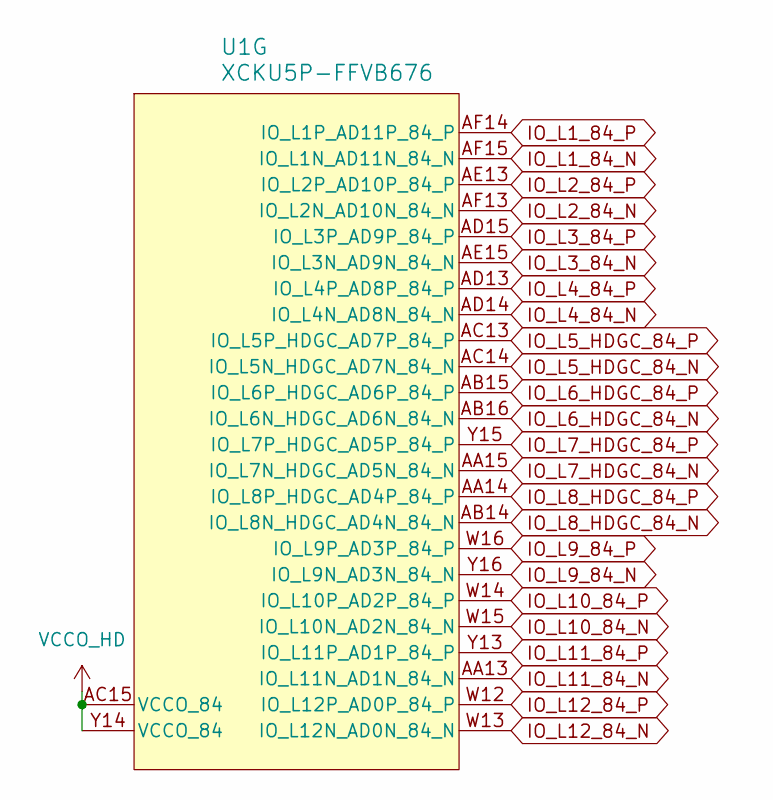
[picture p20: schematic Bank84.kicad_sch]

Parts:
U1: XCKU5P-FFVB676; Xilinx_FFG676

Connections:
IO_L1N_AD11N_84_N: U1.AF15 (IO_L1N_AD11N_84_N); also elsewhere on the board
IO_L1P_AD11P_84_P: U1.AF14 (IO_L1P_AD11P_84_P); also elsewhere on the board
IO_L2N_AD10N_84_N: U1.AF13 (IO_L2N_AD10N_84_N); also elsewhere on the board
IO_L2P_AD10P_84_P: U1.AE13 (IO_L2P_AD10P_84_P); also elsewhere on the board
IO_L3N_AD9N_84_N: U1.AE15 (IO_L3N_AD9N_84_N); also elsewhere on the board
IO_L3P_AD9P_84_P: U1.AD15 (IO_L3P_AD9P_84_P); also elsewhere on the board
IO_L4N_AD8N_84_N: U1.AD14 (IO_L4N_AD8N_84_N); also elsewhere on the board
IO_L4P_AD8P_84_P: U1.AD13 (IO_L4P_AD8P_84_P); also elsewhere on the board
IO_L5N_HDGC_AD7N_84_N: U1.AC14 (IO_L5N_HDGC_AD7N_84_N); also elsewhere on the board
IO_L5P_HDGC_AD7P_84_P: U1.AC13 (IO_L5P_HDGC_AD7P_84_P); also elsewhere on the board
IO_L6N_HDGC_AD6N_84_N: U1.AB16 (IO_L6N_HDGC_AD6N_84_N); also elsewhere on the board
IO_L6P_HDGC_AD6P_84_P: U1.AB15 (IO_L6P_HDGC_AD6P_84_P); also elsewhere on the board
IO_L7N_HDGC_AD5N_84_N: U1.AA15 (IO_L7N_HDGC_AD5N_84_N); also elsewhere on the board
IO_L7P_HDGC_AD5P_84_P: U1.Y15 (IO_L7P_HDGC_AD5P_84_P); also elsewhere on the board
IO_L8N_HDGC_AD4N_84_N: U1.AB14 (IO_L8N_HDGC_AD4N_84_N); also elsewhere on the board
IO_L8P_HDGC_AD4P_84_P: U1.AA14 (IO_L8P_HDGC_AD4P_84_P); also elsewhere on the board
IO_L9N_AD3N_84_N: U1.Y16 (IO_L9N_AD3N_84_N); also elsewhere on the board
IO_L9P_AD3P_84_P: U1.W16 (IO_L9P_AD3P_84_P); also elsewhere on the board
IO_L10N_AD2N_84_N: U1.W15 (IO_L10N_AD2N_84_N); also elsewhere on the board
IO_L10P_AD2P_84_P: U1.W14 (IO_L10P_AD2P_84_P); also elsewhere on the board
IO_L11N_AD1N_84_N: U1.AA13 (IO_L11N_AD1N_84_N); also elsewhere on the board
IO_L11P_AD1P_84_P: U1.Y13 (IO_L11P_AD1P_84_P); also elsewhere on the board
IO_L12N_AD0N_84_N: U1.W13 (IO_L12N_AD0N_84_N); also elsewhere on the board
IO_L12P_AD0P_84_P: U1.W12 (IO_L12P_AD0P_84_P); also elsewhere on the board
VCCO_HD: U1.AC15 (VCCO_84), U1.Y14 (VCCO_84); also elsewhere on the board

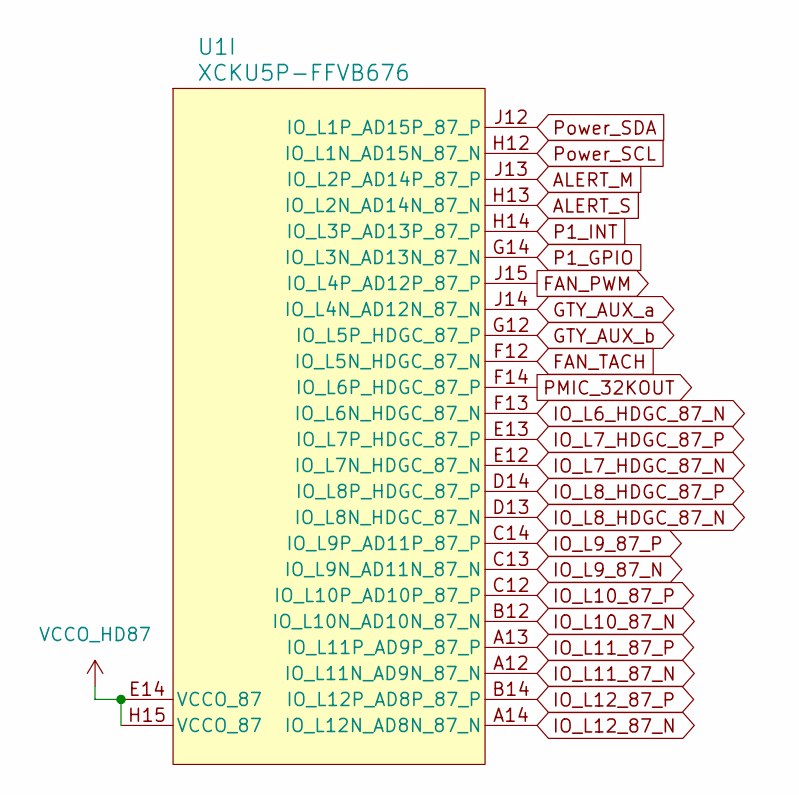
[picture p21: schematic Bank87.kicad_sch]

Parts:
U1: XCKU5P-FFVB676; Xilinx_FFG676

Connections:
ALERT_M: U1.J13 (IO_L2P_AD14P_87_P); also elsewhere on the board
ALERT_S: U1.H13 (IO_L2N_AD14N_87_N); also elsewhere on the board
FAN_PWM: U1.J15 (IO_L4P_AD12P_87_P); also elsewhere on the board
FAN_TACH: U1.F12 (IO_L5N_HDGC_87_N); also elsewhere on the board
GTY_AUX_a: U1.J14 (IO_L4N_AD12N_87_N); also elsewhere on the board
GTY_AUX_b: U1.G12 (IO_L5P_HDGC_87_P); also elsewhere on the board
IO_L6N_HDGC_87_N: U1.F13 (IO_L6N_HDGC_87_N); also elsewhere on the board
IO_L7N_HDGC_87_N: U1.E12 (IO_L7N_HDGC_87_N); also elsewhere on the board
IO_L7P_HDGC_87_P: U1.E13 (IO_L7P_HDGC_87_P); also elsewhere on the board
IO_L8N_HDGC_87_N: U1.D13 (IO_L8N_HDGC_87_N); also elsewhere on the board
IO_L8P_HDGC_87_P: U1.D14 (IO_L8P_HDGC_87_P); also elsewhere on the board
IO_L9N_AD11N_87_N: U1.C13 (IO_L9N_AD11N_87_N); also elsewhere on the board
IO_L9P_AD11P_87_P: U1.C14 (IO_L9P_AD11P_87_P); also elsewhere on the board
IO_L10N_AD10N_87_N: U1.B12 (IO_L10N_AD10N_87_N); also elsewhere on the board
IO_L10P_AD10P_87_P: U1.C12 (IO_L10P_AD10P_87_P); also elsewhere on the board
IO_L11N_AD9N_87_N: U1.A12 (IO_L11N_AD9N_87_N); also elsewhere on the board
IO_L11P_AD9P_87_P: U1.A13 (IO_L11P_AD9P_87_P); also elsewhere on the board
IO_L12N_AD8N_87_N: U1.A14 (IO_L12N_AD8N_87_N); also elsewhere on the board
IO_L12P_AD8P_87_P: U1.B14 (IO_L12P_AD8P_87_P); also elsewhere on the board
P1_GPIO: U1.G14 (IO_L3N_AD13N_87_N); also elsewhere on the board
P1_INT: U1.H14 (IO_L3P_AD13P_87_P); also elsewhere on the board
PMIC_32KOUT: U1.F14 (IO_L6P_HDGC_87_P); also elsewhere on the board
Power_SCL: U1.H12 (IO_L1N_AD15N_87_N); also elsewhere on the board
Power_SDA: U1.J12 (IO_L1P_AD15P_87_P); also elsewhere on the board
VCCO_HD87: U1.E14 (VCCO_87), U1.H15 (VCCO_87); also elsewhere on the board

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
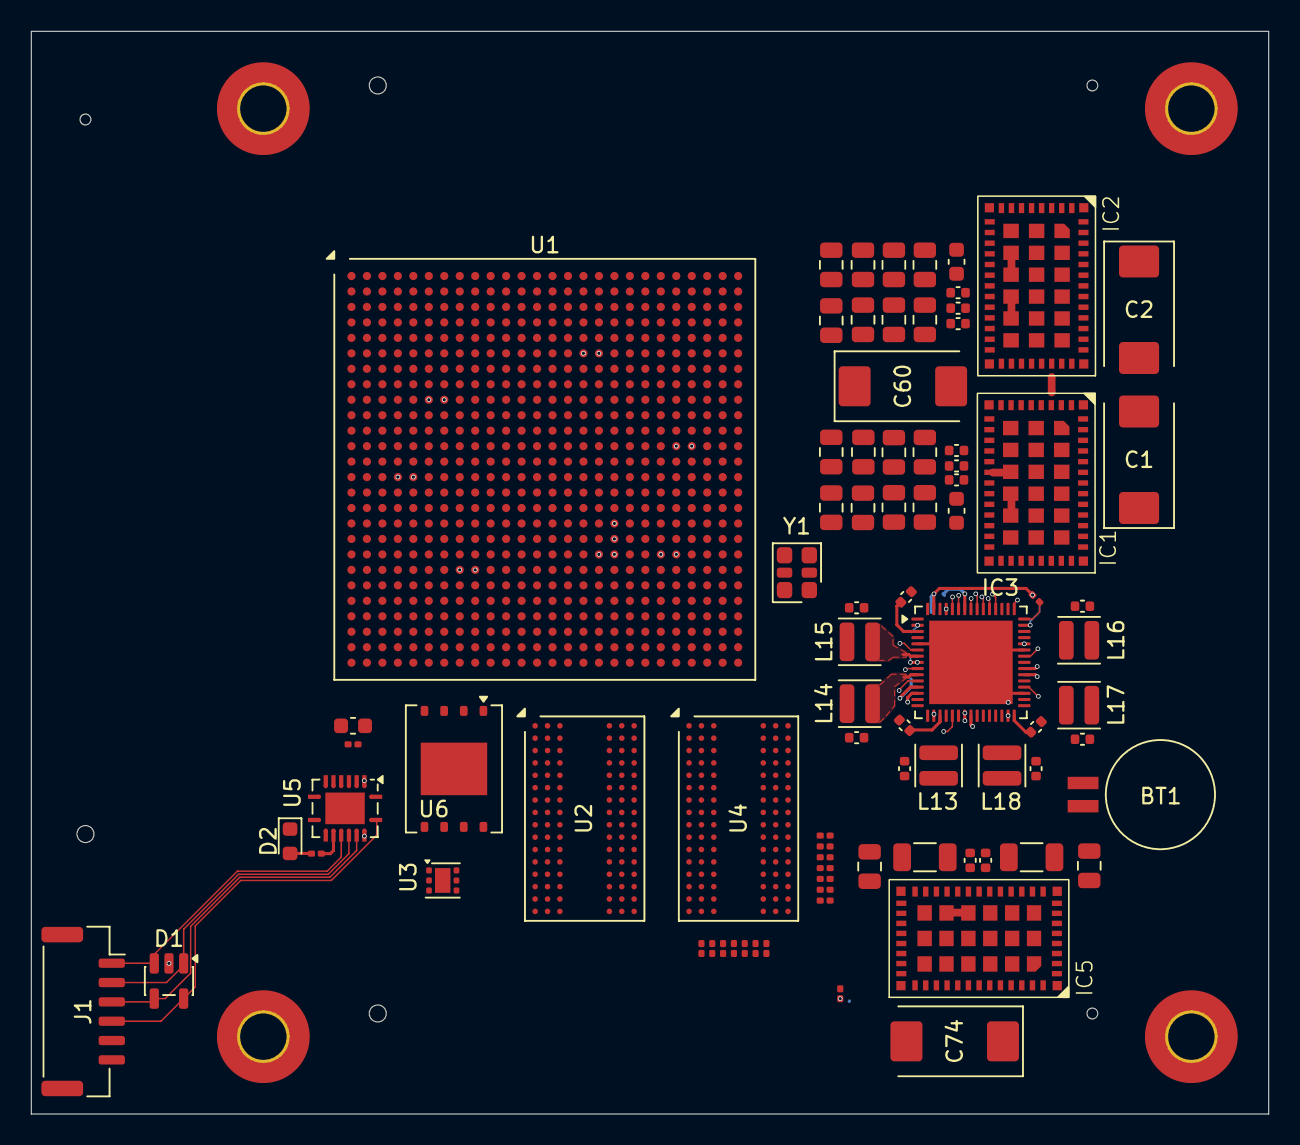
[picture p22: board KU5P_Core.kicad_pcb from above]

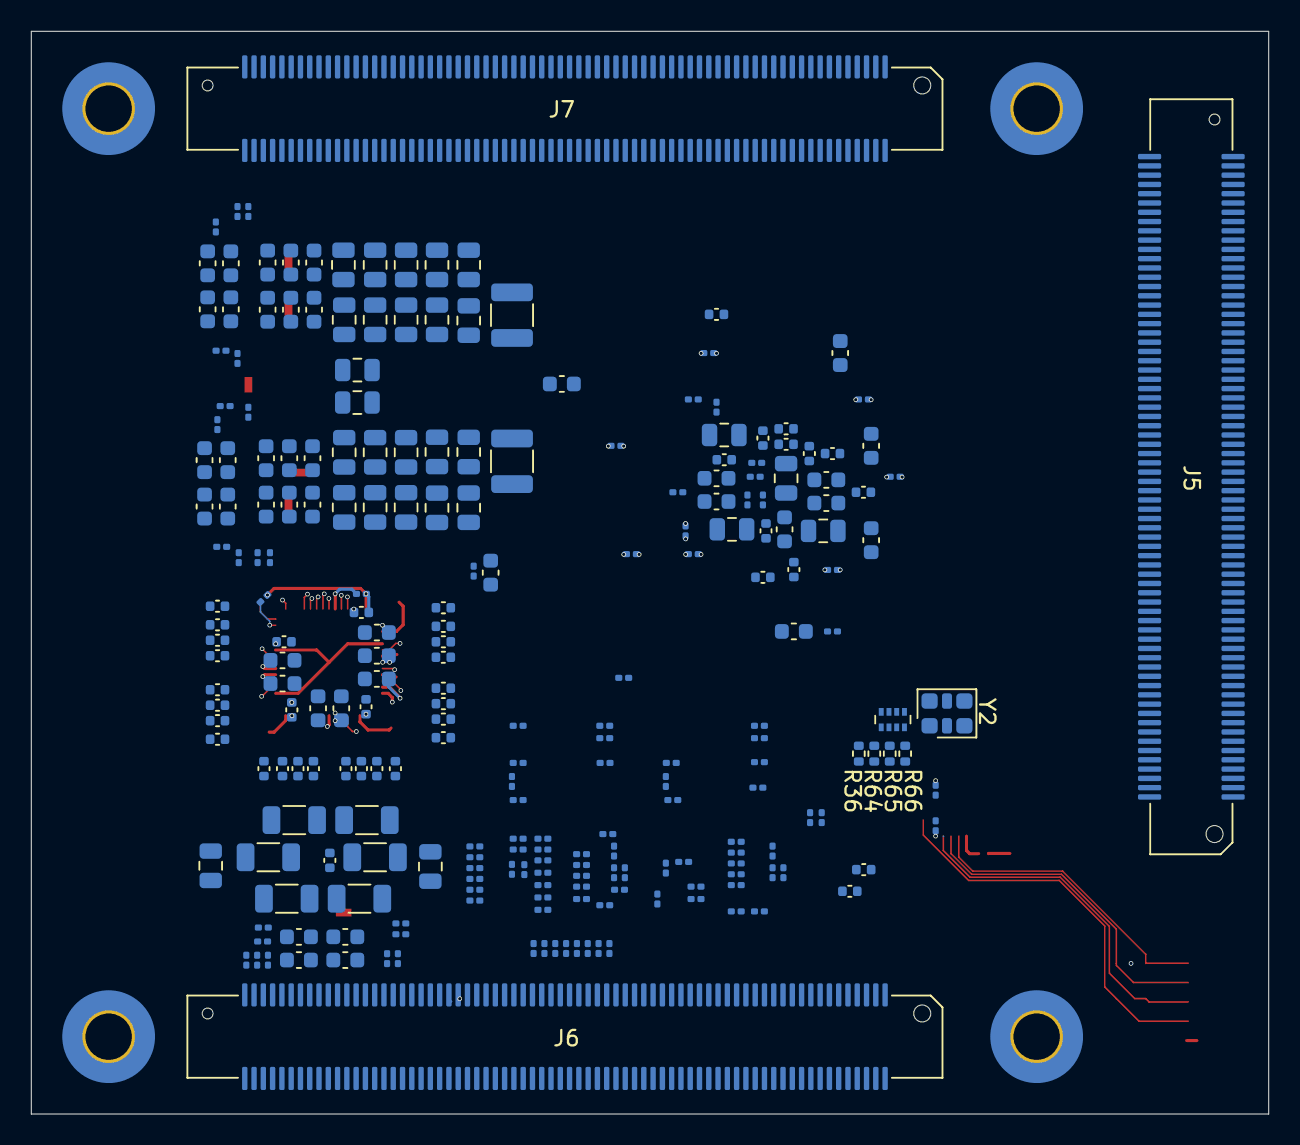
[picture p23: board KU5P_Core.kicad_pcb from below]

Board: 8 copper layers, 80.0 x 70.0 mm, 332 parts (239 on the bottom side), 432 nets.
