dfdtc/KU5P_Core/(commit log)

2026-07-30 resp init
    [1.8V_digi.kicad_sch, 5V_Rail.kicad_sch, B2B_CONN.kicad_sch, Bank64.kicad_sch, Bank65.kicad_sch, Bank66.kicad_sch, Bank67.kicad_sch, Bank84.kicad_sch]
2026-08-01 <feat>: Modified Power Tree
    [5V_Rail.kicad_sch, Bank87.kicad_sch, FAN.kicad_sch, FPGA_SYS.kicad_sch, P1.kicad_sch, Power.kicad_sch]
2026-08-09 modified Power config
    [P1.kicad_sch, Power.kicad_sch]
2026-08-11 finishing schematic
    [5V_Rail.kicad_sch, Bank64.kicad_sch, Bank65.kicad_sch, Bank66.kicad_sch, Bank67.kicad_sch, Bank84.kicad_sch, Bank86.kicad_sch, Bank87.kicad_sch]
2026-09-22 sync works
    [5V_Rail.kicad_sch, Bank64.kicad_sch, DDR4.kicad_sch, DDR4_TERM.kicad_sch, Decap.kicad_sch, FAN.kicad_sch, FPGA_Power.kicad_sch, FPGA_SYS.kicad_sch]
2026-09-22 change net name to of IO diff pairs, add a scripts for name modification
    [Bank64.kicad_sch, Bank66.kicad_sch, Bank67.kicad_sch, Bank84.kicad_sch, Bank86.kicad_sch, Bank87.kicad_sch, HD_BANK.kicad_sch, HP_BANK.kicad_sch]
